Fernandaxx/TallerDeProyectoI/documentation/informe/images/pcb_3d.png

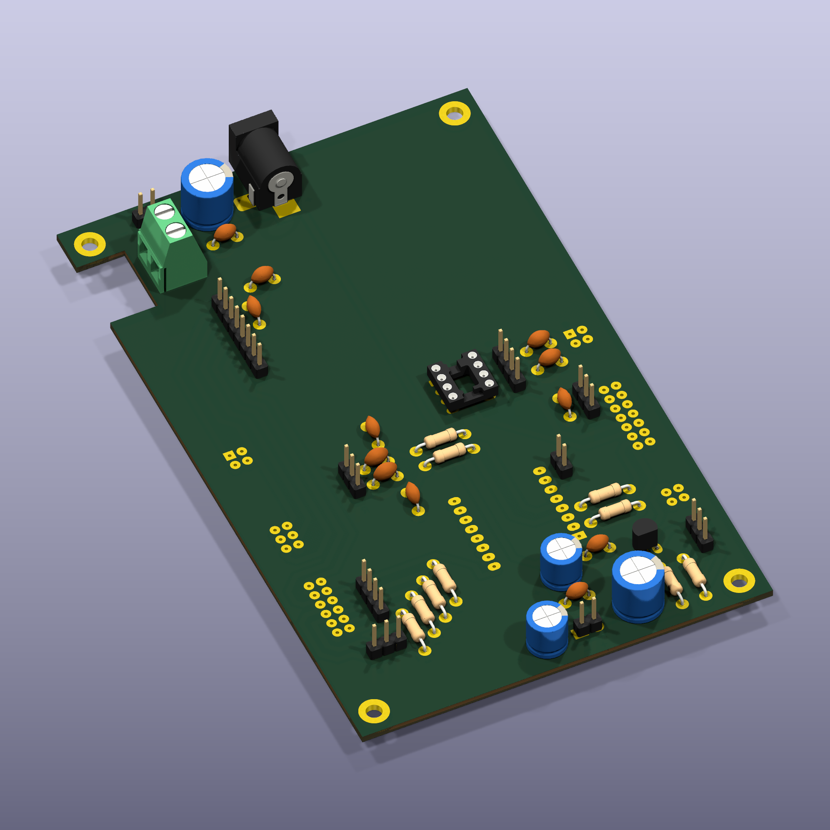
documentation/informe/images/pcb_3d.png
