Fernandaxx/TallerDeProyectoI/ejemplos/sapi/lcd/lcd_i2c/I2C expander PCF8574/LCD I2C.PNG

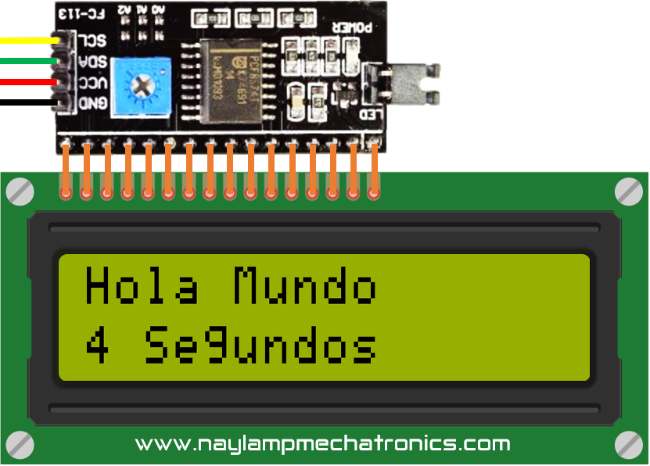
ejemplos/sapi/lcd/lcd_i2c/I2C expander PCF8574/LCD I2C.PNG
