Fernandaxx/TallerDeProyectoI/ejemplos/freertos_book/Readme.md

# Examples of book: "Mastering the FreeRTOS Real Time Kernel, a Hands-On Tutorial Guide" by Richard Barry

https://www.freertos.org/Documentation/RTOS_book.html

- **Example001**: Creating tasks.
- **Example002**: Using the task parameter.
- **Example003**: Experimenting with priorities.
- **Example004**: Using the Blocked state to create delay.
- **Example005**: Converting the example tasks to use vTaskDelayUntil().
- **Example006**: Combining blocking and non-blocking tasks.
- **Example007**: Defining an idle task hook function.
- **Example008**: Changing task priorities.
- **Example009**: Deleting tasks.
- **Example010**: Blocking when receiving from a queue.
- **Example011**: Blocking when sending to a queue or sending structures on a queue.
- **Example012**: Using a queue set.
- **Example013**: Creating one-shot and auto-reload timers.
- **Example014**: Using the callback function parameter and the software timer ID.
- **Example015**: Resetting a software timer.
- **Example016**: Using a binary semaphore to synchronize a task with an interrupt.
- **Example017**: Using a counting semaphore to synchronize a task with an interrupt.
- **Example018**: Centralized deferred interrupt processing.
- **Example019**: Sending and receiving on a queue from within an interrupt.
- **Example020**: Re-writing vPrintString() to use a semaphore.
- **Example021**: Re-writing vPrintString() to use a gatekeeper task.
- **Example022**: Experimenting with event groups.
- **Example023**: Synchronizing tasks.
- **Example024**: Using a task notification in place of a semaphore, method 1.
- **Example025**: Using a task notification in place of a semaphore, method 2.

Examples ported from FreeRTOS v8, to FreeRTOS v10 by Eric Pernia and Martin Ribelotta.

More information at: https://aws.amazon.com/es/freertos/
