Fernandaxx/TallerDeProyectoI/documentation/informe/InformeInicial.pdf

## E0306 - Taller de Proyecto I

# Tocadiscos RFID/NFC

## «Reproductor musical interactivo con selección mediante RFID/NFC»

## Informe inicial

Acuña, Lucia - 03213/1
acunalucia064@gmail.com

Avila Montoya, Eygleen Fernanda - 02931/2 eygleen.avila@alu.ing.unlp.edu.ar

Bejarano, Abril - 03339/5
abril.bejarano@alu.ing.unlp.edu.ar

Seijo, Gerónimo - 01859/7
seijo.geronimo@alu.ing.unlp.edu.ar

Universidad Nacional de La Plata 5 de octubre de 2026

E0306 Taller de Proyecto I
Tocadisco RFID/NFC | Año 2026

## Índice

## 1. Introducción

La forma de escuchar música ha cambiado considerablemente con el avance de la tecnología. Los tocadiscos y discos de vinilo, además de cumplir una función de reproducción, se caracterizan por ofrecer una experiencia física y visual que aún hoy conserva un fuerte valor estético y nostálgico. A partir de esta idea surge el presente proyecto, que busca combinar esa forma de interacción con un sistema de reproducción musical digital.

El proyecto consiste en desarrollar un reproductor musical interactivo controlado por una placa EDU-CIAA-NXP. El usuario seleccionará la música mediante discos físicos impresos que incorporarán etiquetas RFID/NFC. Al colocar un disco sobre el dispositivo, el sistema lo identificará y reproducirá la canción o conjunto de canciones asociado. Además, una pantalla mostrará información básica sobre el estado de reproducción.

En la actualidad, la reproducción de música digital y los sistemas de identificación RFID/NFC son tecnologías ampliamente utilizadas. En este proyecto se combinan para ofrecer una forma de interacción diferente a la de los reproductores convencionales, utilizando un objeto físico para seleccionar contenido digital. Como mejoras adicionales, se contempla incorporar un sistema de asociación configurable entre discos y canciones con almacenamiento persistente e iluminación con secuencias preprogramadas mediante LEDs direccionables.

El principal desafío será integrar y coordinar los distintos componentes mediante la EDU-CIAA-NXP, garantizando el correcto funcionamiento de la identificación, la reproducción de audio, la señalización visual y la alimentación del sistema. De esta manera, el proyecto permitirá aplicar conocimientos de electrónica, programación y sistemas embebidos en el desarrollo de un prototipo funcional.

## 2. Objetivo

## 2.1. Objetivo general

Desarrollar un prototipo funcional de reproductor de música interactivo que, mediante la lectura de etiquetas RFID/NFC, reproduzca pistas de audio almacenadas localmente e incorpore un mecanismo giratorio a modo de tocadiscos, controlado íntegramente por la placa EDU-CIAA-NXP. De forma complementaria, y sujeto a la disponibilidad de tiempo, el prototipo incorpora un modo de asignación de canciones con almacenamiento persistente y secuencias lumínicas con LEDs NeoPixel.

## 2.2. Objetivos primarios

- Identificar cada disco mediante una etiqueta RFID/NFC.
- Asociar cada disco identificado con una canción o conjunto de canciones.
- Reproducir archivos de audio almacenados localmente.
- Mostrar en una pantalla información básica sobre el estado del sistema y la reproducción.
- Integrar los distintos módulos y periféricos bajo el control de la EDU-CIAA-NXP.

- Diseñar una placa de conexión que permita integrar los componentes del sistema de forma ordenada y segura.
- Incorporar un mecanismo que permita hacer girar el disco durante la reproducción, simulando el funcionamiento visual de un tocadiscos.

## 2.3. Objetivos secundarios

- Incorporar LEDs NeoPixel con secuencias preprogramadas según la canción.
- Asignación configurable y persistente de canciones: incorporar un modo de configuración que permita asociar una etiqueta RFID/NFC a una canción sin modificar el código del programa, guardando dicha asociación en una memoria EEPROM externa para que persista tras el reinicio del sistema.
- Incorporar controles físicos para funciones básicas de reproducción, como pausa, cambio de pista o ajuste de volumen.

## 2.4. Descripción técnico-conceptual

El sistema se organiza en torno a la placa EDU-CIAA-NXP, que funciona como unidad central de control y coordina los distintos módulos del proyecto. El lector RFID/NFC MFRC522 se comunica mediante SPI, la pantalla OLED mediante I²C y el módulo de reproducción DFPlayer Mini mediante UART. El procesamiento del audio es realizado por el propio DFPlayer Mini, mientras que la EDU-CIAA se encarga de controlar el funcionamiento general del sistema. En la Fig. 1 se presenta el diagrama en bloques del sistema a desarrollar.

El funcionamiento comienza cuando el usuario coloca un disco sobre el reproductor. El lector RFID/NFC obtiene el identificador de la etiqueta incorporada al disco y la EDU-CIAA busca la canción o lista de canciones asociada. A continuación, envía al DFPlayer Mini la orden de reproducción del archivo almacenado en la tarjeta microSD. La señal de audio se dirige al amplificador PAM8403 y posteriormente al parlante, mientras que la pantalla OLED muestra información sobre el estado de la reproducción y el motor paso a paso 28BYJ-48 con su controlador ULN2003 hace girar el disco mientras se reproduce la música.

Como objetivos secundarios, se prevé una memoria EEPROM externa para almacenar las asociaciones entre las etiquetas RFID/NFC y las canciones, permitiendo conservarlas aun después de apagar o reiniciar el sistema. La EEPROM compartiría el bus I²C con la pantalla OLED. Asimismo, se contempla incorporar una tira o arreglo de LEDs NeoPixel conectados a un pin GPIO de la placa para generar secuencias visuales preprogramadas acordes a la canción en reproducción.

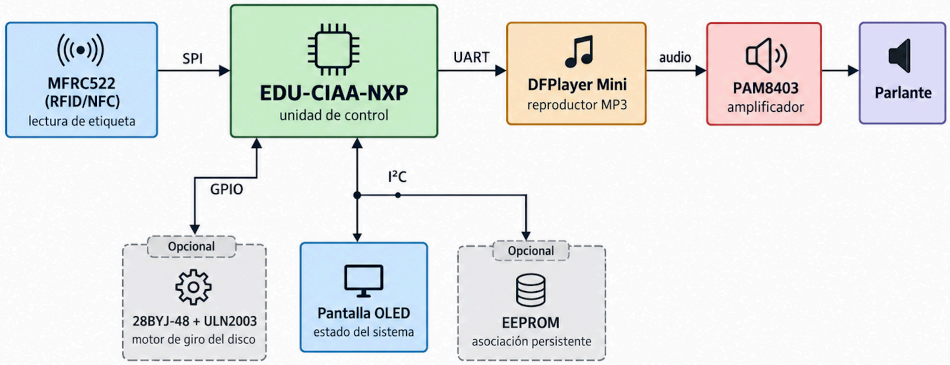
[picture p89: figure]

Fig. 1: Diagrama en bloques del sistema.

## 2.4.1. Alimentación del sistema

La alimentación del sistema partirá de una fuente de 5 V. Los módulos de audio y el motor utilizarán el dominio de 5 V, mientras que los dispositivos que trabajan con lógica de 3,3 V utilizarán el correspondiente nivel de alimentación. De implementarse los LEDs NeoPixel, se alimentarán también desde la línea de 5 V contemplando su demanda de corriente.

La EDU-CIAA-NXP dispone de líneas de 5 V y 3,3 V en sus conectores de expansión. Todos los módulos compartirán una referencia de masa común (GND). En la Fig. 2 se presenta el esquema general de alimentación previsto para el sistema.

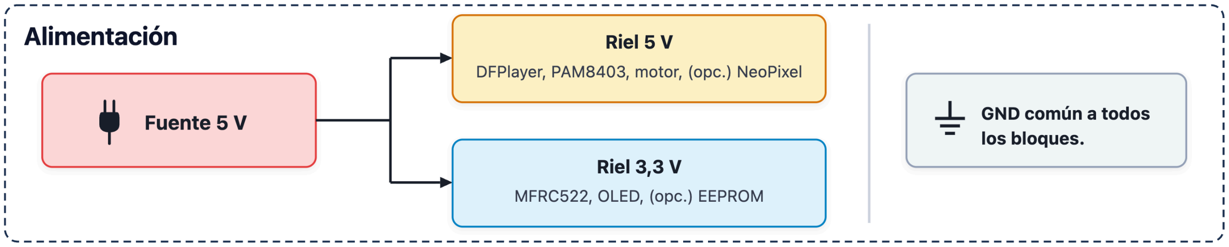
[picture p90: figure]

Fig. 2: Esquema general de alimentación del sistema.

## 3. Análisis de requerimientos

## 3.1. Requerimientos funcionales de hardware

## 3.1.1. Primarios

1. El sistema debe utilizar la placa EDU-CIAA-NXP como unidad central de control.
2. Debe incorporar un lector MFRC522 para identificar etiquetas RFID/NFC mediante comunicación SPI.
3. Debe incorporar un módulo DFPlayer Mini para reproducir archivos de audio almacenados en una tarjeta microSD y comunicarse con la EDU-CIAA mediante UART.

4. Debe incorporar un amplificador PAM8403 y un parlante compatible para la reproducción del audio.
5. Debe incorporar una pantalla OLED comunicada mediante I²C para mostrar información del sistema.
6. El sistema debe contar con una alimentación de 5 V y disponer de los niveles de tensión necesarios para los módulos que trabajen a 3,3 V, manteniendo una masa común.
7. Los módulos externos deben integrarse mediante una placa tipo poncho (PCB) compatible con los conectores de expansión de la EDU-CIAA-NXP.
8. Debe incorporar un motor paso a paso 28BYJ-48 con controlador ULN2003 para hacer girar el disco durante la reproducción.

## 3.1.2. Secundarios

9. Podrá incorporarse una tira o arreglo de LEDs RGB direccionables tipo NeoPixel (WS2812B), controlados por la EDU-CIAA-NXP, para ejecutar secuencias y efectos lumínicos preprogramados según la canción en reproducción.
10. Podrá incorporarse una memoria EEPROM externa comunicada mediante I²C para almacenar las asociaciones entre etiquetas y canciones.
11. La placa de conexión deberá prever las conexiones necesarias para incorporar los módulos secundarios sin requerir un rediseño completo.

## 3.2. Requerimientos funcionales de software

## 3.2.1. Primarios

1. El sistema debe detectar una etiqueta RFID/NFC y obtener su identificador único.
2. Cada identificador registrado debe estar asociado a una canción o conjunto de canciones almacenadas en la tarjeta microSD.
3. Al detectar una etiqueta registrada, el sistema debe iniciar la reproducción del contenido asociado.
4. El sistema debe mostrar en la pantalla OLED el estado del sistema y la información de la pista en reproducción.
5. Ante una etiqueta no registrada, el sistema no debe iniciar ninguna reproducción y debe informar dicha condición al usuario.
6. El sistema debe gestionar de forma no bloqueante la lectura del RFID y la actualización de la pantalla, manteniendo la responsividad.
7. El sistema debe controlar el giro del motor de manera coordinada con la reproducción de audio

## 3.2.2. Secundarios

8. El sistema podrá controlar secuencias luminosas preprogramadas en los LEDs NeoPixel en función de la canción en reproducción.
9. Podrá incorporarse un modo de configuración que permita asociar una etiqueta RFID/ NFC a una canción sin modificar el código del programa.
10. Las asociaciones realizadas podrán almacenarse en una memoria EEPROM para conservarse después de apagar o reiniciar el sistema.
11. Podrán incorporarse controles físicos para funciones básicas como pausa, cambio de pista o ajuste de volumen.

## 3.3. Requerimientos no funcionales

1. El desarrollo deberá realizarse utilizando la plataforma EDU-CIAA-NXP.
2. El hardware debe diseñarse de forma modular, permitiendo probar los distintos módulos de manera individual antes de realizar la integración completa.
3. La placa tipo poncho no deberá superar las dimensiones generales de la EDU-CIAA-NXP.
4. La alimentación deberá respetar las tensiones de funcionamiento de cada módulo y mantener una masa común entre todos los componentes.
5. Las funciones principales del sistema deberán ser ensayadas y validadas tanto de manera individual como durante la integración final.
6. Los diseños de hardware y software, las modificaciones realizadas y los resultados de los ensayos deberán quedar documentados en los informes del proyecto.
7. El desarrollo deberá ajustarse a las fechas establecidas en el cronograma de la cátedra.

## 4. Cronograma preliminar

El desarrollo del proyecto se organizó en etapas sucesivas que comprenden el análisis inicial, la investigación de componentes, el diseño de hardware y software, el desarrollo del código, la fabricación, la integración y las pruebas finales. La planificación se realizó tomando como referencia el cronograma propuesto por la cátedra y los requerimientos definidos para el sistema.

Las entregas formales de la materia se consideran hitos de control que permiten evaluar el avance del proyecto y marcar el cierre de las principales etapas de desarrollo. Durante septiembre y octubre se concentrarán principalmente las tareas de investigación y diseño, mientras que entre octubre y noviembre se avanzará con la programación, el diseño y fabricación de la placa y las pruebas individuales de los distintos módulos. Durante diciembre se prevé realizar la integración, los ensayos y la validación del prototipo.

En la Tabla 1 se presenta el diagrama de Gantt preliminar del proyecto, donde se indican las principales tareas, su distribución temporal y los hitos previstos.

Tabla 1: Diagrama de Gantt por etapas, con meta de presentación en diciembre de 2026.

Tarea | Ago | 1ª Sep | 2ª Sep | 1ª Oct | 2ª Oct | 1ª Nov | 2ª Nov | 1ª Dic | 2ª Dic
Etapa inicial
Elección y definición del proyecto
Etapa de investigación
Análisis de componentes y protocolos Definición de requerimientos y arquitectura Etapa de diseño
Diseño del esquemático y pines EDU-CIAA Diseño de la arquitectura del firmware Diseño del PCB (poncho)
Desarrollo de código
Pruebas unitarias por módulo RFID Pruebas unitarias por módulo DFPlayer Pruebas unitarias por módulo OLED Firmware del núcleo (máquina de estados) Etapa final
Fabricación y soldado del PCB Ensamblaje e integración del prototipo Estructura física del tocadiscos Pruebas de validación del sistema Motor + giro del disco
(Opcional) LEDs NeoPixel + secuencias (Opcional) EEPROM + modo asignación
Documentación e informe final
Entregas formales (hitos)
Informe Inicial - 10/09/2026 | ◆
Informe de Avance 1 - 05/10/2026 | | ◆
Informe de Avance 2 - 05/11/2026 | | | ◆
Presentación (meta del grupo) | | | | ◆
Referencias: inicial · | investigación · | diseño · | desarrollo · | etapa final · | opcional · ◆ hito.

## 5. División de tareas del grupo

Con el fin de organizar el desarrollo y permitir el trabajo en paralelo, las principales tareas del proyecto se distribuyeron entre los integrantes del grupo. Cada integrante tendrá responsabilidades principales sobre determinados bloques del sistema, aunque las etapas de integración, pruebas, validación y documentación se realizarán de manera conjunta.

En la Tabla 2 se presenta la división preliminar de tareas del grupo. Esta distribución podrá ajustarse durante el desarrollo en función del avance del proyecto y de las necesidades que surjan en cada etapa.

Tabla 2: División preliminar de tareas entre los integrantes del grupo.
Integrante | Responsabili-dad principal | Tareas asignadas
Acuña, Lucía | Identificación RFID/NFC | • Integración y pruebas del lector MFRC522. • Lectura e identificación de etiquetas. • Asociación entre etiquetas y canciones. • Integración y programación de los LEDs NeoPixel en caso de abordar el objetivo secundario. • Implementación de la EEPROM en caso de abordar el objetivo secundario.
Avila, Fernanda | Reproducción y sistema de audio | • Integración y pruebas del DFPlayer Mini. • Manejo de la tarjeta microSD y reproducción de archivos. • Integración del amplificador PAM8403 y parlante. • Análisis y verificación de la alimentación del sis-tema.
Bejarano, Abril | Interfaz y es-tructura física | • Integración y programación de la pantalla OLED. • Diseño de la información mostrada al usuario. • Diseño y desarrollo de la estructura física del toca-discos. • Integración del motor de giro.
Seijo, Gerónimo | Firmware e in-tegración de hardware | • Diseño de la arquitectura general del firmware. • Integración de los distintos módulos en la EDU-CIAA-NXP. • Selección de pines y diseño del esquemático. • Diseño de la PCB tipo poncho.

Tareas compartidas por todo el grupo

Integración final del prototipo, pruebas y validación del sistema, resolución de problemas, revisión del diseño, elaboración de los informes y preparación de la presentación del proyecto.

## 6. Bibliografía

- [1] Proyecto CIAA, «Computadora Industrial Abierta Argentina». URL: http://www.proyecto-ciaa.com.ar/
- [2] Biblioteca sAPI, EDU-CIAA. URL: https://github.com/epernia/firmware_v3
- [3] DFRobot, «DFPlayer Mini — hoja de datos y comandos». URL: https://wiki.dfrobot.com/DFPlayer_Mini_SKU_DFR0299 (https://wiki.dfrobot.com/DFPlayer_Mini_SKU_DFR0299)
- [4] NXP, «MFRC522 — Standard performance MIFARE and NTAG frontend».
- [5] Driver ULN2003 y motor 28BYJ-48 — hojas de datos.
- [6] Controlador SSD1306 / SH1106 para display OLED — hojas de datos.
- [7] Memoria EEPROM I²C 24LC256 (256K / 32K×8) — hoja de datos.
- [8] Worldsemi, «WS2812B Intelligent control LED integrated light source» — hoja de datos.
