Fernandaxx/TallerDeProyectoI/documentation/DATASHEETS/fader B10K.jpeg

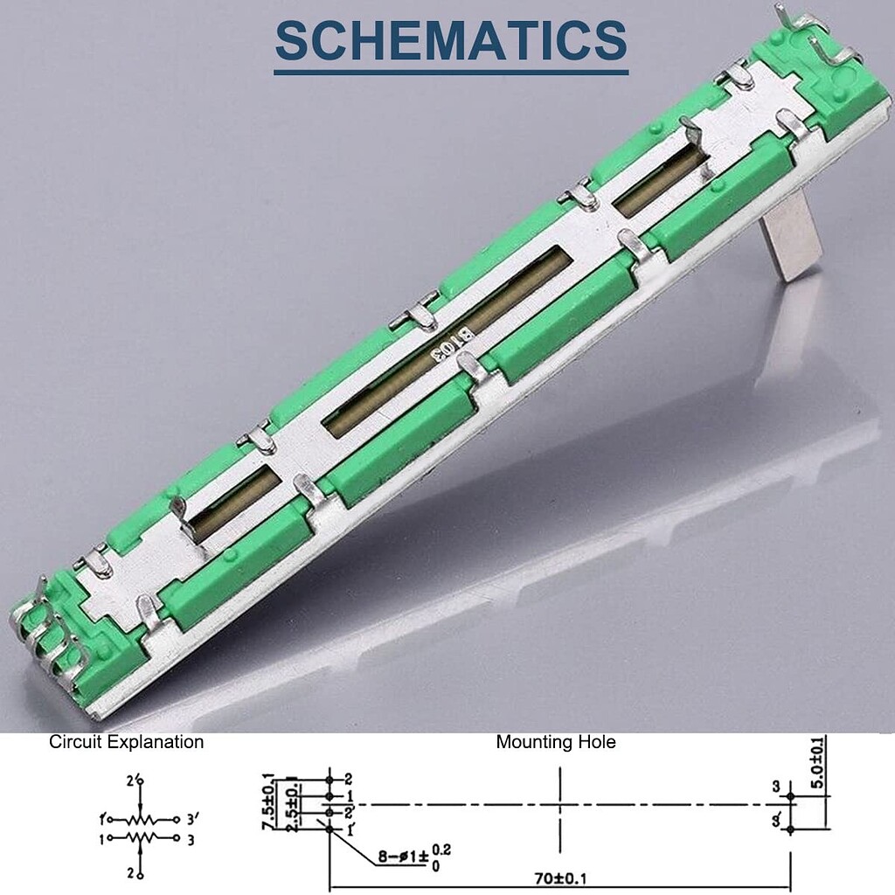
documentation/DATASHEETS/fader B10K.jpeg
