Fernandaxx/TallerDeProyectoI/documentation/DATASHEETS/pinout DFPlayer.png

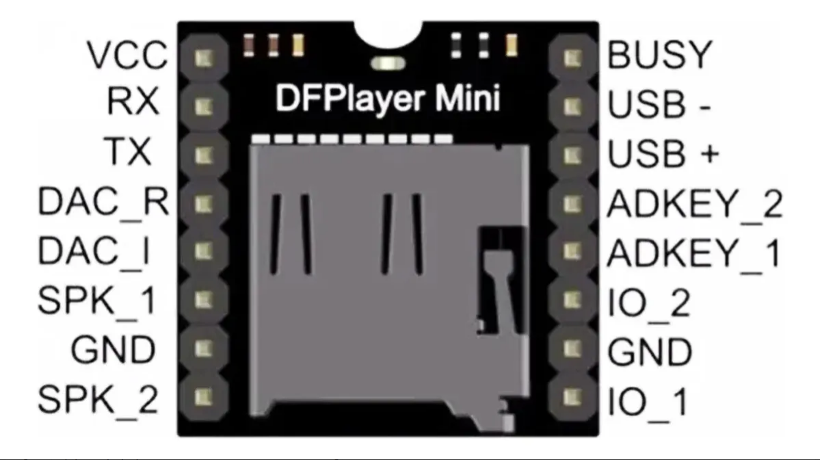
documentation/DATASHEETS/pinout DFPlayer.png
