Fernandaxx/TallerDeProyectoI/documentation/firmware/eclipse/Eclipse-Win01.png

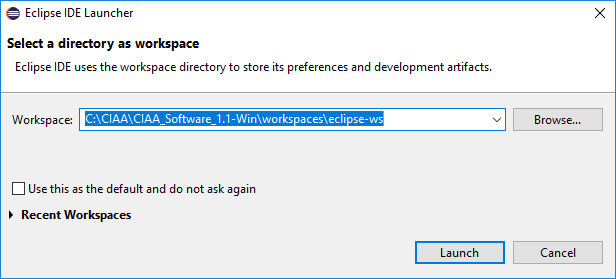
documentation/firmware/eclipse/Eclipse-Win01.png
