Fernandaxx/TallerDeProyectoI/documentation/firmware/eclipse/Eclipse-Win02.png

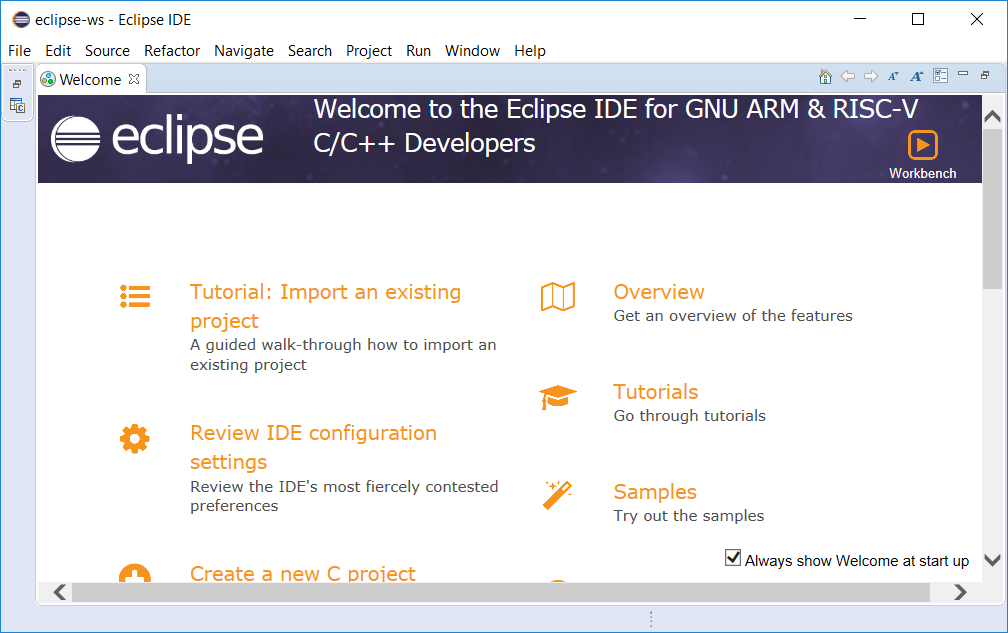
documentation/firmware/eclipse/Eclipse-Win02.png
