Fernandaxx/TallerDeProyectoI/documentation/firmware/eclipse/Eclipse-Win03.png

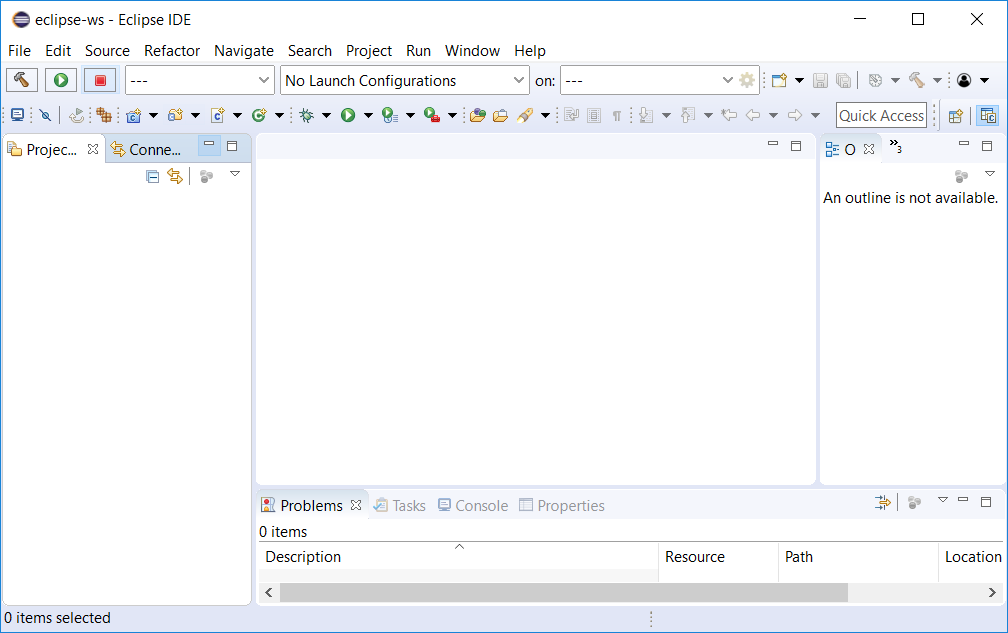
documentation/firmware/eclipse/Eclipse-Win03.png
