Fernandaxx/TallerDeProyectoI/documentation/firmware/eclipse/Eclipse-Win04.png

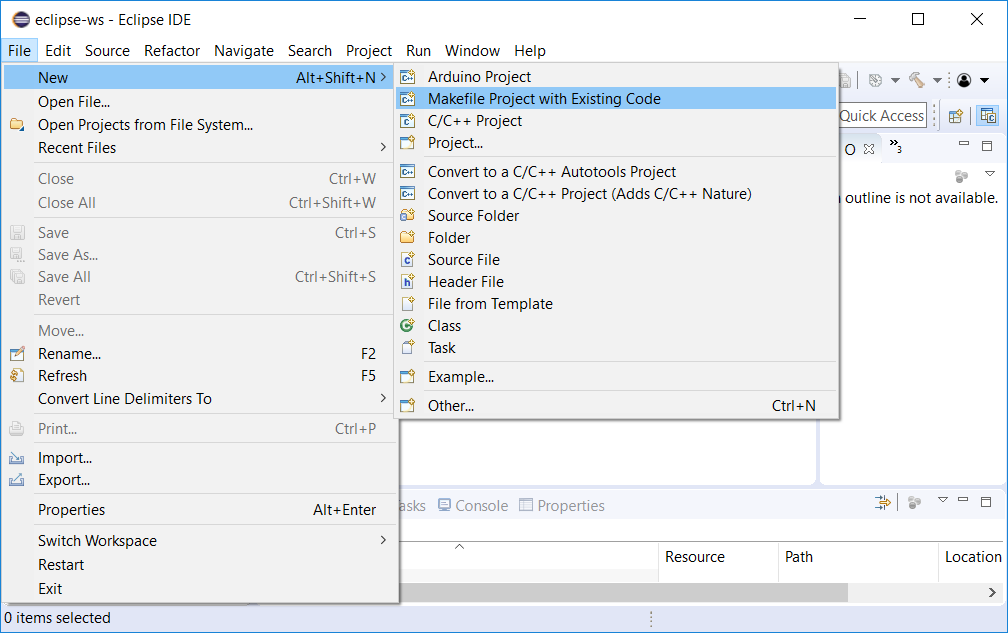
documentation/firmware/eclipse/Eclipse-Win04.png
