Fernandaxx/TallerDeProyectoI/documentation/firmware/eclipse/Eclipse-Win05.png

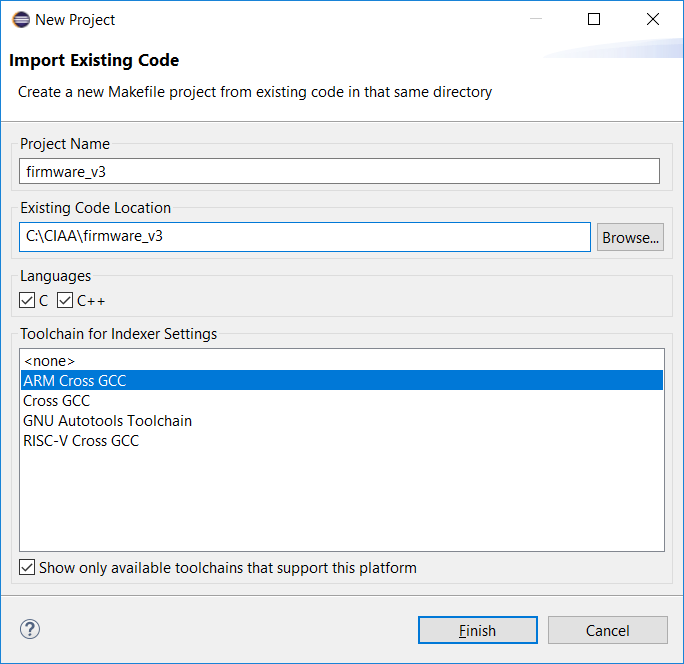
documentation/firmware/eclipse/Eclipse-Win05.png
