Fernandaxx/TallerDeProyectoI/documentation/firmware/eclipse/Eclipse-Win06.png

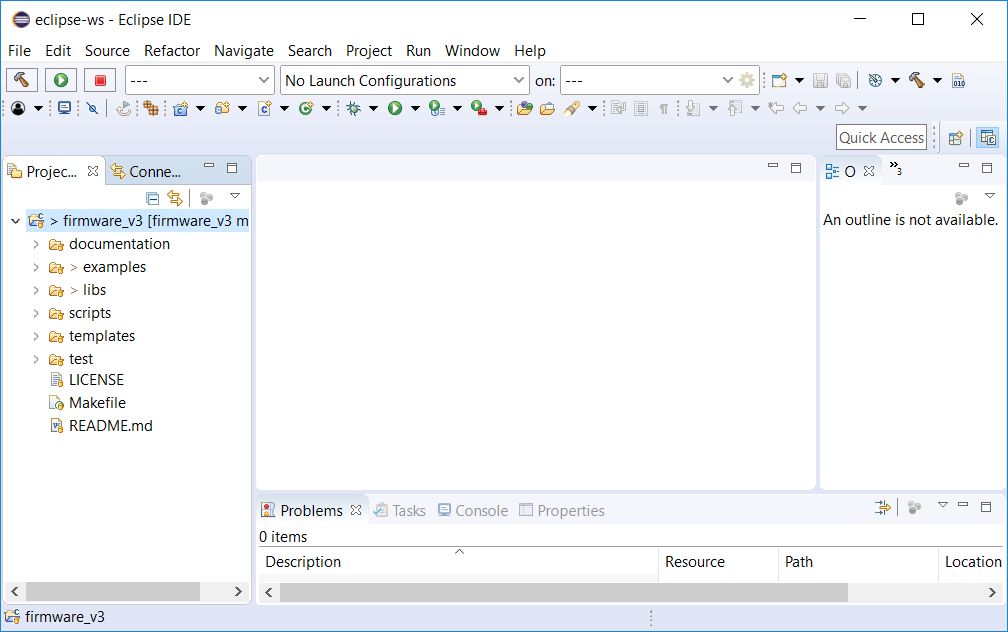
documentation/firmware/eclipse/Eclipse-Win06.png
