Fernandaxx/TallerDeProyectoI/documentation/firmware/eclipse/Eclipse-Win07.png

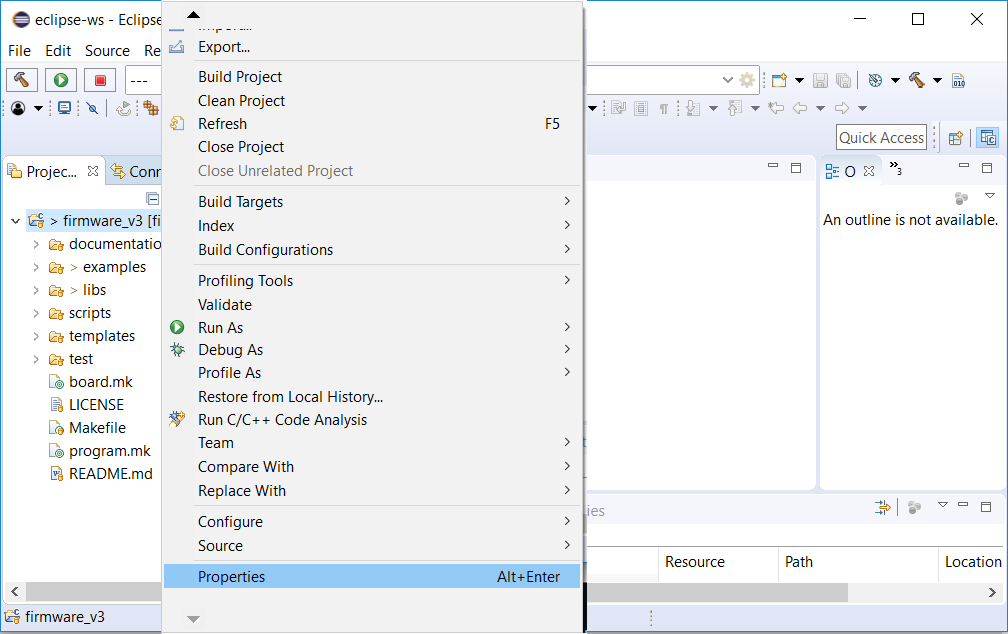
documentation/firmware/eclipse/Eclipse-Win07.png
