Fernandaxx/TallerDeProyectoI/documentation/firmware/eclipse/Eclipse-Win08.png

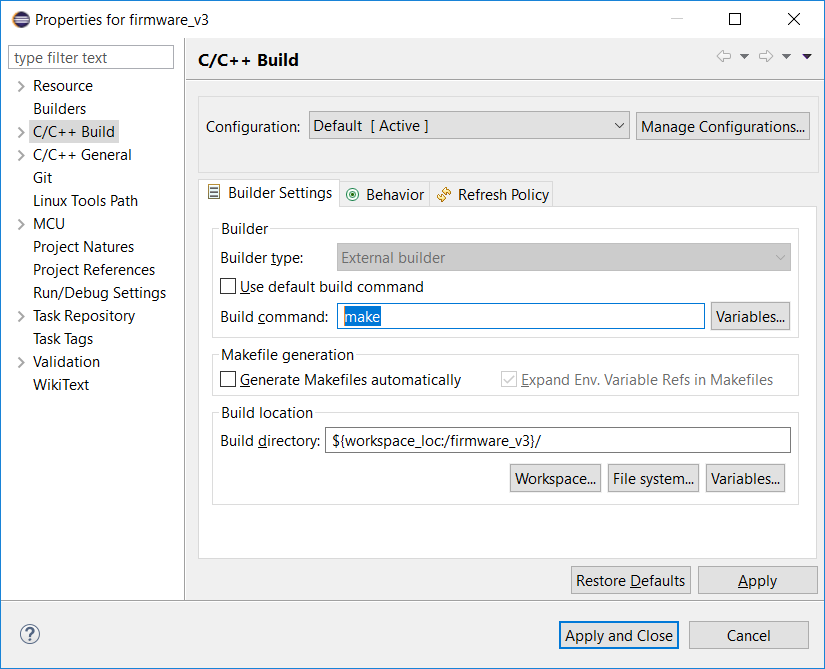
documentation/firmware/eclipse/Eclipse-Win08.png
