Fernandaxx/TallerDeProyectoI/documentation/firmware/eclipse/Eclipse-Win10.png

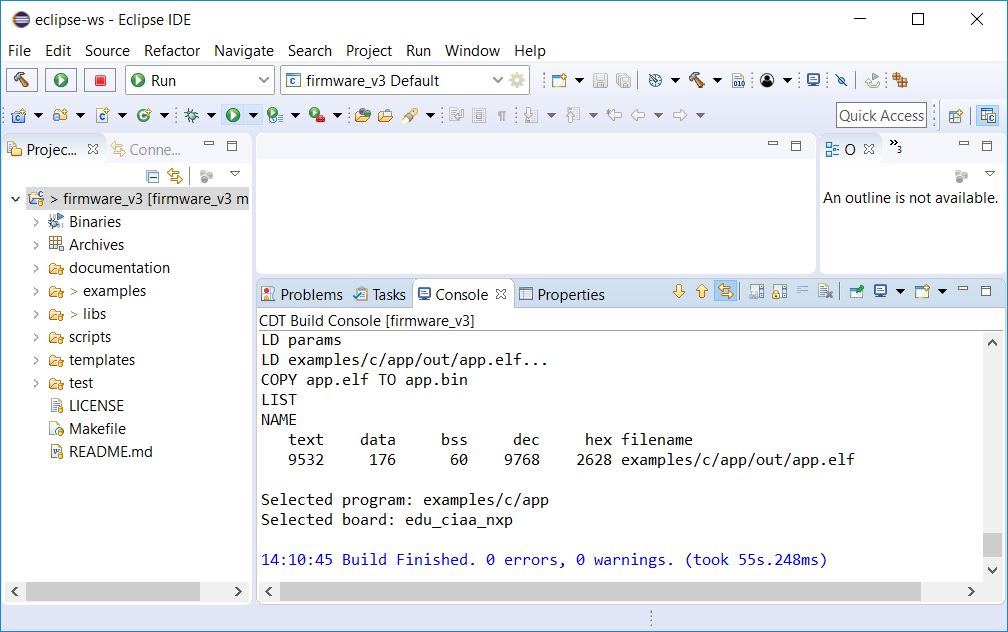
documentation/firmware/eclipse/Eclipse-Win10.png
