Fernandaxx/TallerDeProyectoI/documentation/firmware/eclipse/Eclipse-Win11.png

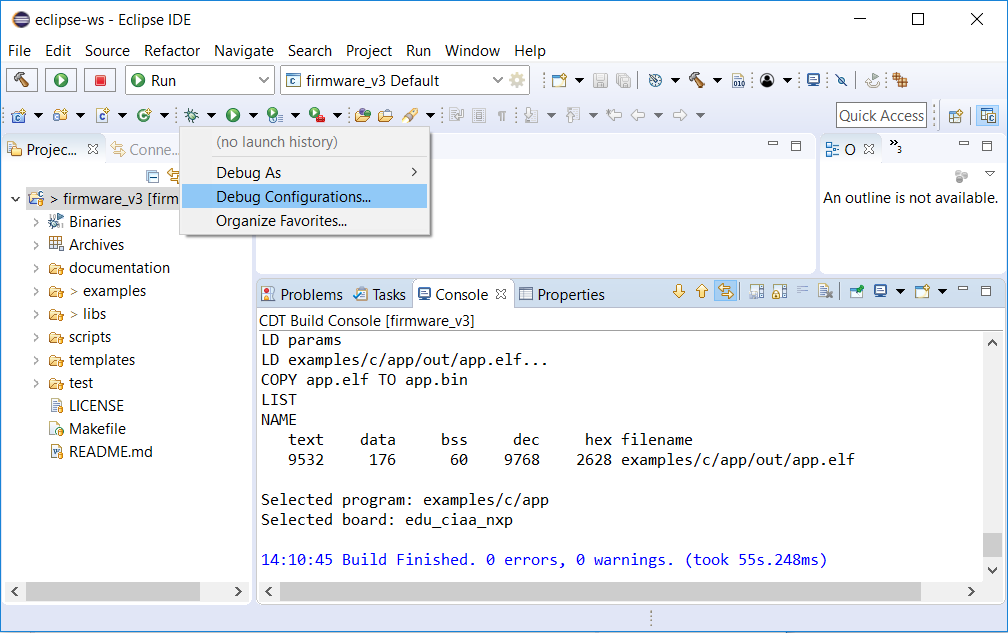
documentation/firmware/eclipse/Eclipse-Win11.png
