Fernandaxx/TallerDeProyectoI/documentation/firmware/eclipse/Eclipse-Win12.png

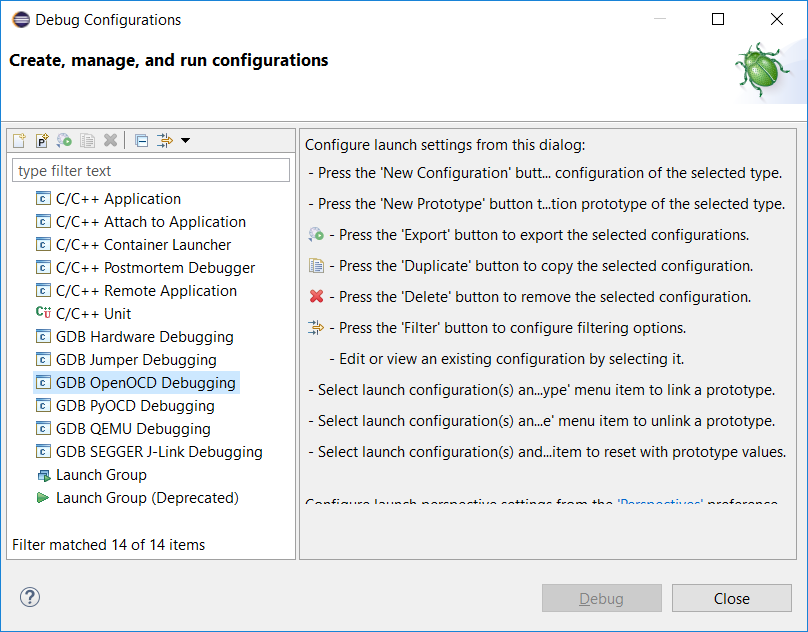
documentation/firmware/eclipse/Eclipse-Win12.png
