Fernandaxx/TallerDeProyectoI/documentation/firmware/eclipse/Eclipse-Win13.png

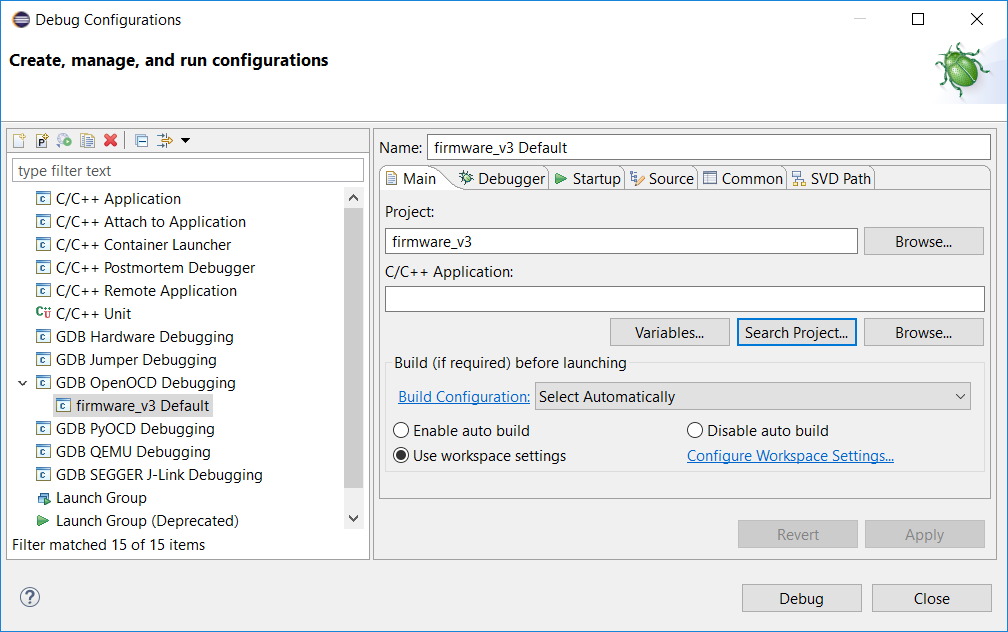
documentation/firmware/eclipse/Eclipse-Win13.png
