Fernandaxx/TallerDeProyectoI/documentation/firmware/eclipse/Eclipse-Win14.png

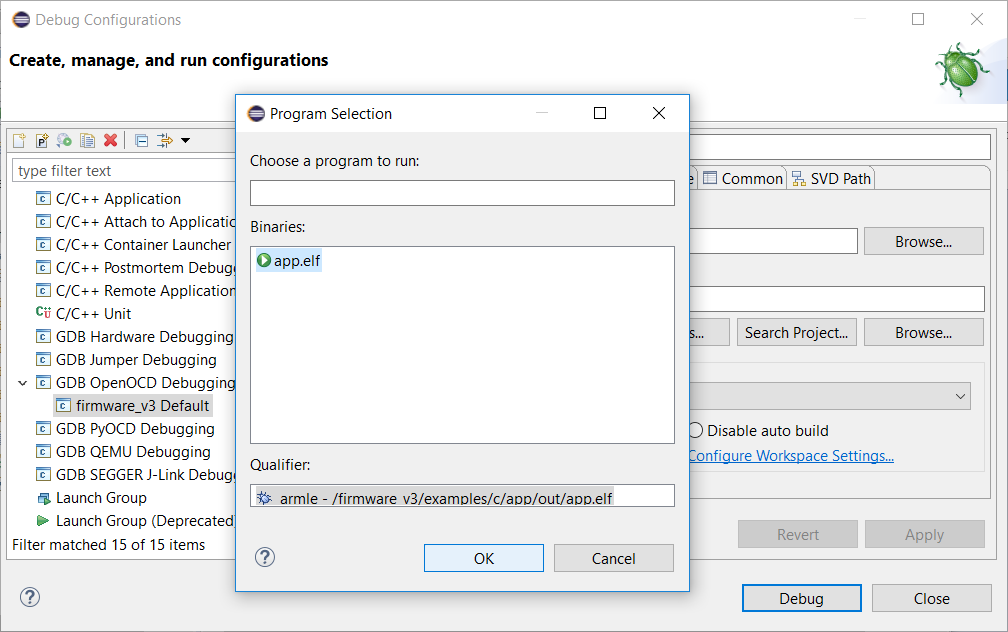
documentation/firmware/eclipse/Eclipse-Win14.png
