Fernandaxx/TallerDeProyectoI/documentation/firmware/eclipse/Eclipse-Win16.png

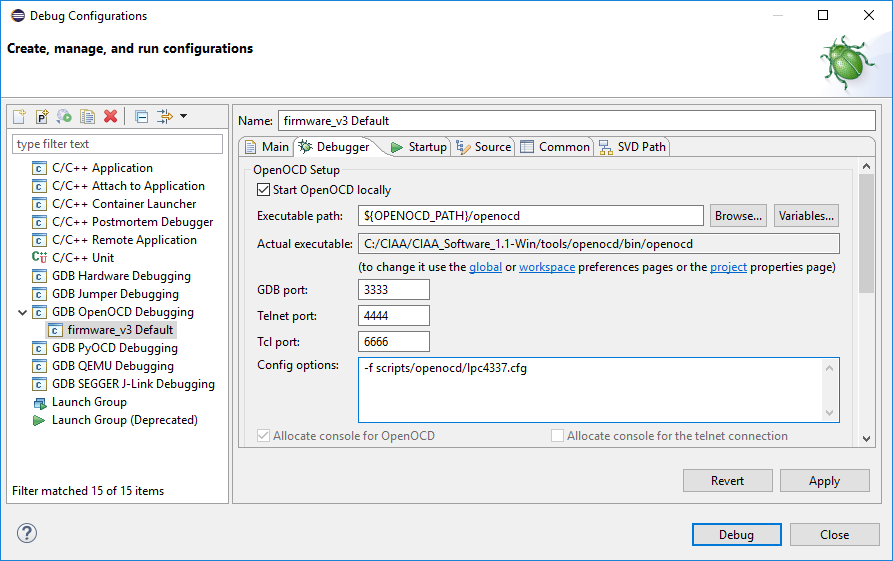
documentation/firmware/eclipse/Eclipse-Win16.png
