Fernandaxx/TallerDeProyectoI/documentation/firmware/eclipse/Eclipse-Win17.png

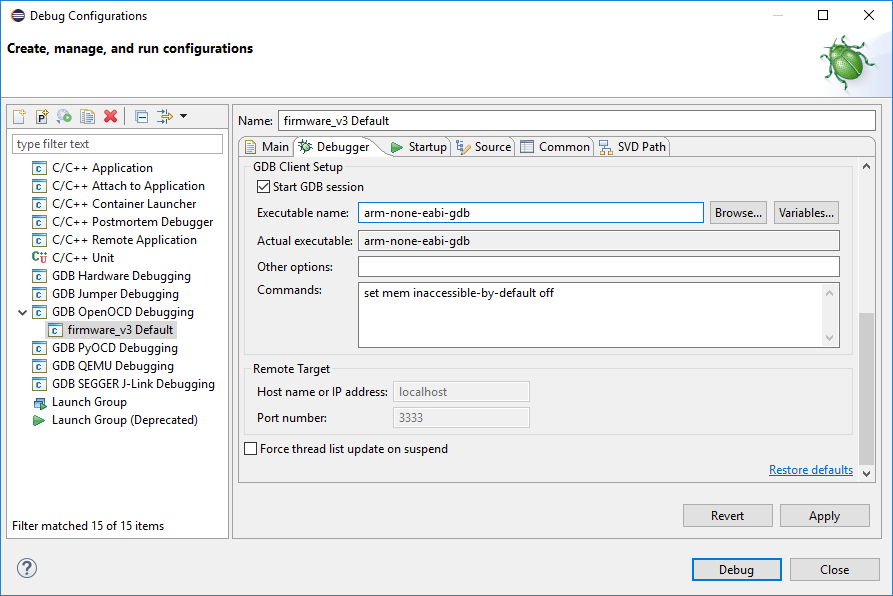
documentation/firmware/eclipse/Eclipse-Win17.png
