Fernandaxx/TallerDeProyectoI/documentation/firmware/eclipse/Eclipse-Win18.png

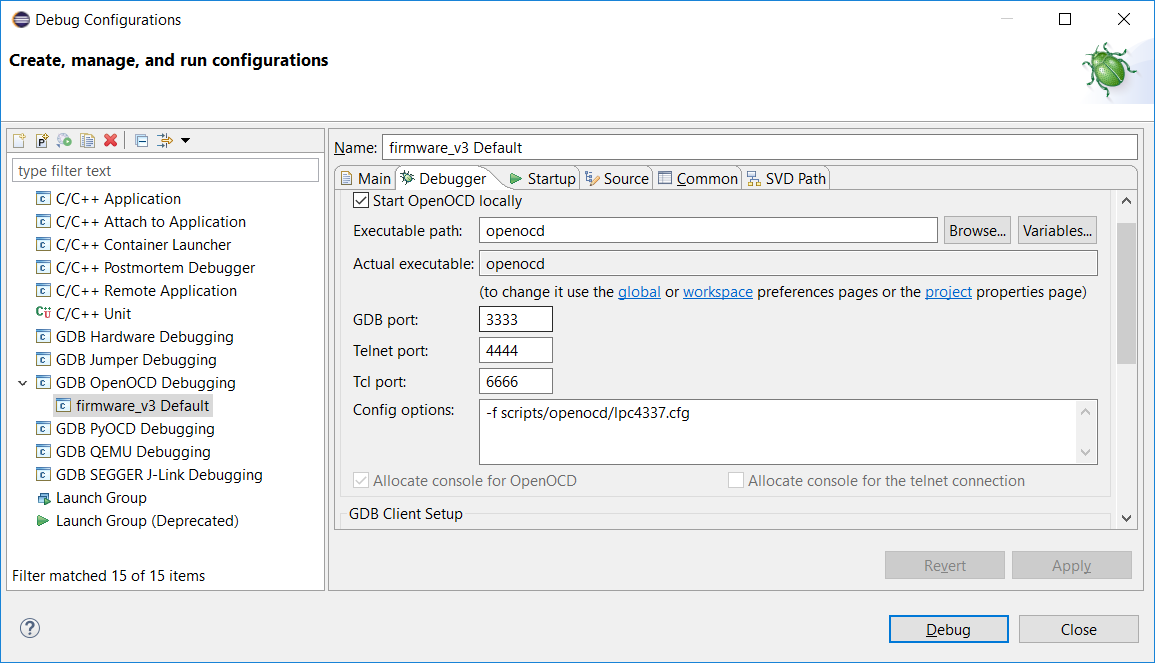
documentation/firmware/eclipse/Eclipse-Win18.png
