Fernandaxx/TallerDeProyectoI/documentation/firmware/eclipse/Eclipse-Win19.png

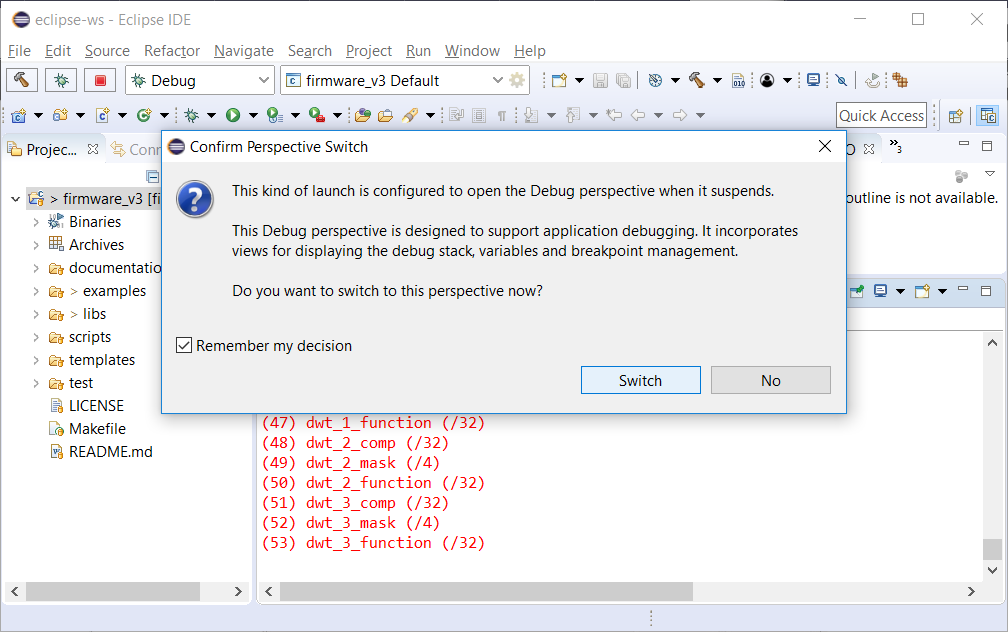
documentation/firmware/eclipse/Eclipse-Win19.png
