Fernandaxx/TallerDeProyectoI/documentation/firmware/eclipse/Eclipse-Win20.png

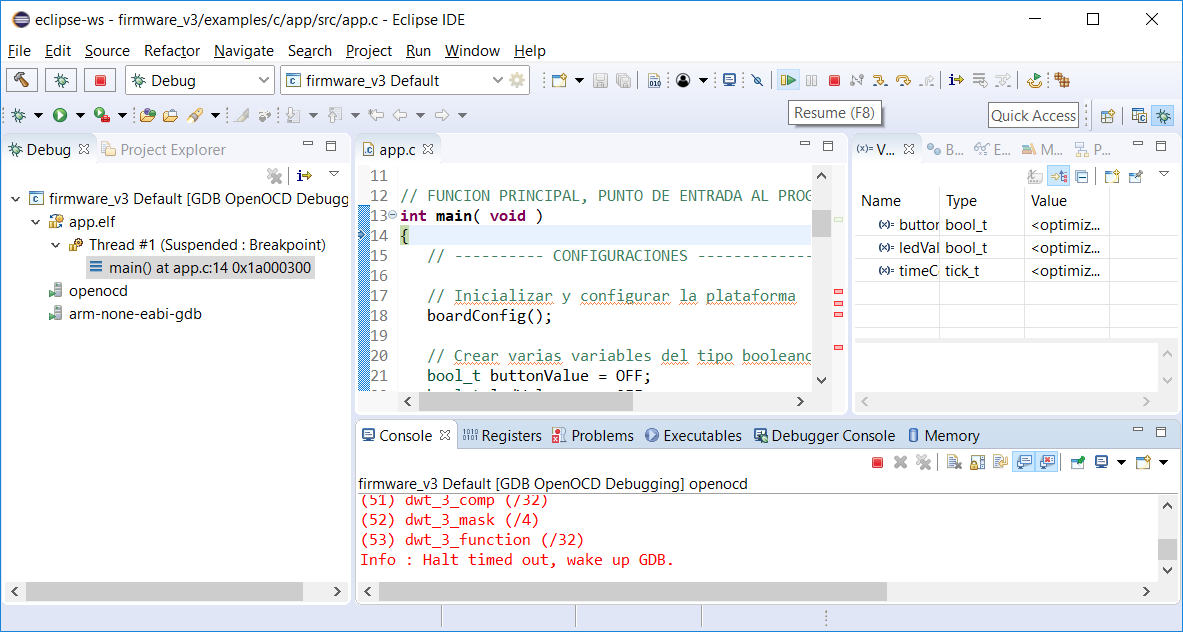
documentation/firmware/eclipse/Eclipse-Win20.png
