Fernandaxx/TallerDeProyectoI/documentation/firmware/eclipse/Eclipse-Win22.png

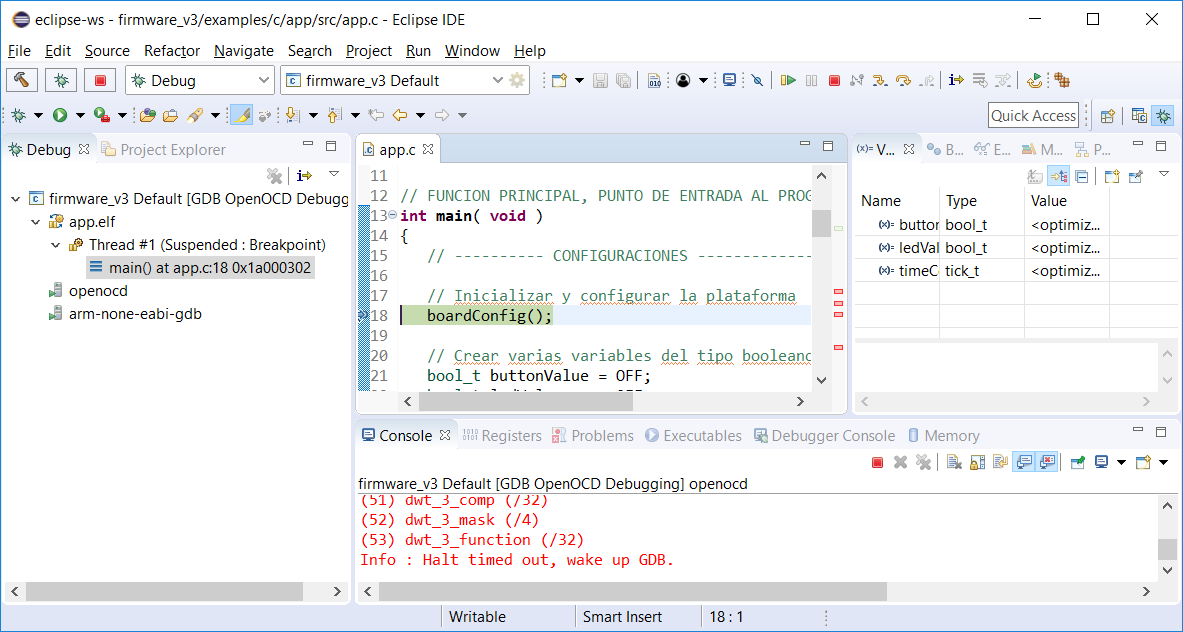
documentation/firmware/eclipse/Eclipse-Win22.png
