Fernandaxx/TallerDeProyectoI/documentation/firmware/eclipse/targets-01.png

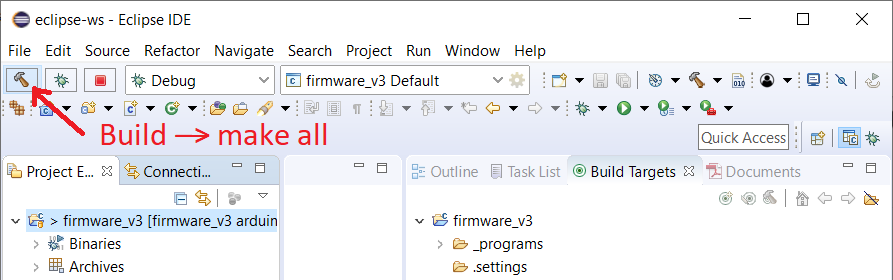
documentation/firmware/eclipse/targets-01.png
