Fernandaxx/TallerDeProyectoI/documentation/firmware/eclipse/targets-02.png

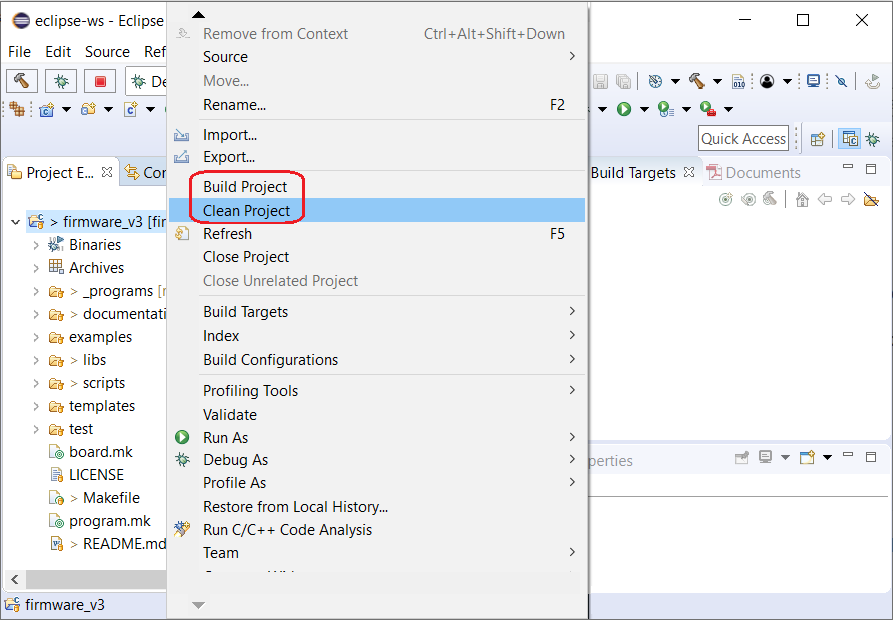
documentation/firmware/eclipse/targets-02.png
