Fernandaxx/TallerDeProyectoI/documentation/firmware/eclipse/targets-03.png

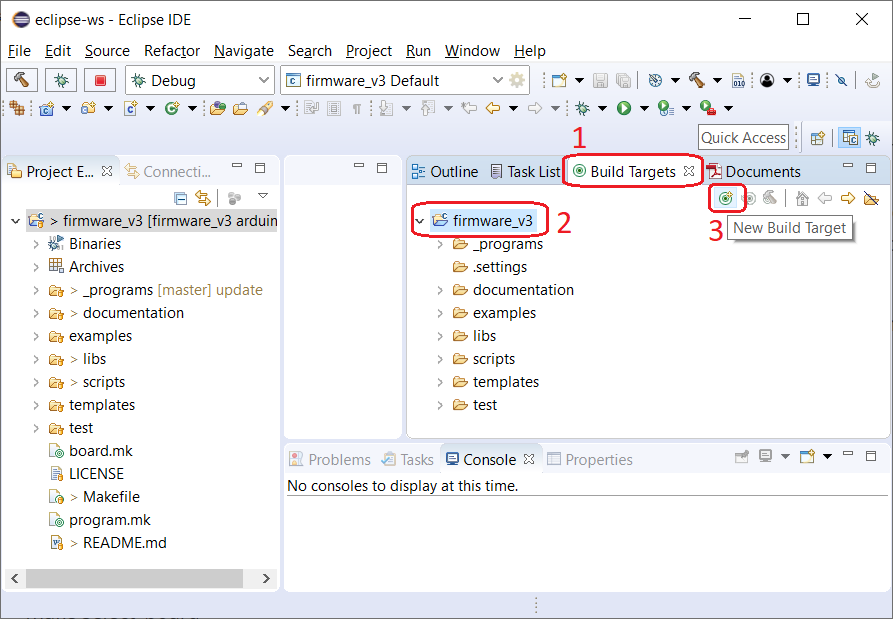
documentation/firmware/eclipse/targets-03.png
