Fernandaxx/TallerDeProyectoI/documentation/firmware/eclipse/targets-04.png

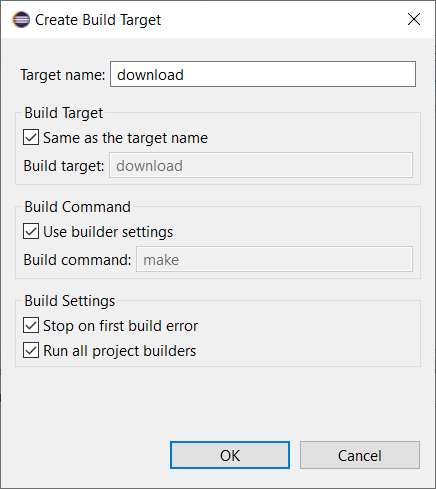
documentation/firmware/eclipse/targets-04.png
