Fernandaxx/TallerDeProyectoI/documentation/firmware/eclipse/targets-05.png

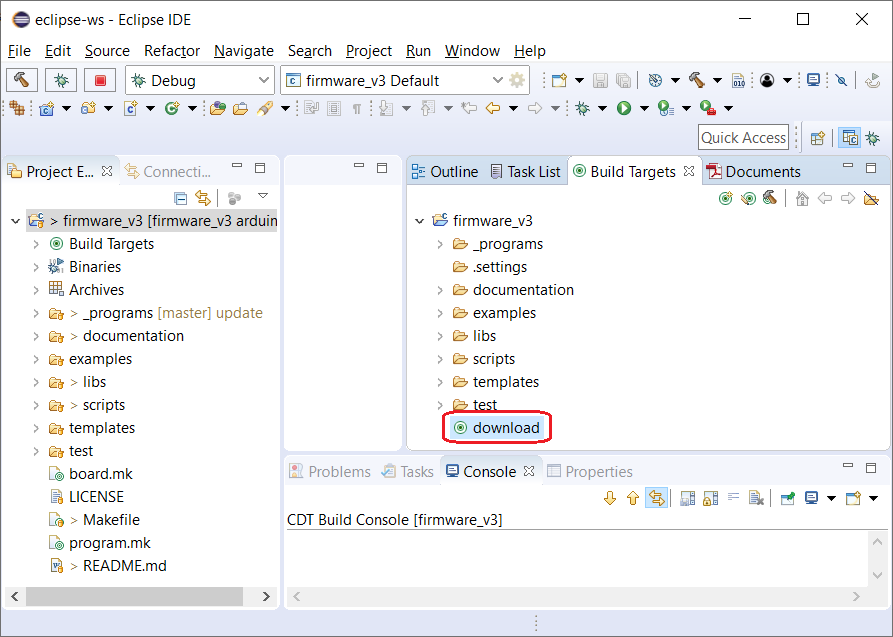
documentation/firmware/eclipse/targets-05.png
