Fernandaxx/TallerDeProyectoI/documentation/firmware/embedded_ide/open01.png

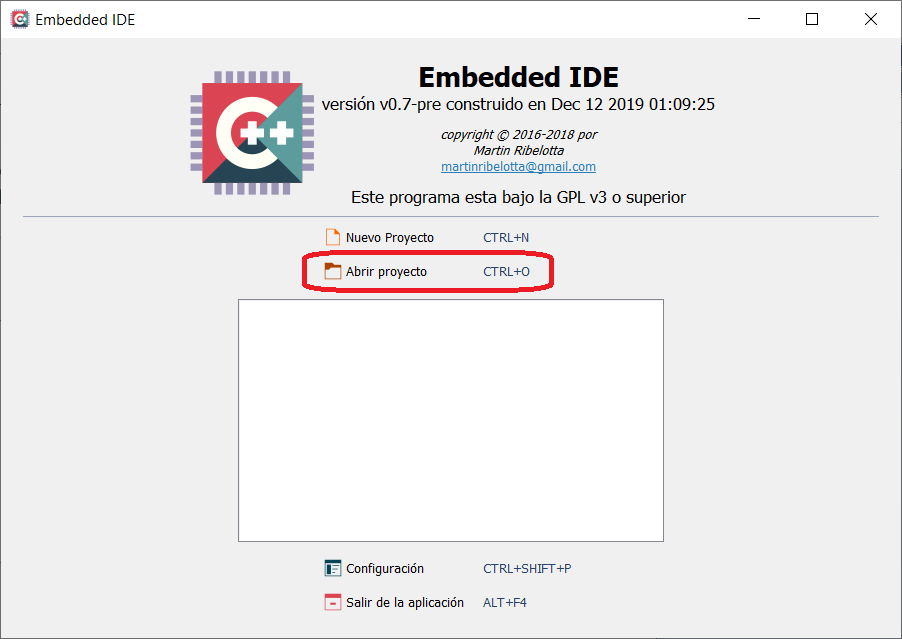
documentation/firmware/embedded_ide/open01.png
