Fernandaxx/TallerDeProyectoI/documentation/firmware/embedded_ide/open02.png

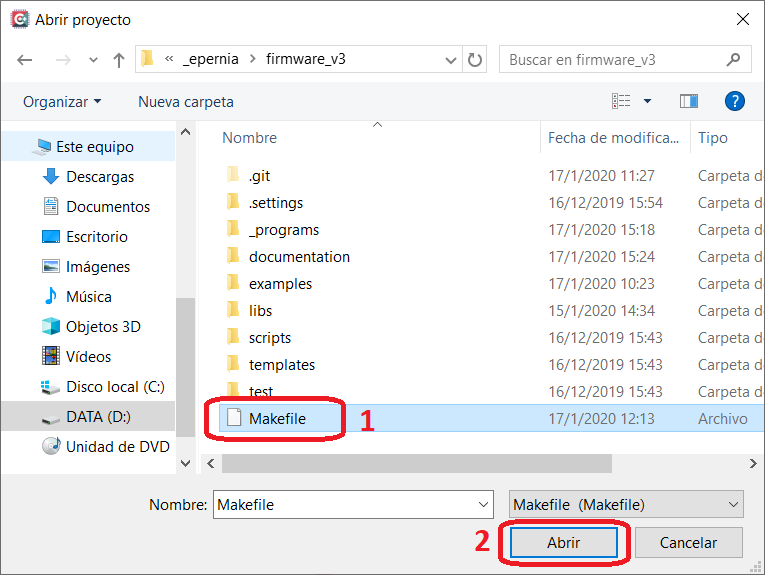
documentation/firmware/embedded_ide/open02.png
