Fernandaxx/TallerDeProyectoI/documentation/firmware/embedded_ide/open03.png

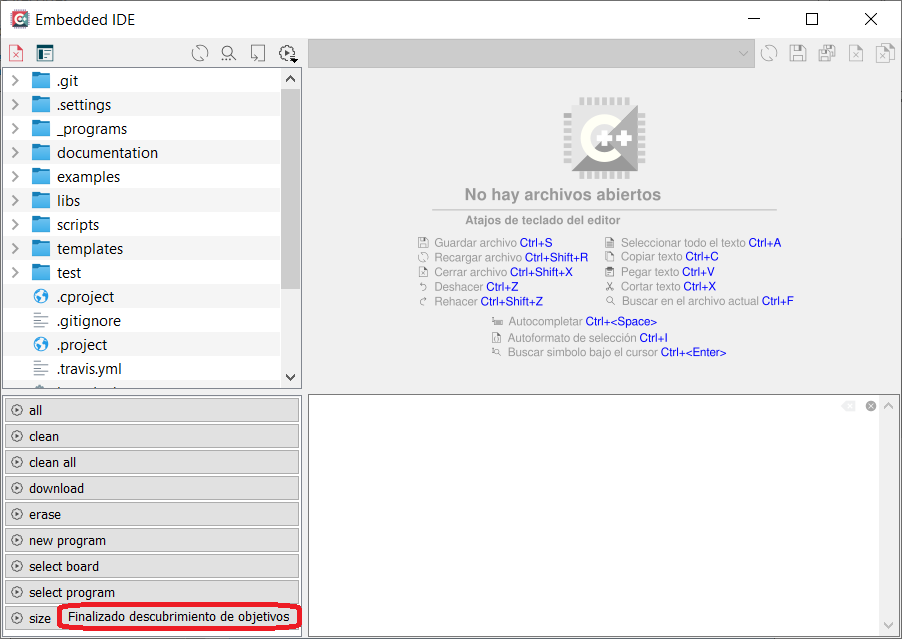
documentation/firmware/embedded_ide/open03.png
