Fernandaxx/TallerDeProyectoI/documentation/firmware/embedded_ide/targets.png

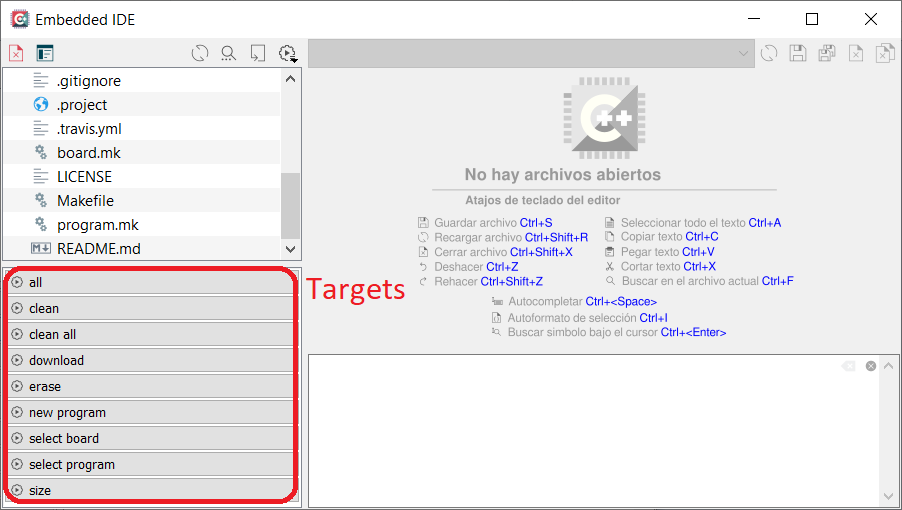
documentation/firmware/embedded_ide/targets.png
