Fernandaxx/TallerDeProyectoI/documentation/informe/images/diagrama_mef.png

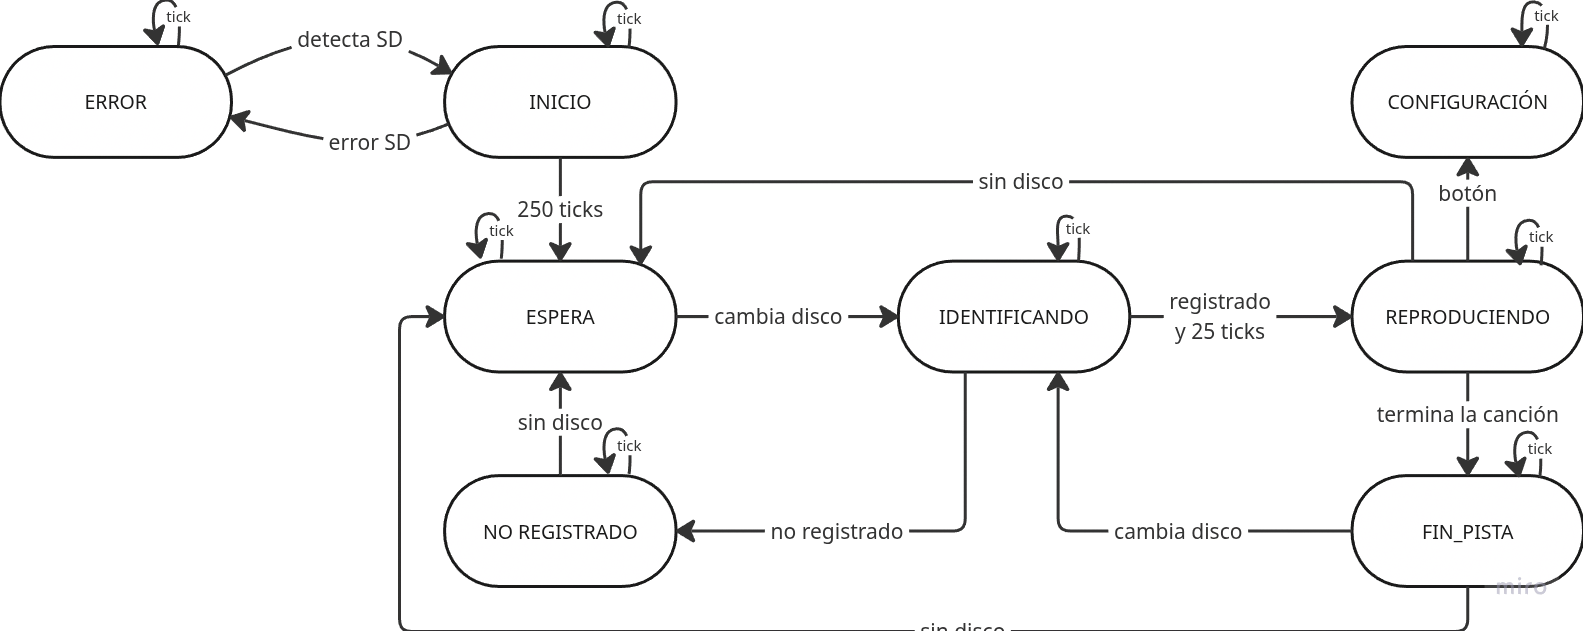
documentation/informe/images/diagrama_mef.png
