Fernandaxx/TallerDeProyectoI/documentation/informe/images/DiagramaBloques2.png

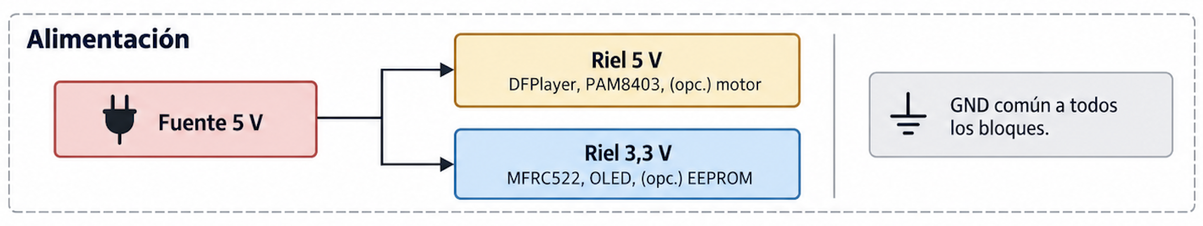
documentation/informe/images/DiagramaBloques2.png
