Fernandaxx/TallerDeProyectoI/documentation/informe/images/DiagramaBloques.png

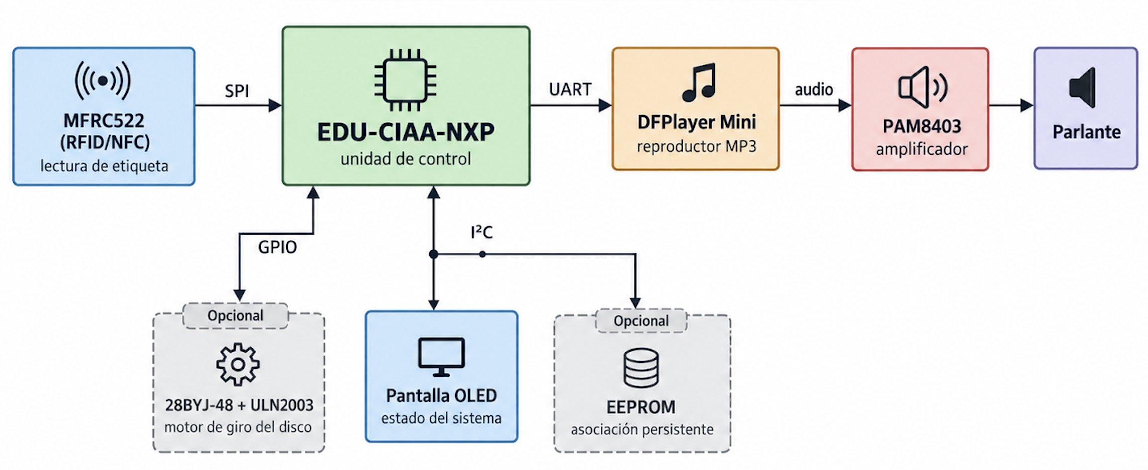
documentation/informe/images/DiagramaBloques.png
