Fernandaxx/TallerDeProyectoI/documentation/informe/images/EsquemaAlimentacion.png

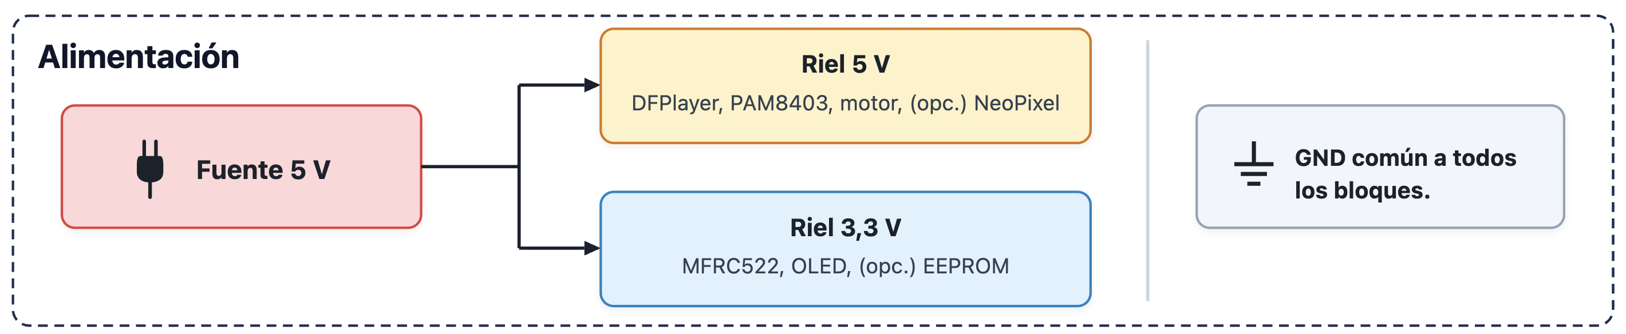
documentation/informe/images/EsquemaAlimentacion.png
