Fernandaxx/TallerDeProyectoI/documentation/informe/images/esquematico.png

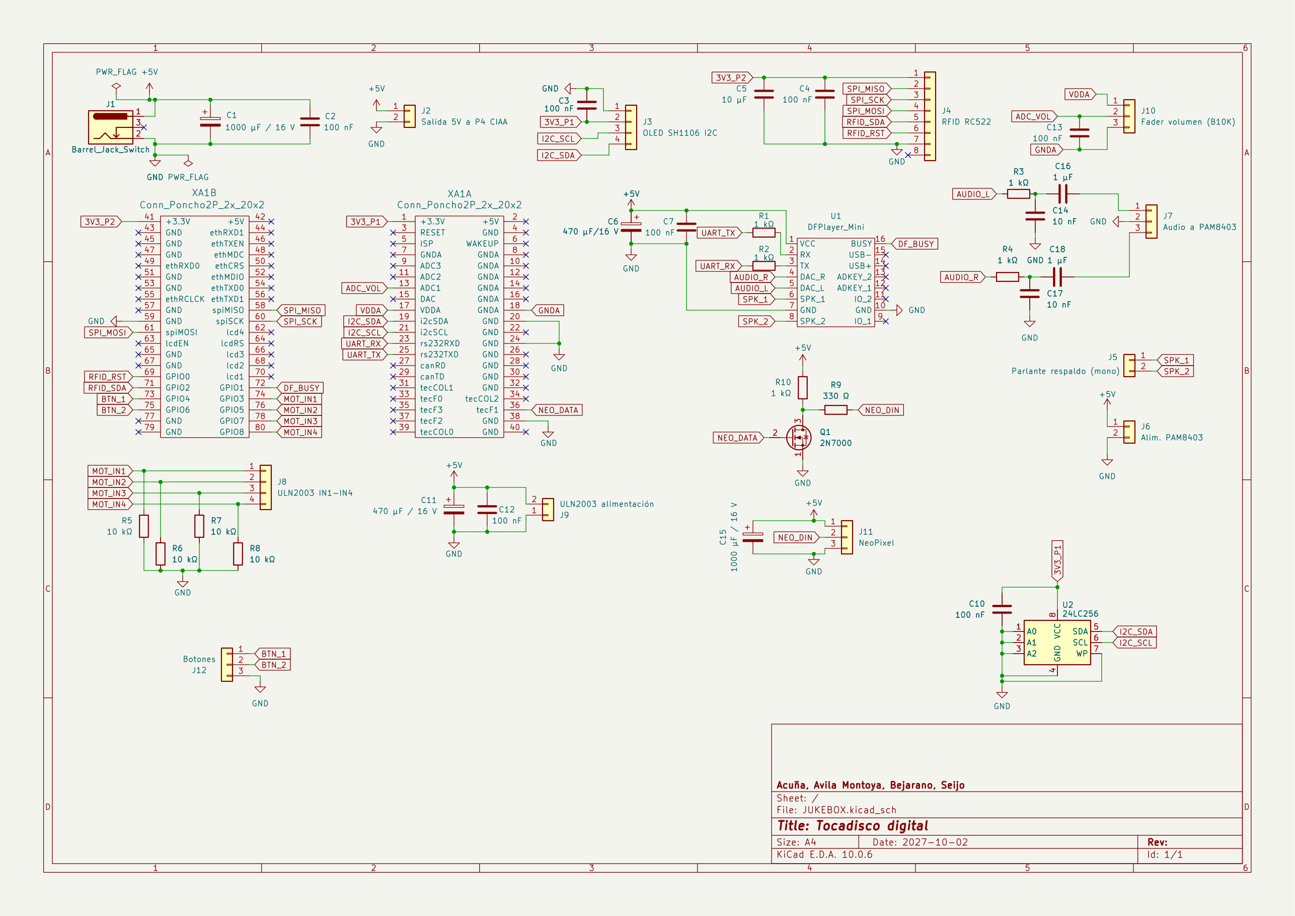
documentation/informe/images/esquematico.png
