Fernandaxx/TallerDeProyectoI/documentation/informe/images/pcb_top.png

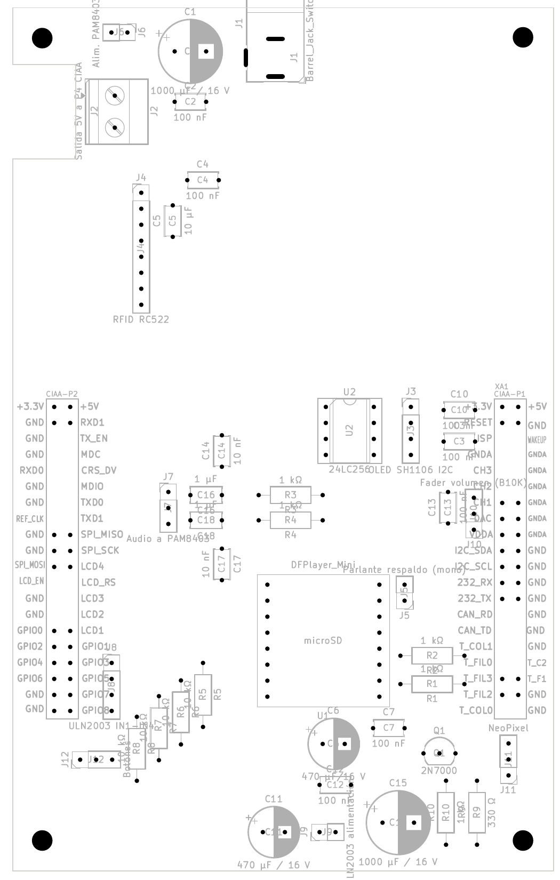
documentation/informe/images/pcb_top.png
