Fernandaxx/TallerDeProyectoI/documentation/informe/images/sch_alimentacion.png

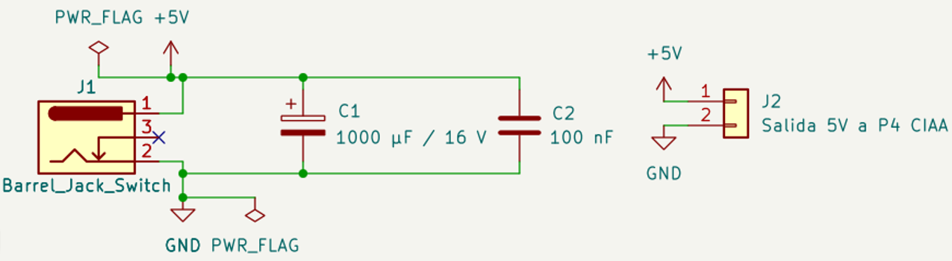
documentation/informe/images/sch_alimentacion.png
