Fernandaxx/TallerDeProyectoI/documentation/informe/images/sch_botones.png

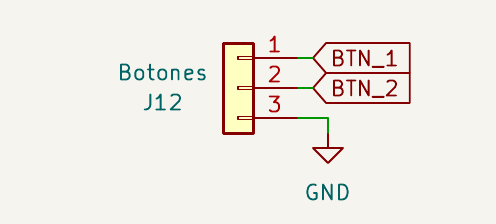
documentation/informe/images/sch_botones.png
