Fernandaxx/TallerDeProyectoI/documentation/informe/images/sch_dfplayer.png

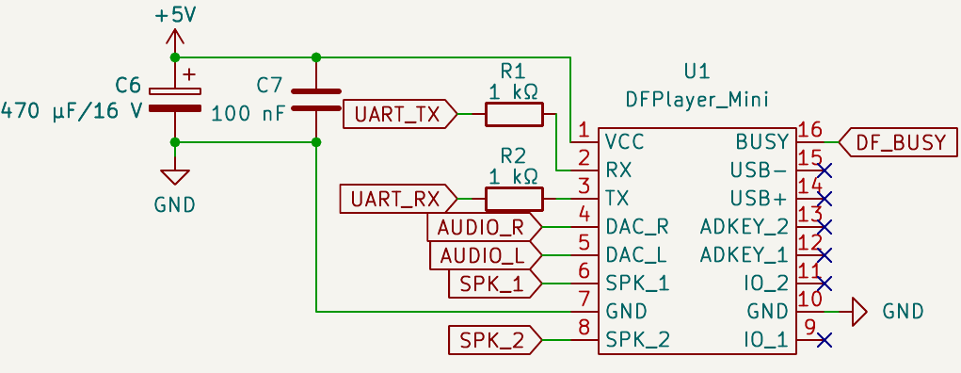
documentation/informe/images/sch_dfplayer.png
