Fernandaxx/TallerDeProyectoI/documentation/informe/images/sch_eeprom.png

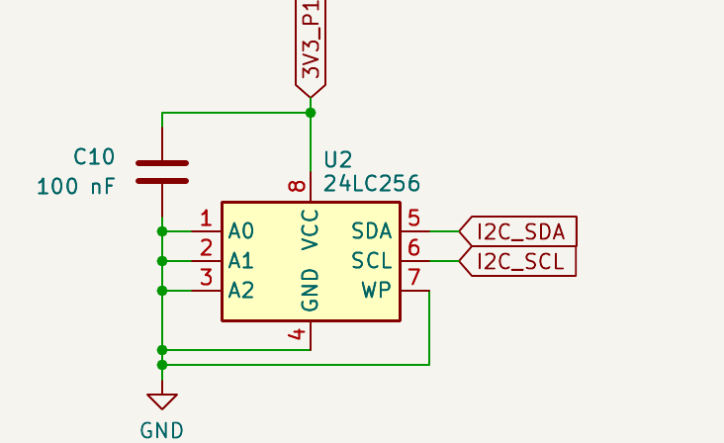
documentation/informe/images/sch_eeprom.png
