Fernandaxx/TallerDeProyectoI/documentation/informe/images/sch_fader.png

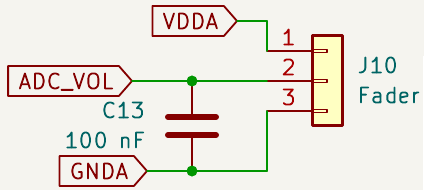
documentation/informe/images/sch_fader.png
