Fernandaxx/TallerDeProyectoI/documentation/informe/images/sch_motor.png

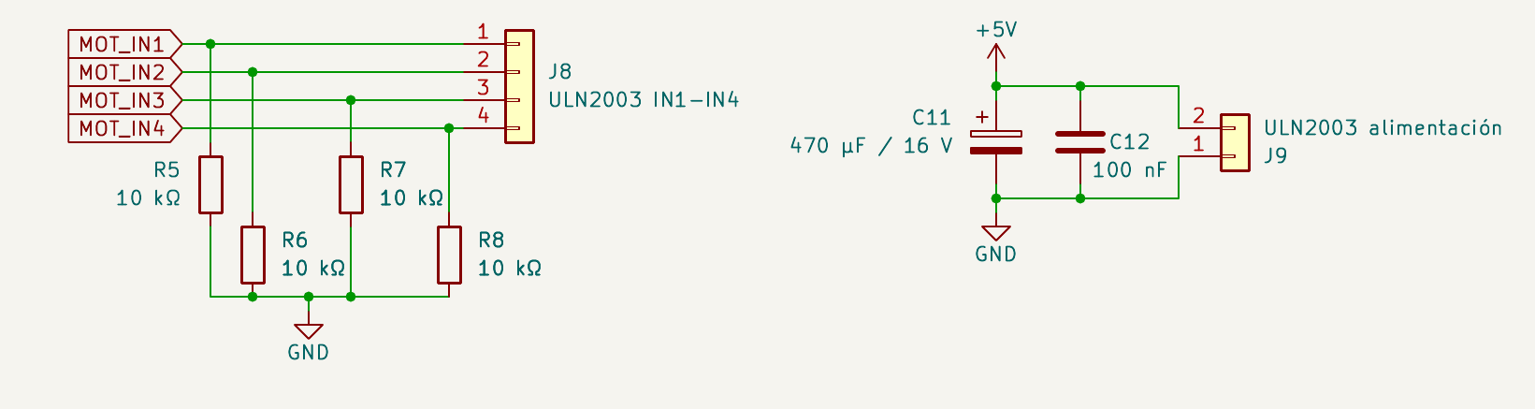
documentation/informe/images/sch_motor.png
