Fernandaxx/TallerDeProyectoI/documentation/informe/images/sch_neopixel.png

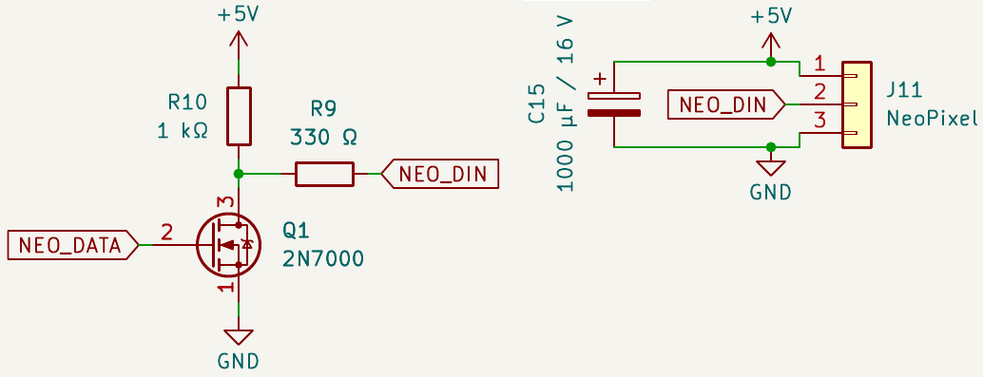
documentation/informe/images/sch_neopixel.png
