Fernandaxx/TallerDeProyectoI/documentation/informe/images/sch_oled.png

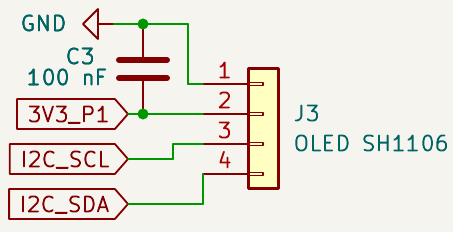
documentation/informe/images/sch_oled.png
