Fernandaxx/TallerDeProyectoI/ejemplos/lpc_open/timer_250ms_pulse/250msSignal.png

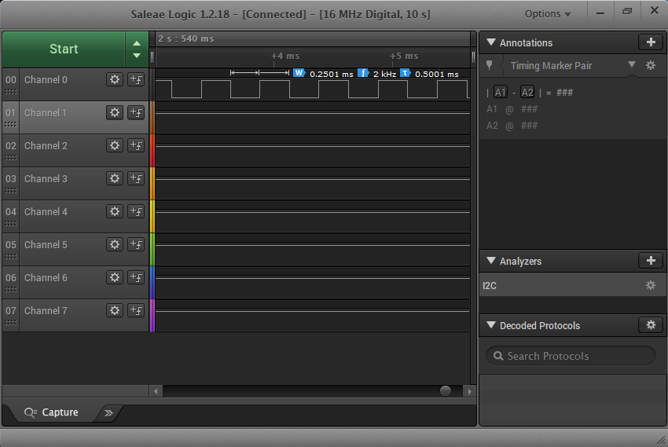
ejemplos/lpc_open/timer_250ms_pulse/250msSignal.png
