Fernandaxx/TallerDeProyectoI/ejemplos/sapi/adc_dac/adc_analog_stick_connection.png

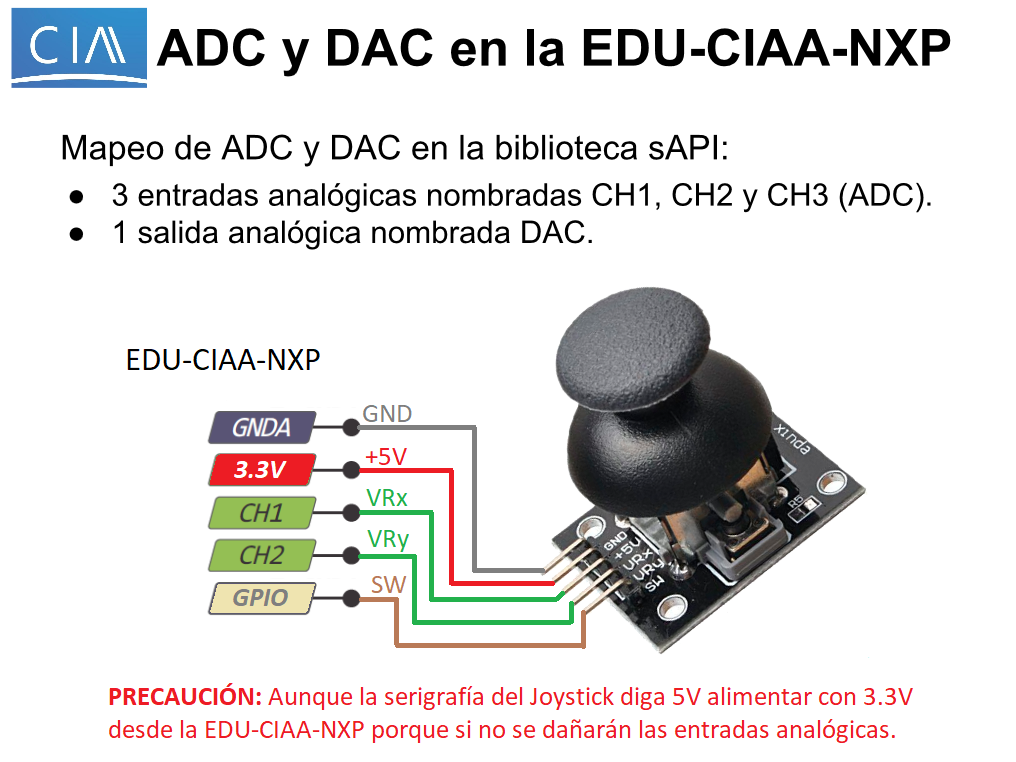
ejemplos/sapi/adc_dac/adc_analog_stick_connection.png
