Fernandaxx/TallerDeProyectoI/ejemplos/sapi/adc_dac/adc_dac_pins.png

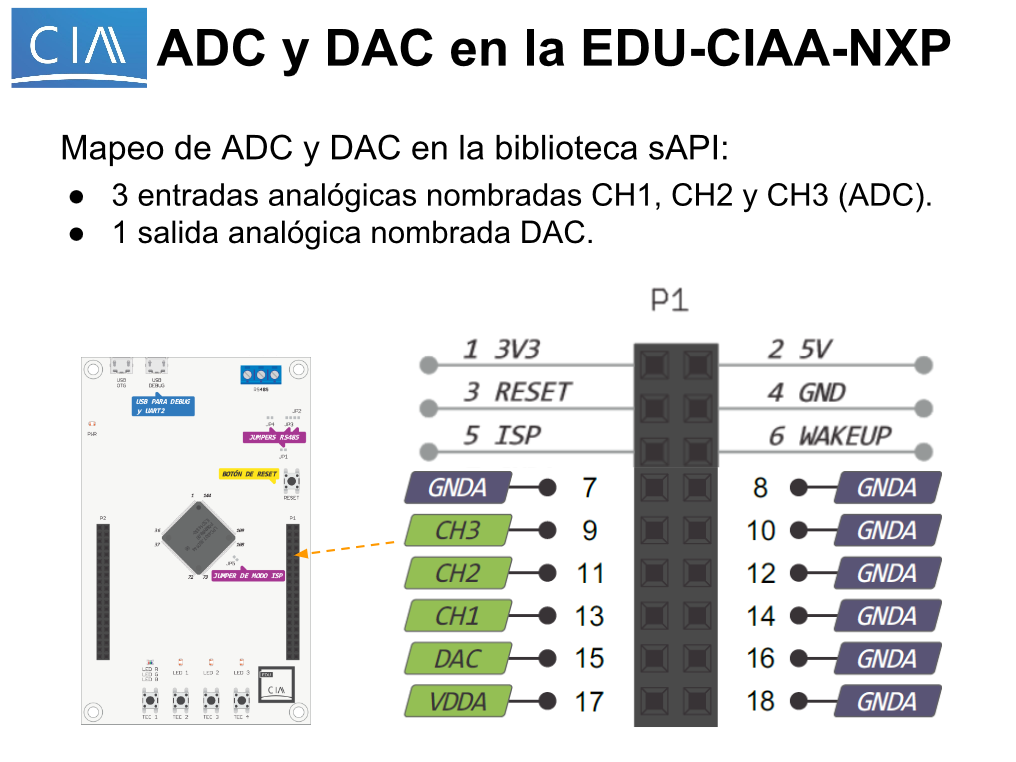
ejemplos/sapi/adc_dac/adc_dac_pins.png
