Fernandaxx/TallerDeProyectoI/ejemplos/sapi/bluetooth/hc05_uart_bridge/bluetooth_hc05_connection.png

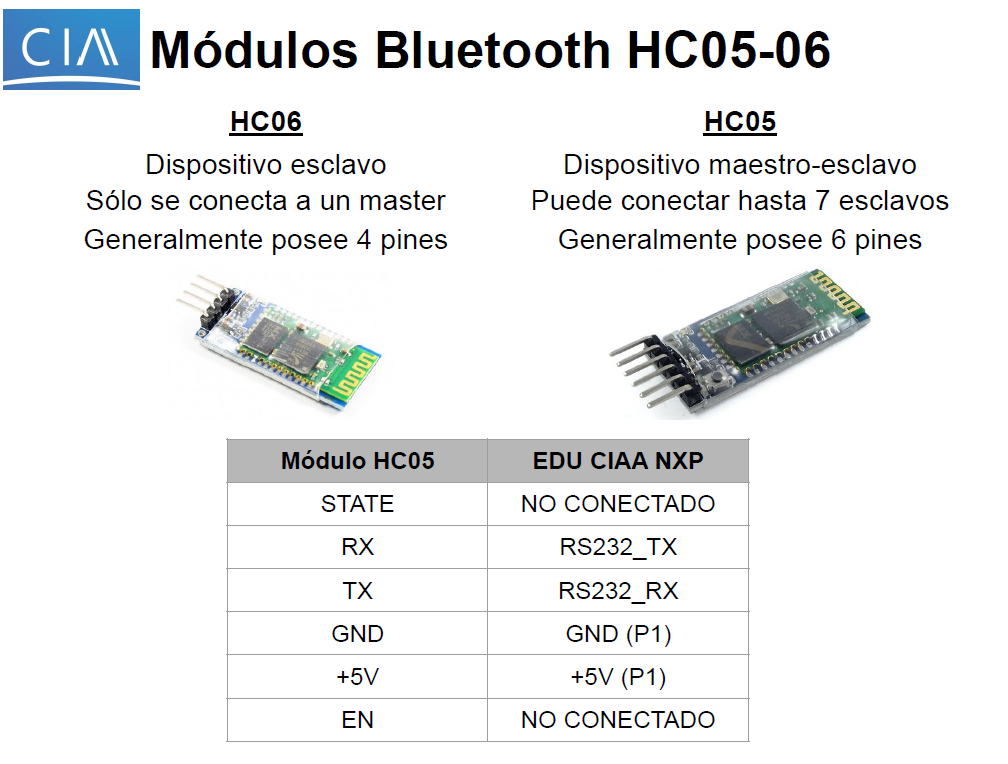
ejemplos/sapi/bluetooth/hc05_uart_bridge/bluetooth_hc05_connection.png
