Fernandaxx/TallerDeProyectoI/ejemplos/sapi/bluetooth/hm10_uart_bridge/bluetooth_ble_hm10_connection.png

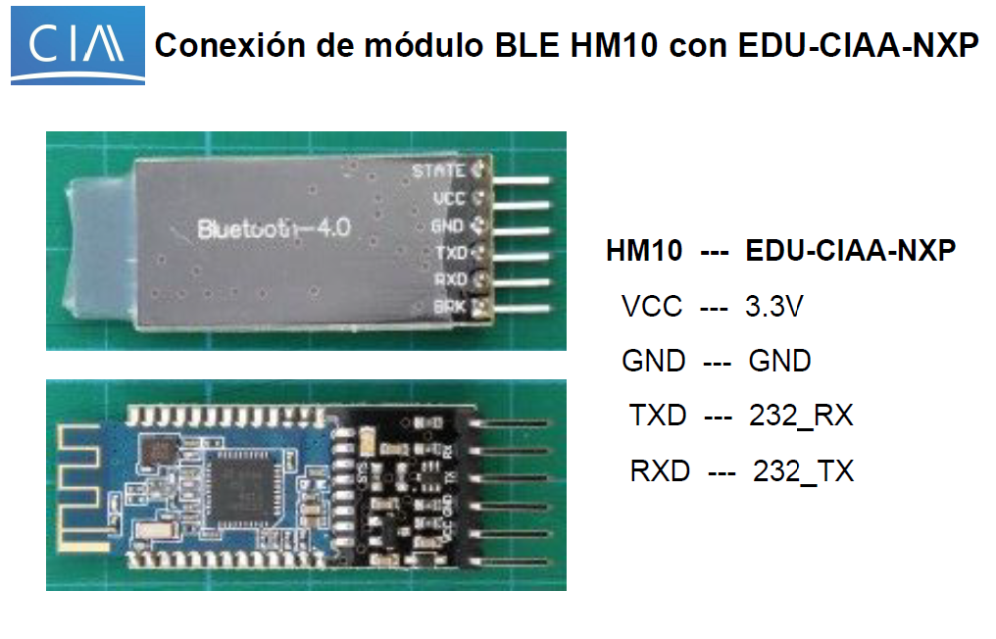
ejemplos/sapi/bluetooth/hm10_uart_bridge/bluetooth_ble_hm10_connection.png
