Fernandaxx/TallerDeProyectoI/ejemplos/sapi/dht11_temp_humidity/DHT11 and EDU-CIAA-NXP.png

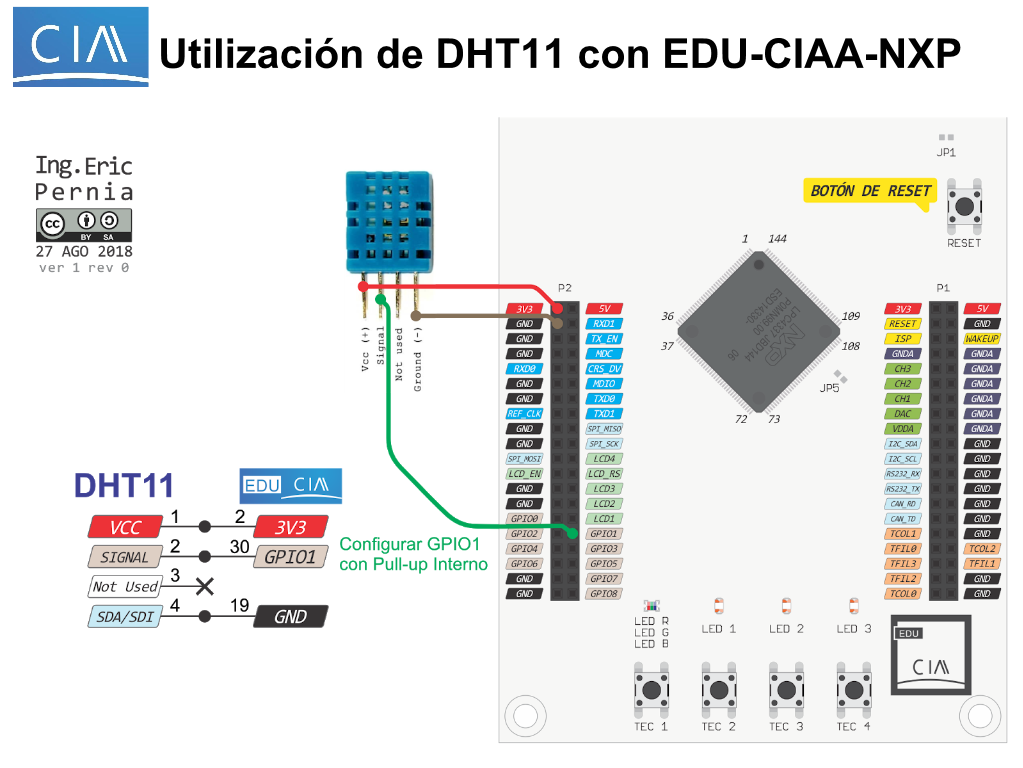
ejemplos/sapi/dht11_temp_humidity/DHT11 and EDU-CIAA-NXP.png
