Fernandaxx/TallerDeProyectoI/ejemplos/sapi/dht11_temp_humidity/DHT11 Module and EDU-CIAA-NXP.png

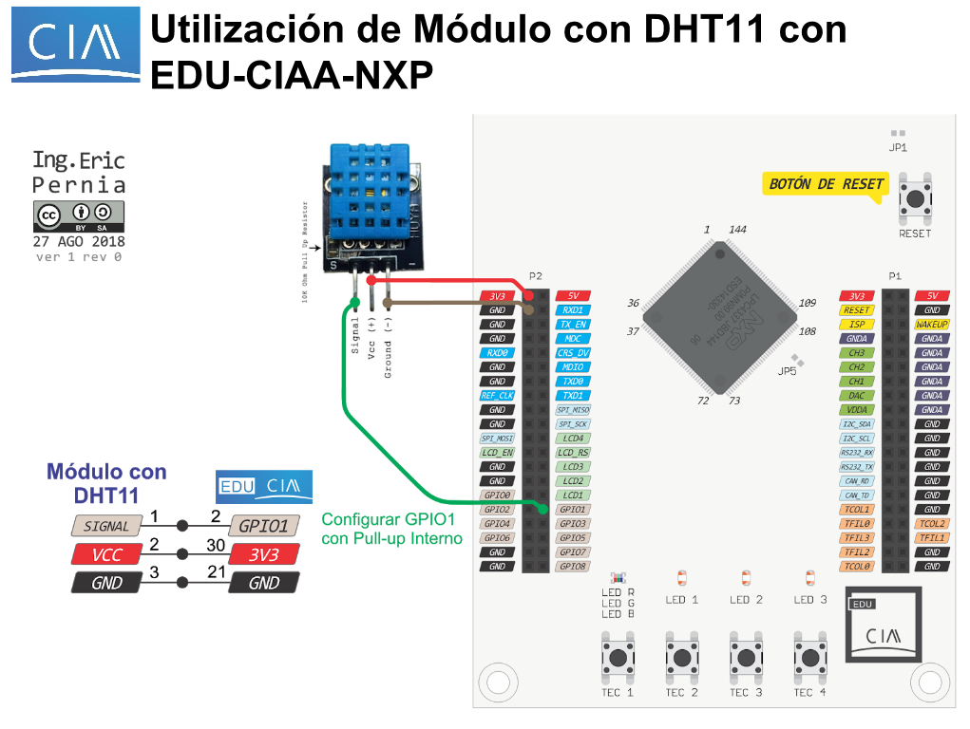
ejemplos/sapi/dht11_temp_humidity/DHT11 Module and EDU-CIAA-NXP.png
