Fernandaxx/TallerDeProyectoI/ejemplos/sapi/fatfs_sdcard_usbmsd/SD SPI.png

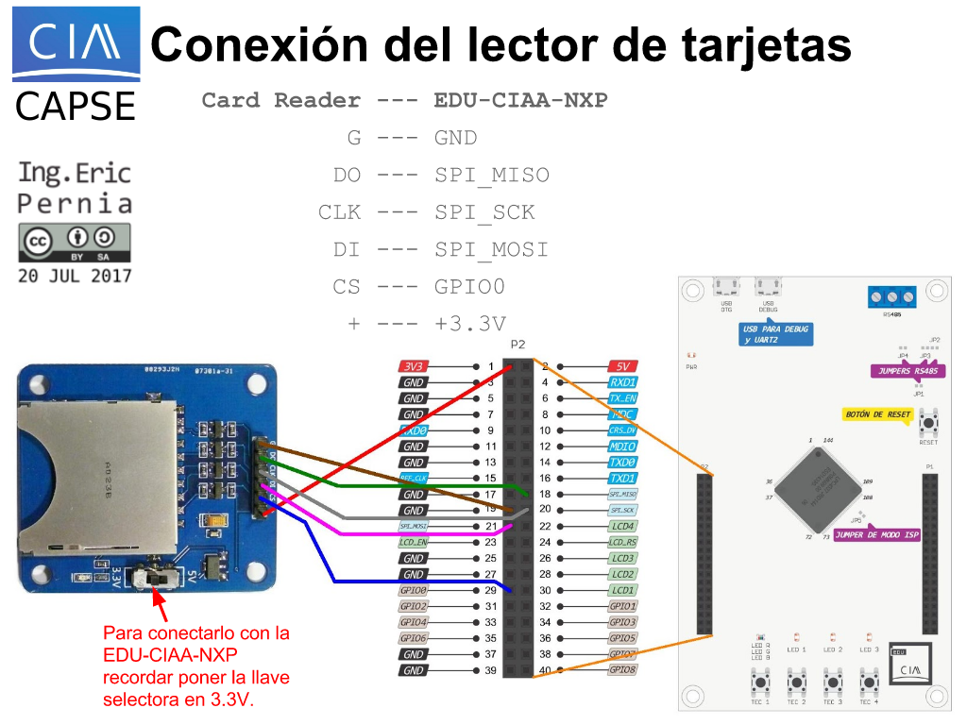
ejemplos/sapi/fatfs_sdcard_usbmsd/SD SPI.png
