Fernandaxx/TallerDeProyectoI/ejemplos/sapi/gpio/axis_interface/AXI Stream.png

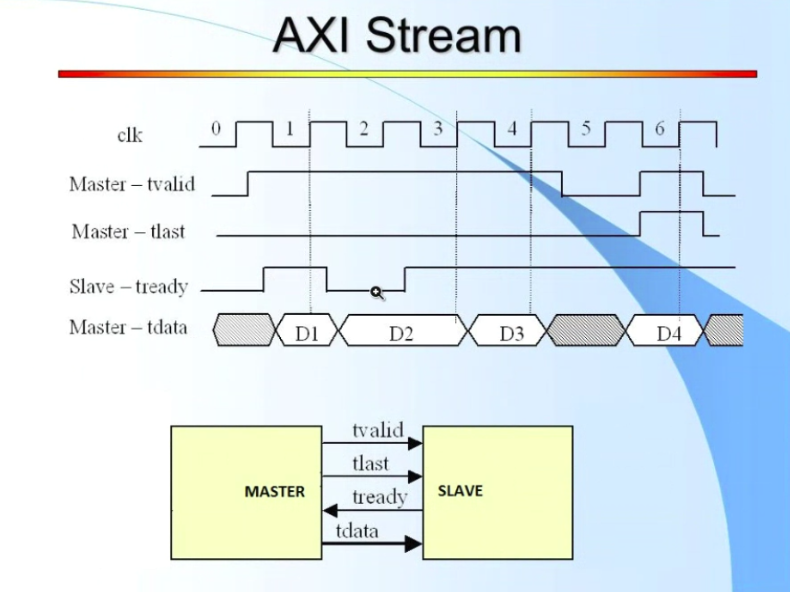
ejemplos/sapi/gpio/axis_interface/AXI Stream.png
