Fernandaxx/TallerDeProyectoI/ejemplos/sapi/gpio/axis_interface/axis_loop_edu_ciaa.png

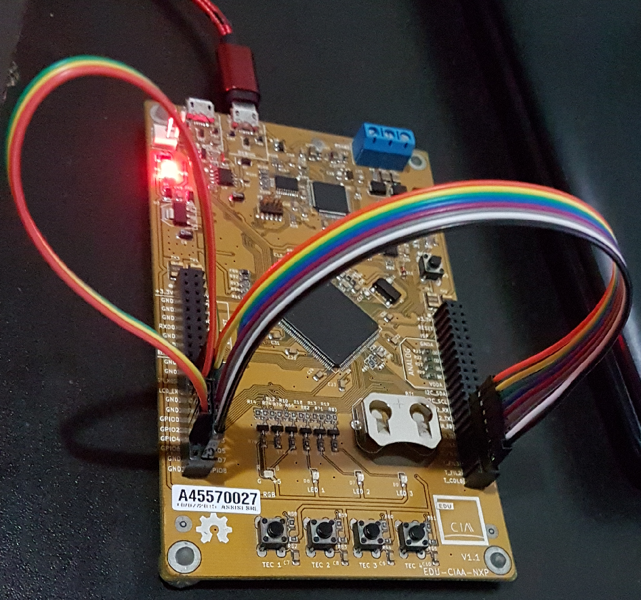
ejemplos/sapi/gpio/axis_interface/axis_loop_edu_ciaa.png
