Fernandaxx/TallerDeProyectoI/ejemplos/sapi/gpio/axis_interface/axis_pins_edu_ciaa.png

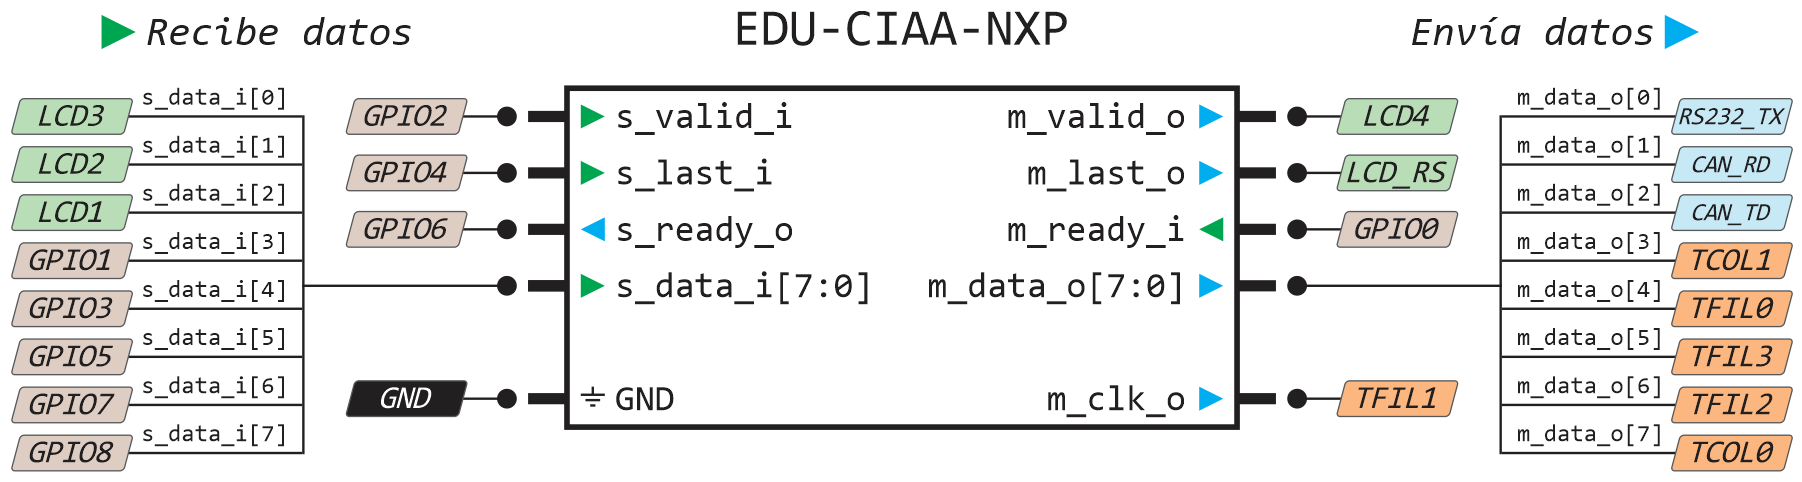
ejemplos/sapi/gpio/axis_interface/axis_pins_edu_ciaa.png
