Fernandaxx/TallerDeProyectoI/ejemplos/sapi/hcsr04_ultrasonic_sensor/Conexión EDU-CIAA - HC-SR04.png

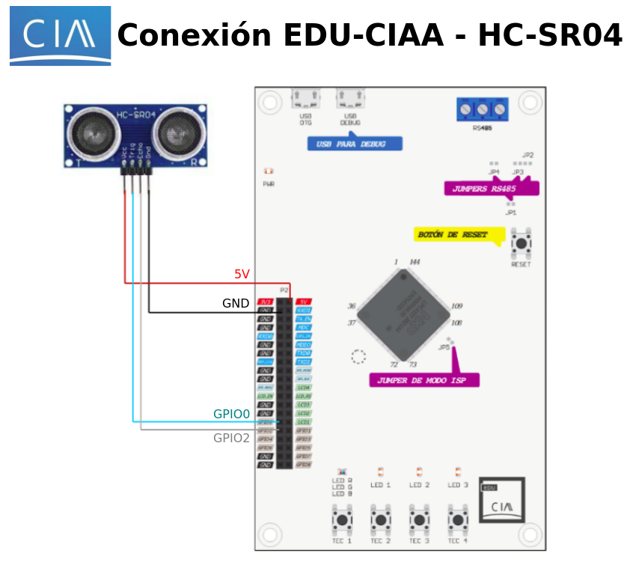
ejemplos/sapi/hcsr04_ultrasonic_sensor/Conexión EDU-CIAA - HC-SR04.png
