Fernandaxx/TallerDeProyectoI/ejemplos/sapi/i2c/IMUs/mpu9250/MPU9250 and EDU-CIAA-NXP.png

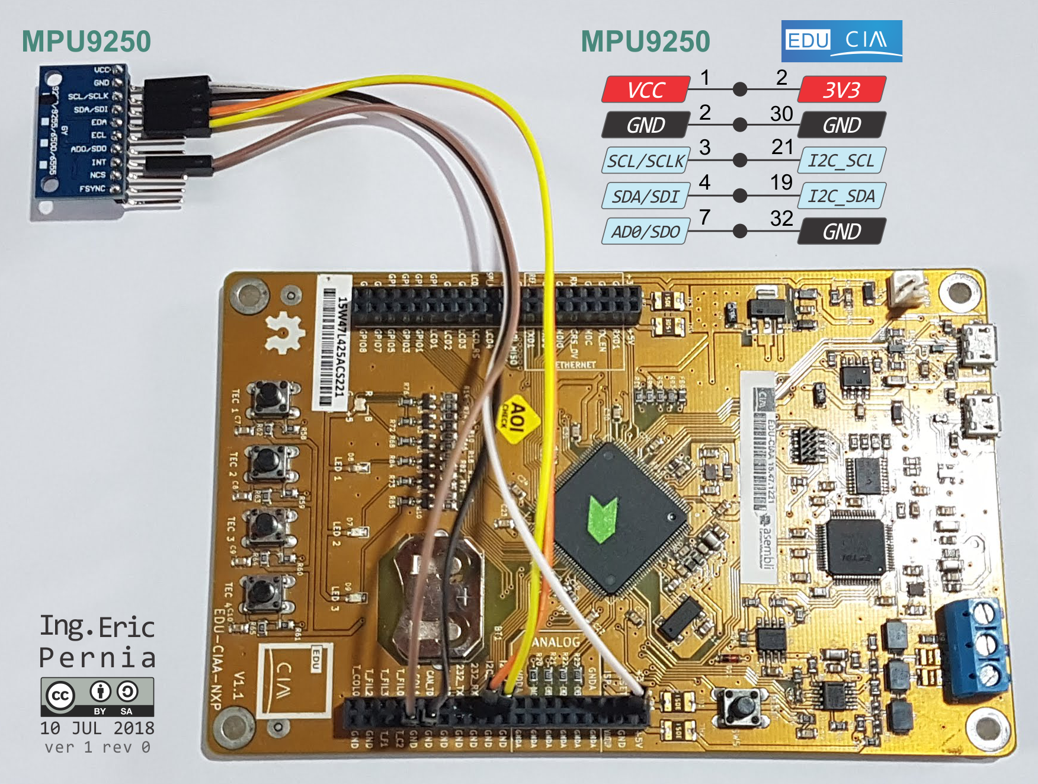
ejemplos/sapi/i2c/IMUs/mpu9250/MPU9250 and EDU-CIAA-NXP.png
