Fernandaxx/TallerDeProyectoI/ejemplos/sapi/i2c/IMUs/mpu9250/Serial Terminal - MPU9250 working.PNG

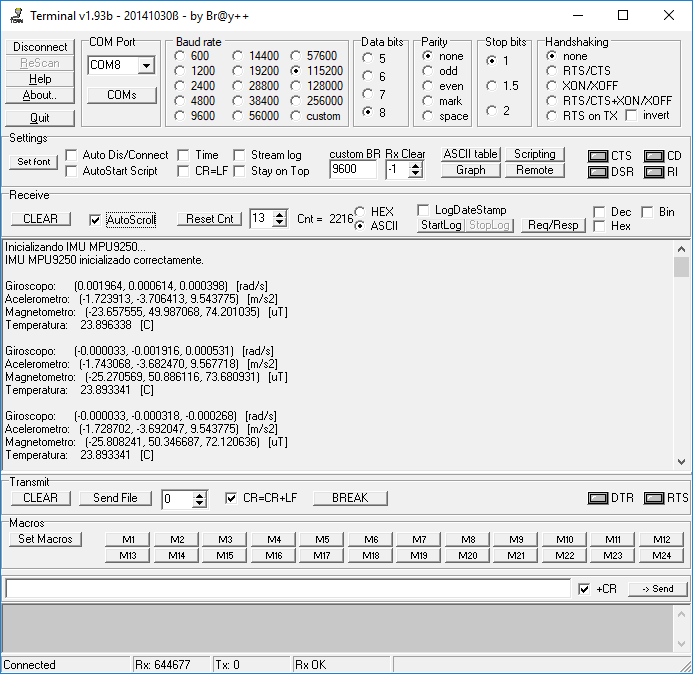
ejemplos/sapi/i2c/IMUs/mpu9250/Serial Terminal - MPU9250 working.PNG
