Fernandaxx/TallerDeProyectoI/ejemplos/sapi/i2c/magnetometers/hmc5883l/HMC5883L_EDU-CIAA.png

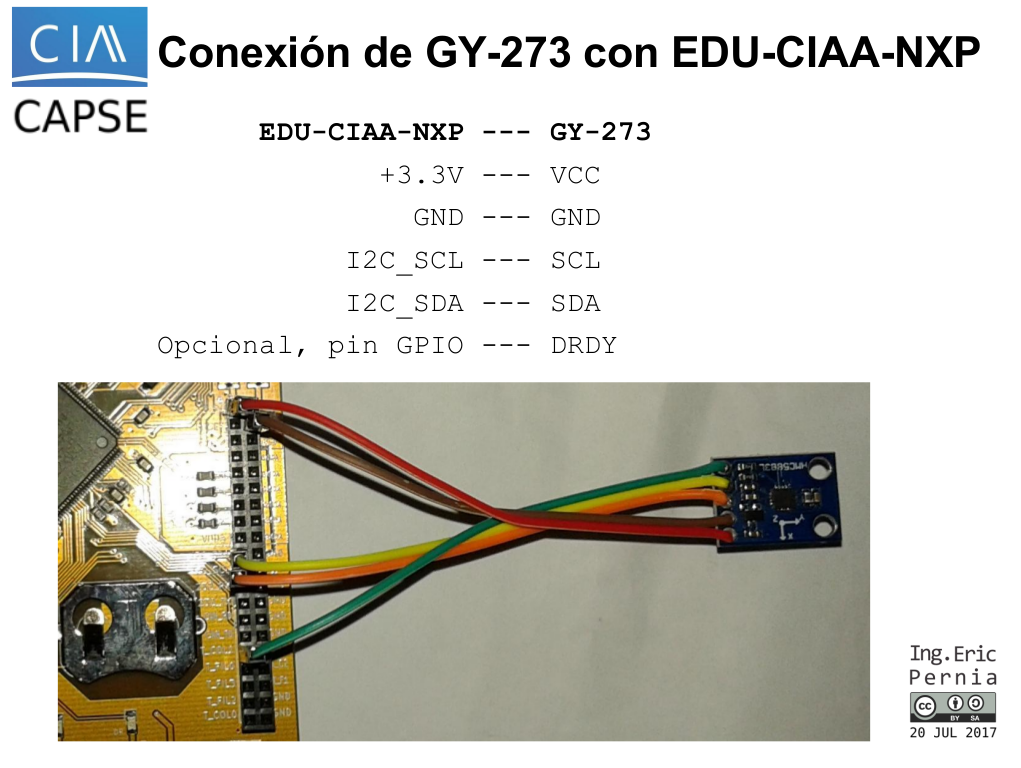
ejemplos/sapi/i2c/magnetometers/hmc5883l/HMC5883L_EDU-CIAA.png
