Fernandaxx/TallerDeProyectoI/ejemplos/sapi/keypad_7segment/7 segment display - EDU-CIAA-NXP.png

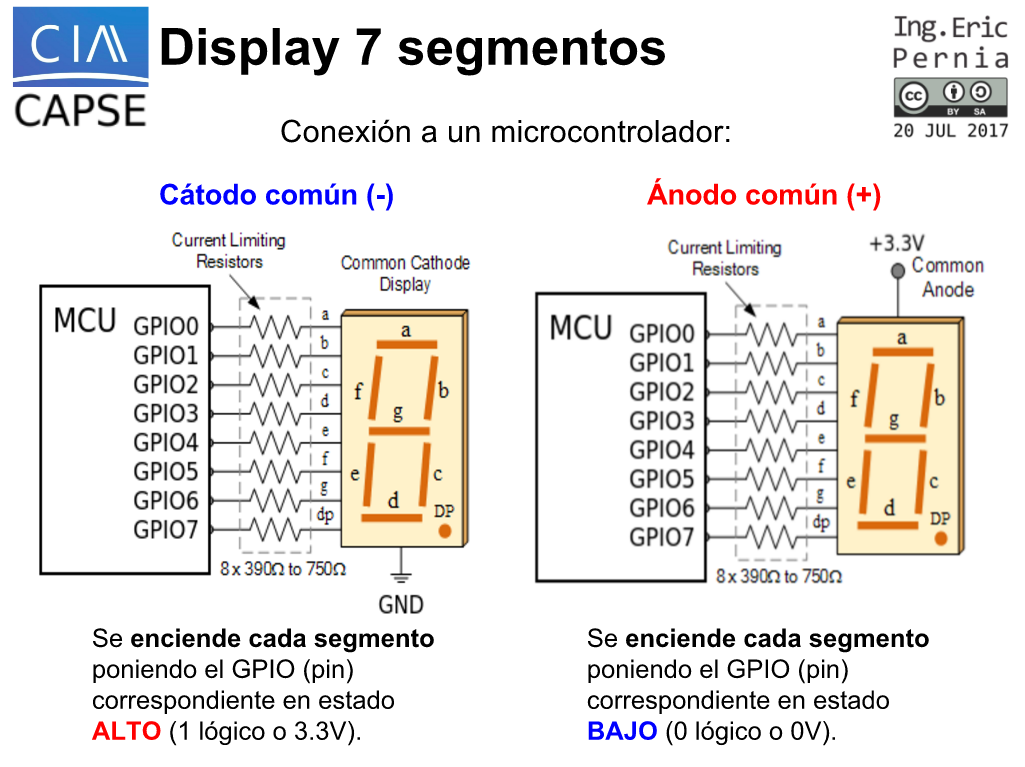
ejemplos/sapi/keypad_7segment/7 segment display - EDU-CIAA-NXP.png
