Fernandaxx/TallerDeProyectoI/ejemplos/sapi/keypad_7segment/Keypad - EDU-CIAA-NXP.png

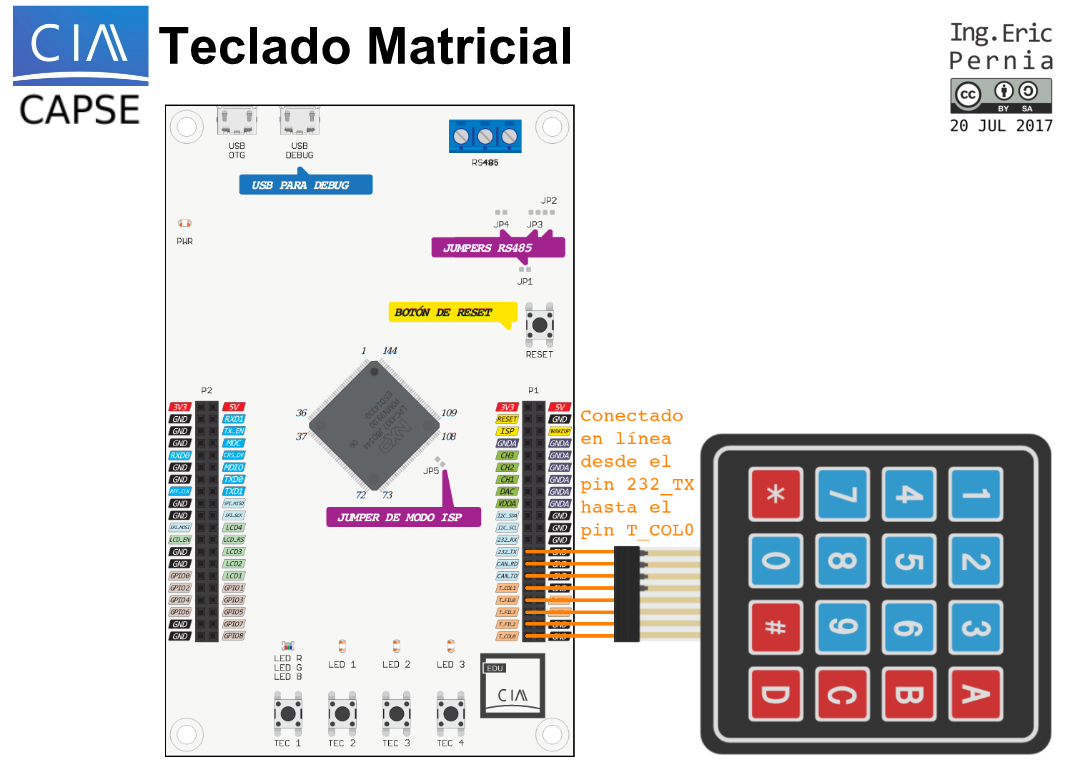
ejemplos/sapi/keypad_7segment/Keypad - EDU-CIAA-NXP.png
