Fernandaxx/TallerDeProyectoI/ejemplos/sapi/lcd/LCD connection.png

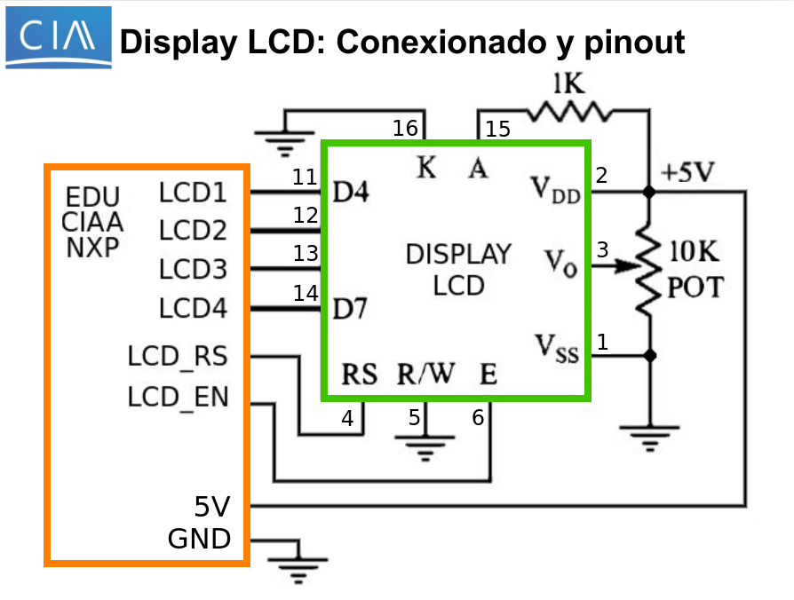
ejemplos/sapi/lcd/LCD connection.png
