Fernandaxx/TallerDeProyectoI/ejemplos/sapi/lcd/lcd_i2c/I2C expander PCF8574/Encapsulado en placa.png

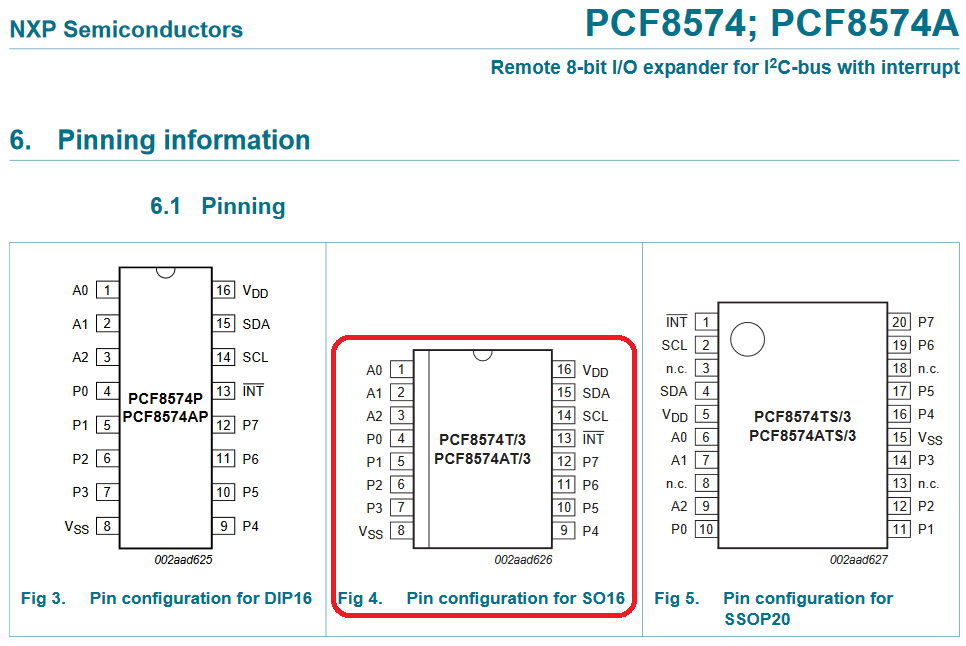
ejemplos/sapi/lcd/lcd_i2c/I2C expander PCF8574/Encapsulado en placa.png
