Fernandaxx/TallerDeProyectoI/ejemplos/sapi/lcd/lcd_i2c/I2C expander PCF8574/modulo-adaptador-lcd-a-i2c_PCF8574.jpg

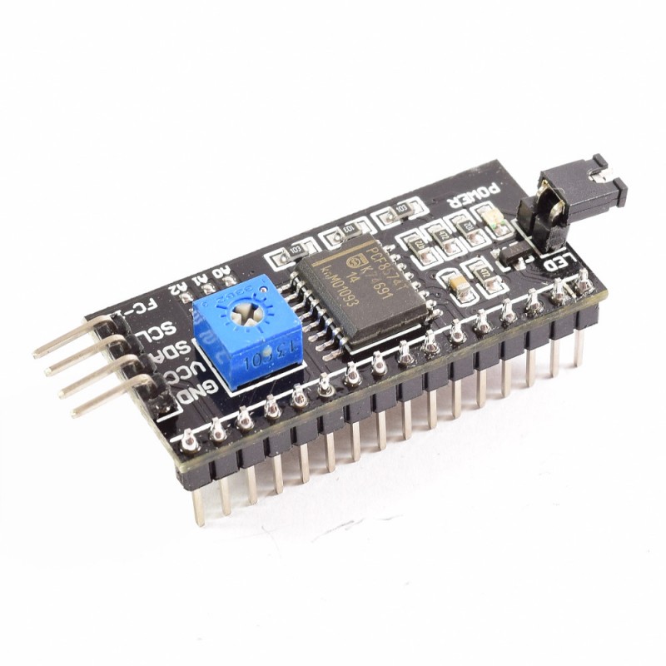
ejemplos/sapi/lcd/lcd_i2c/I2C expander PCF8574/modulo-adaptador-lcd-a-i2c_PCF8574.jpg
