Fernandaxx/TallerDeProyectoI/ejemplos/sapi/servo/servo_connection.png

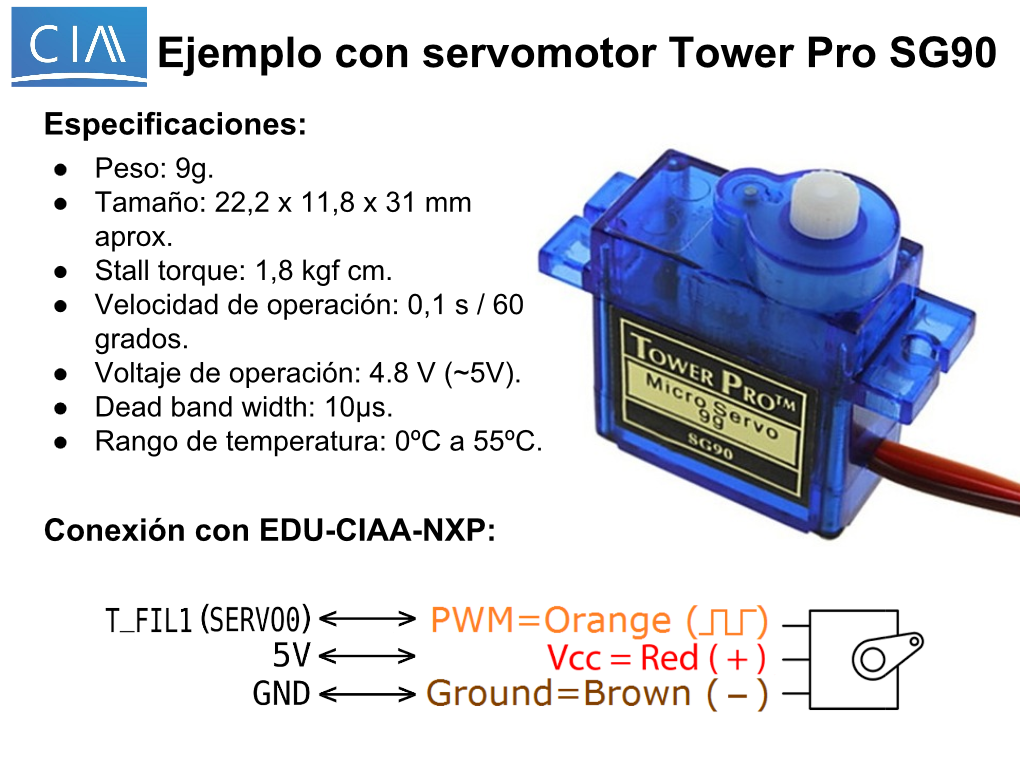
ejemplos/sapi/servo/servo_connection.png
