Fernandaxx/TallerDeProyectoI/ejemplos/sapi/servo/servo_pins.png

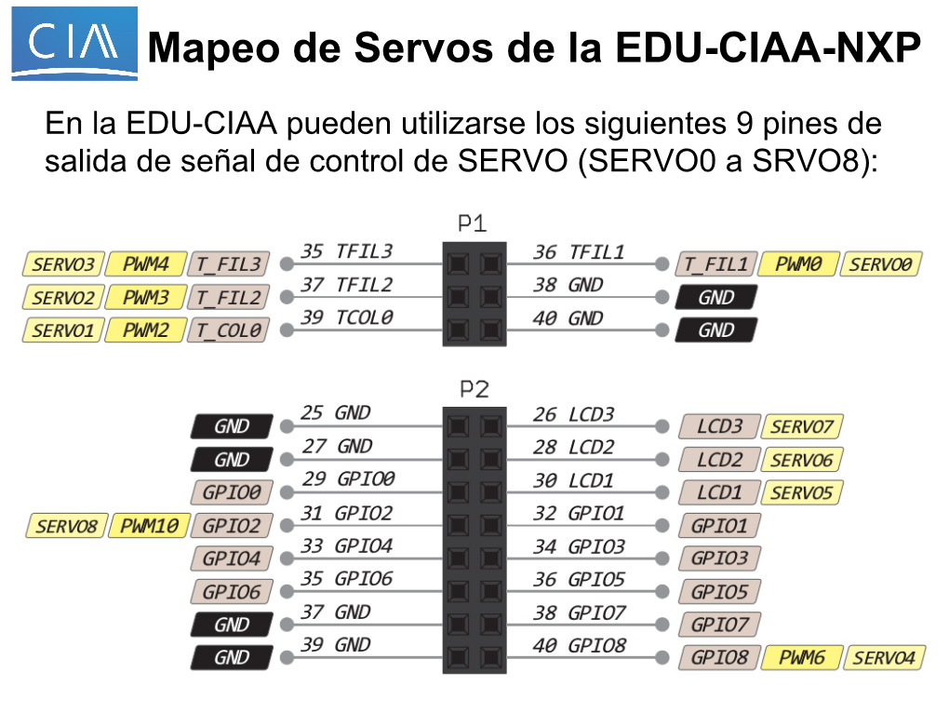
ejemplos/sapi/servo/servo_pins.png
