Fernandaxx/TallerDeProyectoI/ejemplos/sapi/wifi/esp8266/Conexion ESP8266 y EDU-CIAA.png

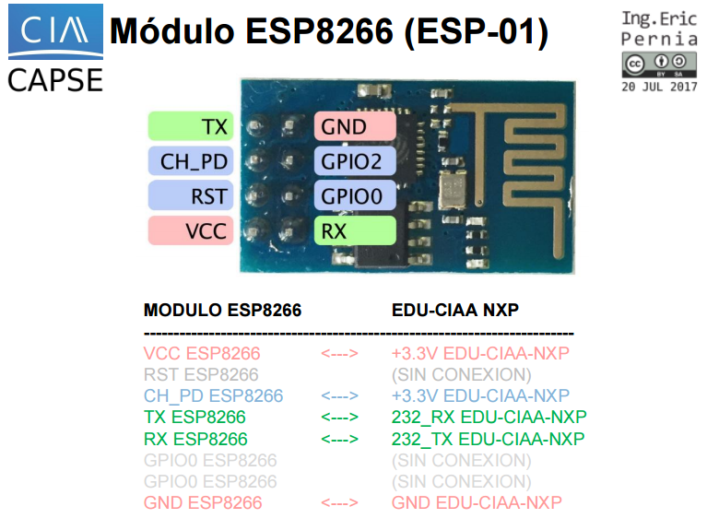
ejemplos/sapi/wifi/esp8266/Conexion ESP8266 y EDU-CIAA.png
