Fernandaxx/TallerDeProyectoI/ejemplos/sapi/wifi/esp8266/iot_thingspeak/Datos en Thingspeak.png

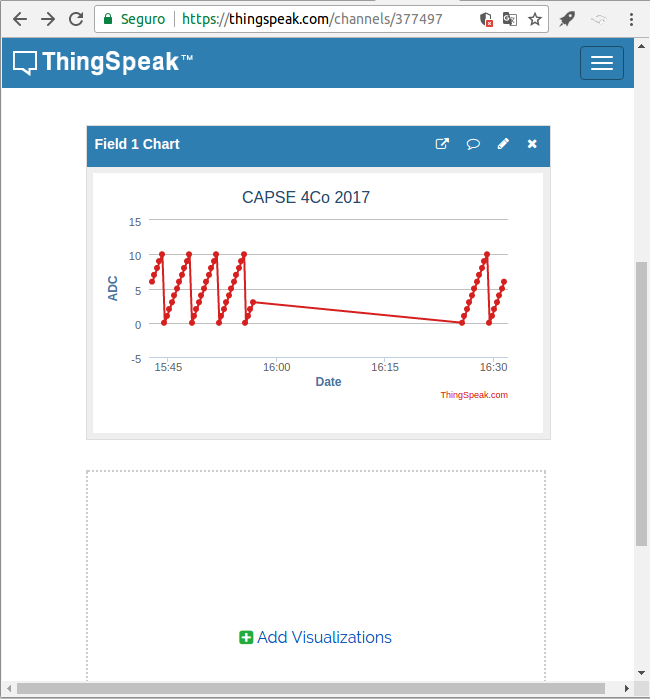
ejemplos/sapi/wifi/esp8266/iot_thingspeak/Datos en Thingspeak.png
