Fernandaxx/TallerDeProyectoI/documentation/firmware/usage/program_strcuture.png

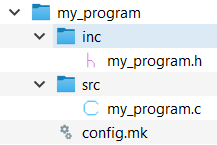
documentation/firmware/usage/program_strcuture.png
