Fernandaxx/TallerDeProyectoI/documentation/firmware/usage/user_preferences.png

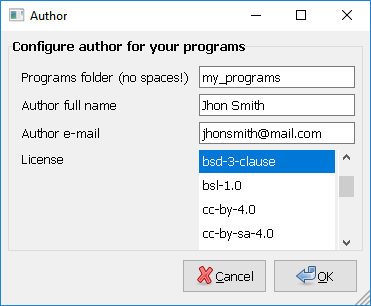
documentation/firmware/usage/user_preferences.png
