Fernandaxx/TallerDeProyectoI/Kicad/JUKEBOX/Tocadisco_esquematico.pdf

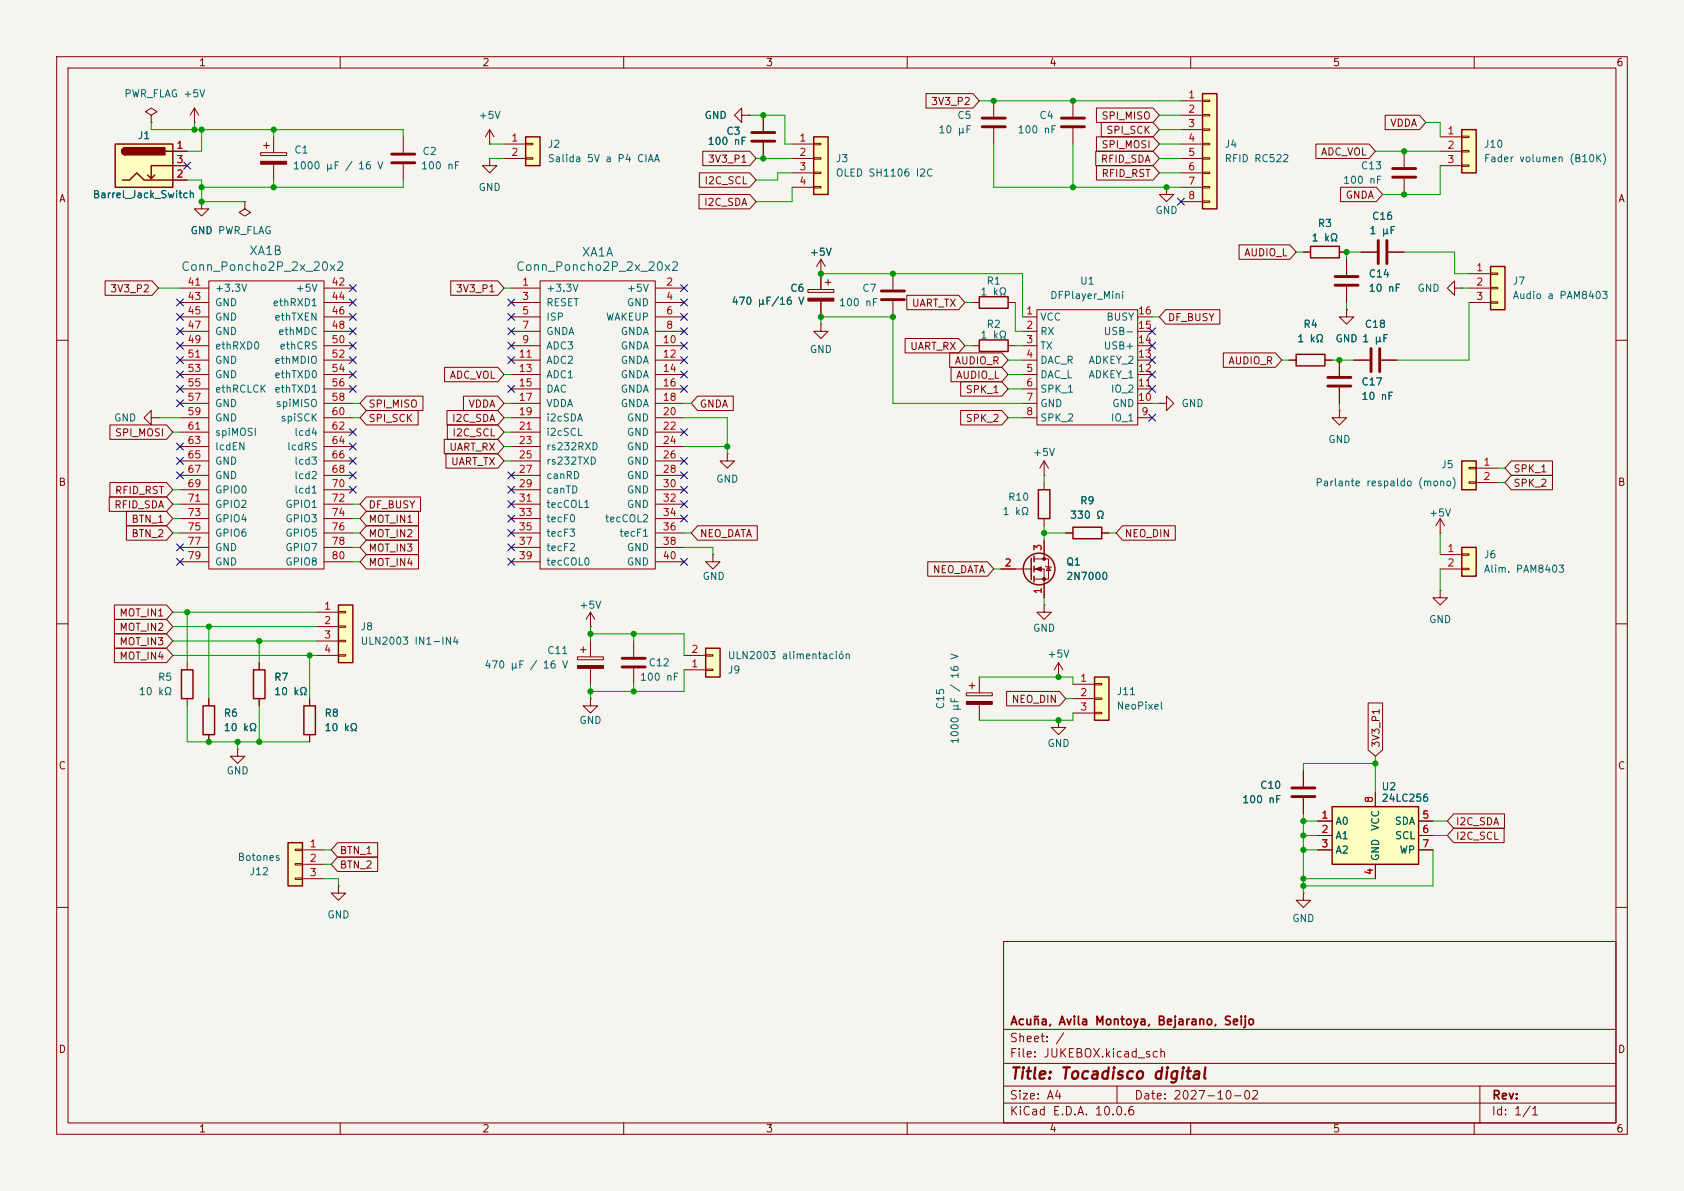
[picture p215: page 1]

Acuña, Avila Montoya, Bejarano, Seijo
Sheet: /
File: JUKEBOX.kicad_sch
Title: Tocadisco digital

Size: A4 | Rev:
KiCad E.D.A. 10.0.6 | Id: 1/1
