Fernandaxx/TallerDeProyectoI/Kicad/JUKEBOX/JUKEBOX.kicad_pcb

## KiCad design Kicad/JUKEBOX/JUKEBOX.kicad_pcb (2026-11-04)

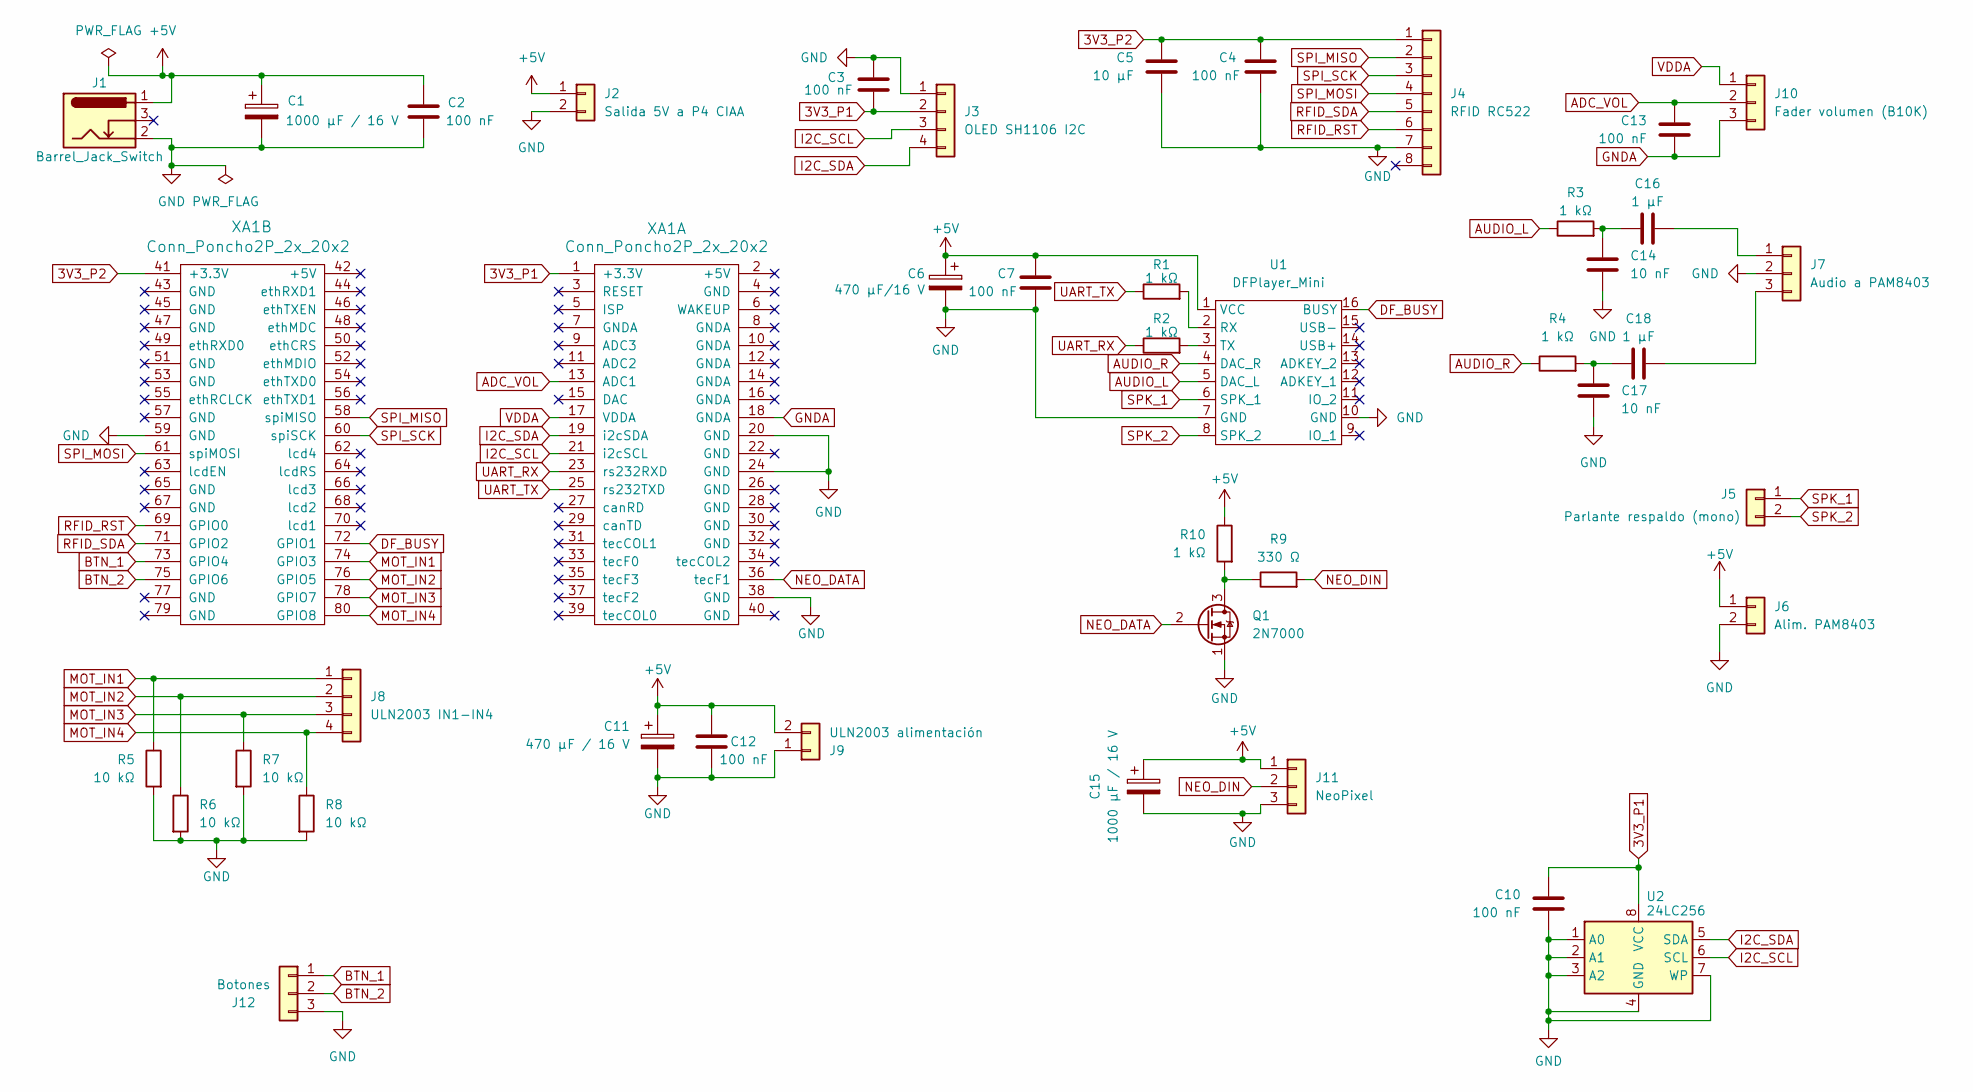
[picture p242: schematic JUKEBOX.kicad_sch, Tocadisco digital]

Parts:
C1, C15: 1000 µF / 16 V; CP_D10_P5.00
C2, C3, C4, C7, C10, C12, C13: 100 nF; C_Disc_D4.7_P5.00
C5: 10 µF; C_Disc_D4.7_P5.00
C6: 470 µF/16 V; CP_D8_P3.50
C11: 470 µF / 16 V; CP_D8_P3.50
C14, C17: 10 nF; C_Disc_D4.7_P5.00
C16, C18: 1 µF; C_Disc_D5_P5.00
J1: Barrel_Jack_Switch; BarrelJack_H
J2: Salida 5V a P4 CIAA; TB_P5.08_1x02
J3: OLED SH1106 I2C; PinHeader_1x04
J4: RFID RC522; PinHeader_1x08
J5: Parlante respaldo (mono); PinHeader_1x02
J6: Alim. PAM8403; PinHeader_1x02
J7: Audio a PAM8403; PinHeader_1x03
J8: ULN2003 IN1-IN4; PinHeader_1x04
J9: ULN2003 alimentación; PinHeader_1x02_Robusto
J10: Fader volumen (B10K); PinHeader_1x03
J11: NeoPixel; PinHeader_1x03
J12: Botones; PinHeader_1x03
Q1: 2N7000; TO-92_Wide
R1, R2, R3, R4, R10: 1 kΩ; R_Axial_P10.16
R5, R6, R7, R8: 10 kΩ; R_Axial_P10.16
R9: 330 Ω; R_Axial_P10.16
U1: DFPlayer_Mini
U2: 24LC256; DIP-8_Socket
XA1: Conn_Poncho2P_2x_20x2; Poncho_Grande_Reducido

Connections:
3V3_P1: C3.1, C10.1, J3.2, U2.8 (VCC), XA1.1 (+3.3V)
3V3_P2: C4.2, C5.2, J4.1, XA1.41 (+3.3V)
+5V: C1.1, C2.1, C6.1, C7.1, C11.1, C12.1, C15.1, J1.1, J2.1, J6.1, J9.2, J11.1, R10.1, U1.1 (VCC)
ADC_VOL: C13.1, J10.2, XA1.13 (ADC1)
AUDIO_L: R3.1, U1.5 (DAC_L)
AUDIO_R: R4.1, U1.4 (DAC_R)
BTN_1: J12.1, XA1.73 (GPIO4)
BTN_2: J12.2, XA1.75 (GPIO6)
DF_BUSY: U1.16 (BUSY), XA1.72 (GPIO1)
GND: C1.2, C2.2, C3.2, C4.1, C5.1, C6.2, C7.2, C10.2, C11.2, C12.2, C14.2, C15.2, C17.2, J1.2, J2.2, J3.1, J4.7, J6.2, J7.2, J9.1, J11.3, J12.3, Q1.1 (S), R5.2, R6.2, R7.2, R8.2, U1.7 (GND), U1.10 (GND), U2.1 (A0), U2.2 (A1), U2.3 (A2), U2.4 (GND), U2.7 (WP), XA1.20 (GND), XA1.24 (GND), XA1.38 (GND), XA1.59 (GND)
GNDA: C13.2, J10.3, XA1.18 (GNDA)
I2C_SCL: J3.3, U2.6 (SCL), XA1.21 (i2cSCL)
I2C_SDA: J3.4, U2.5 (SDA), XA1.19 (i2cSDA)
MOT_IN1: J8.1, R5.1, XA1.74 (GPIO3)
MOT_IN2: J8.2, R6.1, XA1.76 (GPIO5)
MOT_IN3: J8.3, R7.1, XA1.78 (GPIO7)
MOT_IN4: J8.4, R8.1, XA1.80 (GPIO8)
NEO_DATA: Q1.2 (G), XA1.36 (tecF1)
NEO_DIN: J11.2, R9.2
unnamed: C14.1, C16.1, R3.2
unnamed: C17.1, C18.1, R4.2
unnamed: C16.2, J7.1
unnamed: C18.2, J7.3
unnamed: Q1.3 (D), R9.1, R10.2
unnamed: R1.2, U1.2 (RX)
unnamed: R2.2, U1.3 (TX)
RFID_RST: J4.6, XA1.69 (GPIO0)
RFID_SDA: J4.5, XA1.71 (GPIO2)
SPI_MISO: J4.2, XA1.58 (spiMISO)
SPI_MOSI: J4.4, XA1.61 (spiMOSI)
SPI_SCK: J4.3, XA1.60 (spiSCK)
SPK_1: J5.1, U1.6 (SPK_1)
SPK_2: J5.2, U1.8 (SPK_2)
UART_RX: R2.1, XA1.23 (rs232RXD)
UART_TX: R1.1, XA1.25 (rs232TXD)
VDDA: J10.1, XA1.17 (VDDA)

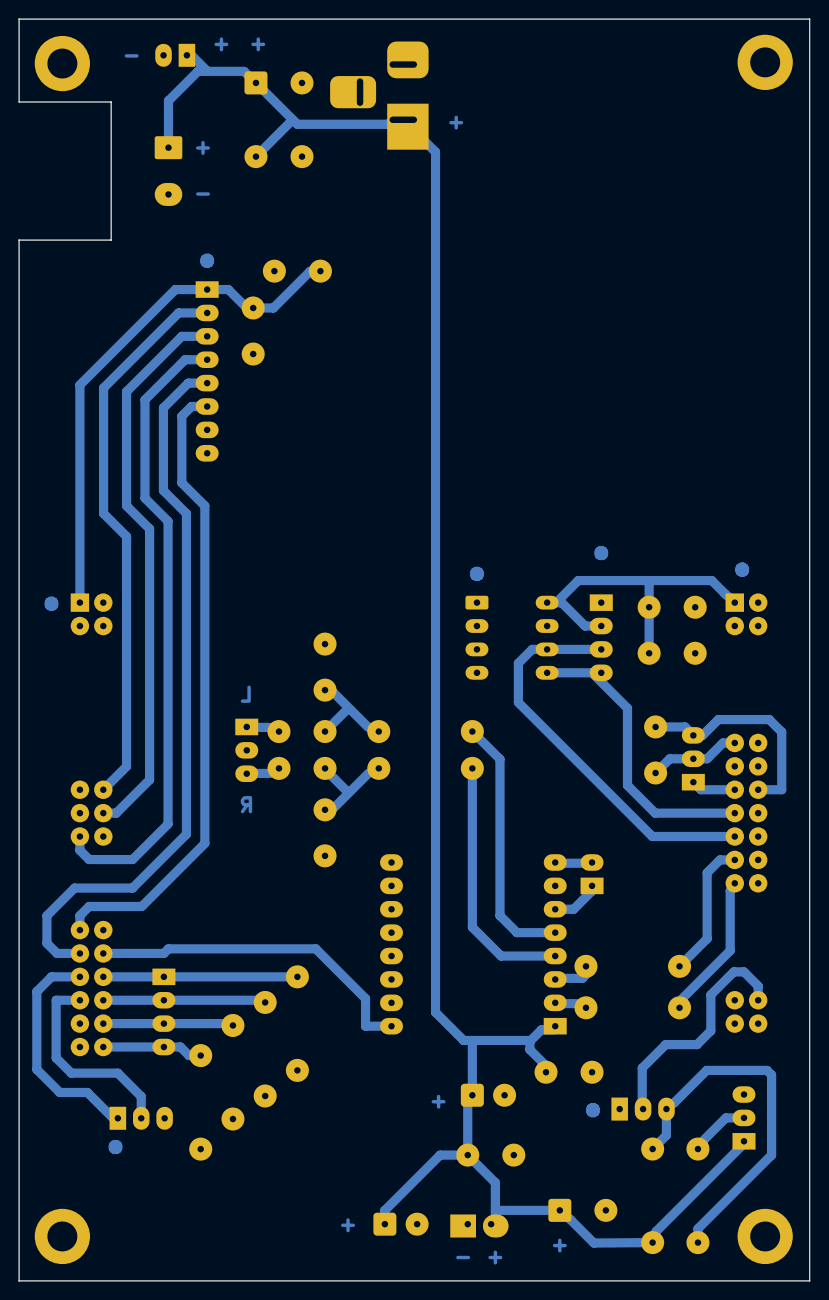
[picture p243: board JUKEBOX.kicad_pcb from above]

Board: 2 copper layers, 85.9 x 137.0 mm, 42 parts (0 on the bottom side), 36 nets.
