Fernandaxx/TallerDeProyectoI/ejemplos/lpc_open/pwm_sct/src/pwm_sct.c

/*
 * @brief State Configurable Timer (SCT) PWM example
 *
 * @note
 * Copyright(C) NXP Semiconductors, 2014
 * All rights reserved.
 *
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
 * @par
 * Permission to use, copy, modify, and distribute this software and its
 * documentation is hereby granted, under NXP Semiconductors' and its
 * licensor's relevant copyrights in the software, without fee, provided that it
 * is used in conjunction with NXP Semiconductors microcontrollers.  This
 * copyright, permission, and disclaimer notice must appear in all copies of
 * this code.
 */

#include "board.h"

/*****************************************************************************
 * Private types/enumerations/variables
 ****************************************************************************/

#define SCT_PWM            LPC_SCT

#define SCT_PWM_PIN_OUT    4        /* COUT4 Generate square wave */
#define SCT_PWM_PIN_LED    2        /* COUT2 [index 2] Controls LED */

#define SCT_PWM_OUT        1        /* Index of OUT PWM */
#define SCT_PWM_LED        2        /* Index of LED PWM */
#define SCT_PWM_RATE   10000        /* PWM frequency 10 KHz */

/* Systick timer tick rate, to change duty cycle */
#define TICKRATE_HZ     1000        /* 1 ms Tick rate */

#define LED_STEP_CNT      20        /* Change LED duty cycle every 20ms */
#define OUT_STEP_CNT    1000        /* Change duty cycle every 1 second */

/*****************************************************************************
 * Public types/enumerations/variables
 ****************************************************************************/

/*****************************************************************************
 * Private functions
 ****************************************************************************/

/* Setup board specific pin muxing */
static void app_setup_pin(void)
{
   // @Eric Este pin es el LED1 de la EDU-CIAA-NXP
	/* SCT_OUT2 on P2.10 mapped to FUNC1: */
	Chip_SCU_PinMuxSet(0x2, 10, (SCU_MODE_INACT | SCU_MODE_FUNC1));
   
   // @Eric Este pin es el LED3 de la EDU-CIAA-NXP
	/* SCT_OUT4 on P2.12 mapped to FUNC1: Oscilloscope input */
	Chip_SCU_PinMuxSet(0x2, 12, (SCU_MODE_INACT | SCU_MODE_FUNC1));
}

/*****************************************************************************
 * Public functions
 ****************************************************************************/

/**
 * @brief	Handle interrupt from SysTick timer
 * @return	Nothing
 */
 // @Eric Lo comenté porque está definido en la sAPI
//void SysTick_Handler(void)
//{
	/* This is only used to wakeup up the device from sleep */
//}

/* Example entry point */
int main(void)
{
	uint32_t cnt1 = 0, cnt2 = 0;
	int led_dp = 0, led_step = 1, out_dp = 0;

	/* Generic Initialization */
	SystemCoreClockUpdate();
	Board_Init();

	/* Initialize the SCT as PWM and set frequency */
	Chip_SCTPWM_Init(SCT_PWM);
	Chip_SCTPWM_SetRate(SCT_PWM, SCT_PWM_RATE);

	/* Setup Board specific output pin */
	app_setup_pin();

	/* Use SCT0_OUT1 pin */
	Chip_SCTPWM_SetOutPin(SCT_PWM, SCT_PWM_OUT, SCT_PWM_PIN_OUT);
	Chip_SCTPWM_SetOutPin(SCT_PWM, SCT_PWM_LED, SCT_PWM_PIN_LED);

	/* Start with 0% duty cycle */
	Chip_SCTPWM_SetDutyCycle(SCT_PWM, SCT_PWM_OUT, Chip_SCTPWM_GetTicksPerCycle(SCT_PWM)/2);
	Chip_SCTPWM_SetDutyCycle(SCT_PWM, SCT_PWM_LED, 0);
	Chip_SCTPWM_Start(SCT_PWM);


	/* Enable SysTick Timer */
	SysTick_Config(SystemCoreClock / TICKRATE_HZ);

	while (1) {
		cnt1 ++;
		cnt2 ++;
		if (cnt1 >= OUT_STEP_CNT) {
			out_dp += 10;
			if (out_dp > 100) {
				out_dp = 0;
			}

			/* Increase dutycycle by 10% every second */
			Chip_SCTPWM_SetDutyCycle(SCT_PWM, SCT_PWM_OUT,
				Chip_SCTPWM_PercentageToTicks(SCT_PWM, out_dp));
			cnt1 = 0;
		}

		if (cnt2 >= LED_STEP_CNT) {
			led_dp += led_step;
			if (led_dp < 0) {
				led_dp = 0;
				led_step = 1;
			}
			if (led_dp > 200) {
				led_dp = 200;
				led_step = -1;
			}

			/* Increment or Decrement Dutycycle by 0.5% every 10ms */
			Chip_SCTPWM_SetDutyCycle(SCT_PWM, SCT_PWM_LED,
				Chip_SCTPWM_PercentageToTicks(SCT_PWM, led_dp)/2);
			cnt2 = 0;
		}
		__WFI(); // @Eric dormir el micro hasta la proxima interrupcion (la de systick)
	}
}
