Fernandaxx/TallerDeProyectoI/ejemplos/sapi/rtos_cooperative/seos_pont_2014/microwave/src/microwave.c

/* Copyright 2017, Agustin Bassi.
 * All rights reserved.
 *
 * This file is part sAPI library for microcontrollers.
 *
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
 * 3. Neither the name of the copyright holder nor the names of its
 *    contributors may be used to endorse or promote products derived from this
 *    software without specific prior written permission.
 *
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
 *
    Copyright 2001 Georges Menie
    https://www.menie.org/georges/embedded/small_printf_source_code.html

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
	putchar is the only external dependency for this file,
	if you have a working putchar, just remove the following
	define. If the function should be called something else,
	replace outbyte(c) by your own function call.
 */

/*
 * Date: 2017-11-23
 */

/*==================[inlcusiones]============================================*/

#include "sapi.h"        // <= sAPI header

#include "seos_pont_2014_isr.h"       // <= dispatcher and task management header
#include "seos_pont_2014_scheduler.h" // <= scheduler and system initialization header

/*==================[definiciones y macros]==================================*/

CONSOLE_PRINT_ENABLE

// Tiempos de coccion asociados a las teclas
#define TIEMPO_COCCION_1		10
#define TIEMPO_COCCION_2		20
#define TIEMPO_COCCION_3		30

/**
 * En este enum se definen las entradas y
 * salidas que tendra el microondas de una
 * manera descriptiva. Notar que los valores
 * son los mismos que los pines que utiliza
 * la biblioteca sAPI.
 */
typedef enum PinMicroondas {
	TEC_20_SEG   = TEC1,//!< TEC_20_SEG
	TEC_40_SEG   = TEC2,//!< TEC_40_SEG
	TEC_60_SEG   = TEC3,//!< TEC_60_SEG
	TEC_COMENZAR = TEC4,//!< TEC_COMENZAR
	MOTOR        = LEDB,//!< MOTOR
	LUZ          = LED1,//!< LUZ
	ALARMA       = LED3 //!< ALARMA
} PinMicroondas_t;

// Nuevo tipo de datos enumerado llamado estadoMEF
typedef enum{
	BUTTON_UP,      // Mientras el bot�n est� liberado.
	BUTTON_FALLING, // Mientras esta ocurriendo el flanco descendente, hace el anti-rebote.
	BUTTON_RISING,  // Mientras esta ocurriendo el flanco ascendente, hace el anti-rebote.
	BUTTON_DOWN     // Mientras eNl bot�n est� presionado.
} EstadoMefDebounce_t;

/*==================[definiciones de datos internos]=========================*/

/** Variable que se va a setear con distintos delay en funcion del
 * tiempo seleccionado con las teclas TEC_20_SEG, TEC_40_SEG, TEC_60_SEG */
static int32_t TiempoCoccion = TIEMPO_COCCION_1;
static bool_t FlagFuncionamiento = FALSE;

/*==================[definiciones de datos externos]=========================*/

/*==================[declaraciones de funciones internas]====================*/

static void	EjecutarMefDebounceParametric	( EstadoMefDebounce_t * estadoMefDebounce, uint8_t teclaToRead);

/*==================[declaraciones de funciones externas]====================*/

void TareaTec1( void* taskParam );
void TareaTec2( void* taskParam );
void TareaTec3( void* taskParam );
void TareaTec4( void* taskParam );
void TareaRealizarCoccion( void* taskParam );
void TareaMostrarTiempo( void* taskParam );

/*==================[funcion principal]======================================*/

/**
 * @brief Descripcion del funcionamiento del microondas con SO Pont.
 *
 * - Las teclas TEC1, TEC2 y TEC3 ingresan un tiempo de coccion del
 *   microondas de 20, 40 y 60 segundos respectivamente.
 * - La tecla TEC4 confirma el comienzo del funcionamiento del microondas.
	 Mientras esta funcionando el microondas se debe:
		- Encender el motor del microondas mediante el LEDB.
		- Encender la luz del microondas mediante el LED1.
		- Mostrar en la UART USB el tiempo restante para terminar la coccion.
		- Decrementar el valor del tiempo de coccion.
	 Cuando paso el tiempo (se llego a 0) se debe prender la alarma
	 mediante el LED3 avisando al usuario que la coccion esta realizada.
*/

int main( void ){

	// ---------- CONFIGURACIONES ------------------------------
	// Inicializar y configurar la plataforma
	boardConfig();

	uartConfig( UART_USB, 115200 );

	// FUNCION que inicializa el planificador de tareas
   schedulerInit();

	schedulerAddTask( TareaTec1, 0, 0, 40 );
	schedulerAddTask( TareaTec2, 0, 10, 40 );
	schedulerAddTask( TareaTec3, 0, 20, 40 );
	schedulerAddTask( TareaTec4, 0, 30, 40 );
	schedulerAddTask( TareaRealizarCoccion, 0, 40, 1000 );
	schedulerAddTask( TareaMostrarTiempo, 0, 50, 1000 );

	schedulerStart( 1 );

	// ---------- REPETIR POR SIEMPRE --------------------------
	while( TRUE ){
		schedulerDispatchTasks();
	}
	return 0;
}

/*==================[definiciones de funciones internas]=====================*/

/**
 * Maquina de estados parametrizable para la lectura de teclas con antirrebote.
 * @param estadoMefDebounce estado anterior de la tecla
 * @param teclaToRead tecla a leer
 */
static void	EjecutarMefDebounceParametric( 
               EstadoMefDebounce_t * estadoMefDebounce, 
               uint8_t teclaToRead){
	switch(*estadoMefDebounce) {
		case BUTTON_UP:
			if( !gpioRead(teclaToRead) ){
				*estadoMefDebounce = BUTTON_FALLING;
			}
			break;
		case BUTTON_FALLING:
			if( !gpioRead(teclaToRead) ){
				*estadoMefDebounce = BUTTON_DOWN;
			} else{
				*estadoMefDebounce = BUTTON_UP;
			}
			break;
		case BUTTON_RISING:  // Mientras esta ocurriendo el flanco ascendente,
			if( gpioRead(teclaToRead) ){
				*estadoMefDebounce = BUTTON_UP;
			} else{
				*estadoMefDebounce = BUTTON_DOWN;
			}
			break;
		case BUTTON_DOWN:
			if( gpioRead(teclaToRead) ){
				*estadoMefDebounce = BUTTON_RISING;
			}
			break;
		default:
			*estadoMefDebounce = BUTTON_UP;
			break;
	}
}

/*==================[definiciones de funciones externas]=====================*/

void TareaTec1( void* taskParam ){
   static EstadoMefDebounce_t estadoDebounce = BUTTON_UP;
	EjecutarMefDebounceParametric(&estadoDebounce, TEC_20_SEG);
	if (estadoDebounce == BUTTON_DOWN){
		TiempoCoccion = TIEMPO_COCCION_1;
	}
}

void TareaTec2( void* taskParam ){
   static EstadoMefDebounce_t estadoDebouce = BUTTON_UP;
	EjecutarMefDebounceParametric(&estadoDebouce, TEC_40_SEG);
	if (estadoDebouce == BUTTON_DOWN){
		TiempoCoccion = TIEMPO_COCCION_2;
	}
}

void TareaTec3( void* taskParam ){
   static EstadoMefDebounce_t estadoDebounce = BUTTON_UP;
	EjecutarMefDebounceParametric(&estadoDebounce, TEC_60_SEG);
	if (estadoDebounce == BUTTON_DOWN){
		TiempoCoccion = TIEMPO_COCCION_3;
	}
}

void TareaTec4( void* taskParam ){
   static EstadoMefDebounce_t estadoDebounce = BUTTON_UP;
	EjecutarMefDebounceParametric(&estadoDebounce, TEC_COMENZAR);
	if (estadoDebounce == BUTTON_DOWN){
		FlagFuncionamiento = TRUE;
		gpioWrite(MOTOR, TRUE);
		gpioWrite(LUZ, TRUE);
		gpioWrite(ALARMA, FALSE);
	}
}

void TareaRealizarCoccion( void* taskParam ){
	if (FlagFuncionamiento == TRUE){
		if (--TiempoCoccion == 0){
			gpioWrite(MOTOR, FALSE);
			gpioWrite(LUZ, FALSE);
		} else if (TiempoCoccion < 0 && TiempoCoccion > -6){
			gpioToggle(ALARMA);
		} else if (TiempoCoccion < -7){
			gpioWrite(ALARMA, FALSE);
			FlagFuncionamiento = FALSE;
		}
	}
}

void TareaMostrarTiempo( void* taskParam ){
	if (FlagFuncionamiento == TRUE && TiempoCoccion >=0){
		consolePrintString("Tiempo restante: ");
		consolePrintInt(TiempoCoccion);
		consolePrintString("\n\r");
	}
}


/*==================[fin del archivo]========================================*/
