Fernandaxx/TallerDeProyectoI/ejemplos/sapi/mobile/sim808/at_uart_bridge/src/at_uart_bridge.c

/* Copyright 2016, Ian Olivieri.
 * Copyright 2016, Eric Pernia.
 * All rights reserved.
 *
 * This file is part sAPI library for microcontrollers.
 *
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
 * 3. Neither the name of the copyright holder nor the names of its
 *    contributors may be used to endorse or promote products derived from this
 *    software without specific prior written permission.
 *
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
 */

/*
 * Date: 2016-04-26
 */

/* 
SIM808 Board connections:

   +--------------------------------------+
   |                                      |      
   |                                      |      
   |                                      |      
   |                                      |      
   |                                      |      
   |                                      |      
   |                                      |           
   |      RX o o VCC                      |
   |   GPIO0 o o RST                      |         
   | VCC_MCU o o CH_PD                    |
   |     GND o o GND                      |
   +--------------------------------------+
   
   Use an external power supply for SIM808 board and:
   VCC_MCU SIM808 Module <--> +3.3V EDU-CIAA-NXP
       GND SIM808 Module <--> GND EDU-CIAA-NXP
        TX SIM808 Module <--> 232_RX EDU-CIAA-NXP
        RX SIM808 Module <--> 232_TX EDU-CIAA-NXP

  AT commands: http://www.pridopia.co.uk/pi-doc/ESP8266ATCommandsSet.pdf
*/

/*==================[inclusions]=============================================*/

#include "sapi.h"     // <= sAPI header

/*==================[macros and definitions]=================================*/

#define BAUD_RATE 9600 // Baudrate por defecto del SIM808

/*==================[internal data declaration]==============================*/

/*==================[internal functions declaration]=========================*/

/*==================[internal data definition]===============================*/

/*==================[external data definition]===============================*/

/*==================[internal functions definition]==========================*/

/*==================[external functions definition]==========================*/

void imprimirMensajeDeBienvenida( void ){

   /* Imprimo el mensaje de bienvenida */
   uartWriteString( UART_USB,
      "Bievenido al asistente de configuracion del modulo ESP8266\r\n" );
   uartWriteString( UART_USB,
      "Antes de continuar, por favor asegurese que su terminal\r\n" );
   uartWriteString( UART_USB,
      "serie dispone del terminador CR+LF (enter)\r\n\r\n" );
   uartWriteString( UART_USB,
      "A continuacion se realiza un listado de algunos de los\r\n" );
   uartWriteString( UART_USB, "comandos AT disponibles:\r\n\r\n" );
   uartWriteString( UART_USB,
      "> Saber si el modulo responde correctamente: AT\r\n" );
   uartWriteString( UART_USB,
      "> Version del Firmware: AT+GMR\r\n" );
   uartWriteString( UART_USB, "> Resetear el modulo: AT+RST\r\n" );
   uartWriteString( UART_USB,
      "> Listar todas las redes disponibles: AT+CWLAP\r\n" );
   uartWriteString( UART_USB,
      "> Checkear la red actual: AT+CWJAP?\r\n" );
   uartWriteString( UART_USB,
      "> Unirse a una red: AT+CWJAP=\"nombreRedInalambrica\",\"password\"\r\n" );
   uartWriteString( UART_USB,
      "  - NOTA: Las comillas dobles son parte del mensaje\r\n" );
   uartWriteString( UART_USB,
      "> Salir de la red: AT+CWQAP\r\n" );

   delay(100);
}


/* FUNCION PRINCIPAL, PUNTO DE ENTRADA AL PROGRAMA LUEGO DE RESET. */
int main(void){

   /* ------------- INICIALIZACIONES ------------- */

   /* Inicializar la placa */
   boardConfig();

   /* Inicializar las UART a 115200 baudios */
   uartConfig( UART_USB, BAUD_RATE );
   uartConfig( UART_232, BAUD_RATE );

   uint8_t dato  = 0;
   
   //imprimirMensajeDeBienvenida();
   
   // Prueba de vida
   gpioWrite(LEDB, ON);
   delay(1000);
   gpioWrite(LEDB, OFF);
   
   
   /* ------------- REPETIR POR SIEMPRE ------------- */
   while(1) {

      /* Si presionan TEC1 muestro el mensaje de bienvenida */
      if( !gpioRead( TEC1 ) ){
         gpioWrite( LEDB, ON );
         imprimirMensajeDeBienvenida();
         gpioWrite( LEDB, OFF );
      }

      /* Si recibe un byte de la UART_USB lo guardarlo en la variable dato. */
      if( uartReadByte( UART_USB, &dato ) ){
         /* Se reenvía el dato a la UART_232 realizando un puente entre ambas */
         uartWriteByte( UART_232, dato );
      }

      /* Si recibe un byte de la UART_232 lo guardarlo en la variable dato. */
      if( uartReadByte( UART_232, &dato ) ){
         /* Se reenvía el dato a la UART_USB realizando un puente entre ambas */
         uartWriteByte( UART_USB, dato );
      }

   }

   /* NO DEBE LLEGAR NUNCA AQUI, debido a que a este programa no es llamado
      por ningun S.O. */
   return 0 ;
}

/*==================[end of file]============================================*/
