Fernandaxx/TallerDeProyectoI/ejemplos/sapi/rtc/rtc_uart/src/rtc_uart.c

/* Copyright 2016, Eric Pernia.
 * All rights reserved.
 *
 * This file is part sAPI library for microcontrollers.
 *
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
 * 3. Neither the name of the copyright holder nor the names of its
 *    contributors may be used to endorse or promote products derived from this
 *    software without specific prior written permission.
 *
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
 */

/*
 * Date: 2016-07-03
 */

/*==================[inclusions]=============================================*/

#include "sapi.h"    // <= sAPI header

/*==================[macros and definitions]=================================*/

/*==================[internal data declaration]==============================*/

/*==================[internal functions declaration]=========================*/

/*==================[internal data definition]===============================*/

/*==================[external data definition]===============================*/

/* Buffer */
static char uartBuff[10];

/*==================[internal functions definition]==========================*/

/*==================[external functions definition]==========================*/


/**
 * C++ version 0.4 char* style "itoa":
 * Written by Lukás Chmela
 * Released under GPLv3.

 */
char* itoa(int value, char* result, int base) {
   // check that the base if valid
   if (base < 2 || base > 36) { *result = '\0'; return result; }

   char* ptr = result, *ptr1 = result, tmp_char;
   int tmp_value;

   do {
      tmp_value = value;
      value /= base;
      *ptr++ = "zyxwvutsrqponmlkjihgfedcba9876543210123456789abcdefghijklmnopqrstuvwxyz" [35 + (tmp_value - value * base)];
   } while ( value );

   // Apply negative sign
   if (tmp_value < 0) *ptr++ = '-';
   *ptr-- = '\0';
   while(ptr1 < ptr) {
      tmp_char = *ptr;
      *ptr--= *ptr1;
      *ptr1++ = tmp_char;
   }
   return result;
}


/* Enviar fecha y hora en formato "DD/MM/YYYY, HH:MM:SS" */
void showDateAndTime( rtc_t * rtc ){
   /* Conversion de entero a ascii con base decimal */
   itoa( (int) (rtc->mday), (char*)uartBuff, 10 ); /* 10 significa decimal */
   /* Envio el dia */
   if( (rtc->mday)<10 )
      uartWriteByte( UART_USB, '0' );
   uartWriteString( UART_USB, uartBuff );
   uartWriteByte( UART_USB, '/' );

   /* Conversion de entero a ascii con base decimal */
   itoa( (int) (rtc->month), (char*)uartBuff, 10 ); /* 10 significa decimal */
   /* Envio el mes */
   if( (rtc->month)<10 )
      uartWriteByte( UART_USB, '0' );
   uartWriteString( UART_USB, uartBuff );
   uartWriteByte( UART_USB, '/' );

   /* Conversion de entero a ascii con base decimal */
   itoa( (int) (rtc->year), (char*)uartBuff, 10 ); /* 10 significa decimal */
   /* Send year */
   if( (rtc->year)<10 )
      uartWriteByte( UART_USB, '0' );
   uartWriteString( UART_USB, uartBuff );


   uartWriteString( UART_USB, ", ");


   /* Conversion de entero a ascii con base decimal */
   itoa( (int) (rtc->hour), (char*)uartBuff, 10 ); /* 10 significa decimal */
   /* Envio la hora */
   if( (rtc->hour)<10 )
      uartWriteByte( UART_USB, '0' );
   uartWriteString( UART_USB, uartBuff );
   uartWriteByte( UART_USB, ':' );

   /* Conversion de entero a ascii con base decimal */
   itoa( (int) (rtc->min), (char*)uartBuff, 10 ); /* 10 significa decimal */
   /* Envio los minutos */
  // uartBuff[2] = 0;    /* NULL */
   if( (rtc->min)<10 )
      uartWriteByte( UART_USB, '0' );
   uartWriteString( UART_USB, uartBuff );
   uartWriteByte( UART_USB, ':' );

   /* Conversion de entero a ascii con base decimal */
   itoa( (int) (rtc->sec), (char*)uartBuff, 10 ); /* 10 significa decimal */
   /* Envio los segundos */
   if( (rtc->sec)<10 )
      uartWriteByte( UART_USB, '0' );
   uartWriteString( UART_USB, uartBuff );


   /* Envio un 'enter' */
   uartWriteString( UART_USB, "\r\n");
}


/* FUNCION PRINCIPAL, PUNTO DE ENTRADA AL PROGRAMA LUEGO DE RESET. */
int main(void){

   /* ------------- INICIALIZACIONES ------------- */
   boardInit(); // Inicializar la plataforma

   uartConfig( UART_USB, 115200 ); // Inicializar UART_USB a 115200 baudios

   /* Estructura RTC */
   rtc_t rtc;

   rtc.year = 2018;
   rtc.month = 8;
   rtc.mday = 13;
   rtc.wday = 1;
   rtc.hour = 19;
   rtc.min = 25;
   rtc.sec= 0;

   bool_t val = 0;
   uint8_t i = 0;

   uartWriteString( UART_USB, "Inicializar RTC\r\n" );
   rtcInit(); // Inicializar RTC
 
   uartWriteString( UART_USB, "Establecer fecha y hora\r\n" );
   rtcWrite( &rtc ); // Establecer fecha y hora

   delay_t delay1s;
   delayConfig( &delay1s, 1000 );

   delay(2000); // El RTC tarda en setear la hora, por eso el delay

   for( i=0; i<10; i++ ){
      /* Leer fecha y hora */
      val = rtcRead( &rtc );
      /* Mostrar fecha y hora en formato "DD/MM/YYYY, HH:MM:SS" */
      showDateAndTime( &rtc );
      delay(1000);
   }

   rtc.year = 2016;
   rtc.month = 7;
   rtc.mday = 3;
   rtc.wday = 1;
   rtc.hour = 14;
   rtc.min = 30;
   rtc.sec = 0;

   /* Establecer fecha y hora */
   uartWriteString( UART_USB, "Establecer fecha y hora\r\n" );
   val = rtcWrite( &rtc );

   /* ------------- REPETIR POR SIEMPRE ------------- */
   while(1) {

      if( delayRead( &delay1s ) ){
         /* Leer fecha y hora */
         val = rtcRead( &rtc );
         /* Mostrar fecha y hora en formato "DD/MM/YYYY, HH:MM:SS" */
         showDateAndTime( &rtc );
      }

   }

   /* NO DEBE LLEGAR NUNCA AQUI, debido a que a este programa no es llamado
      por ningun S.O. */
   return 0 ;
}

/*==================[end of file]============================================*/
