Fernandaxx/TallerDeProyectoI/ejemplos/sapi/statecharts/2_blink/src/main.c

/* Copyright 2017, Pablo Ridolfi, Juan Esteban Alarcon, Juan Manuel Cruz
 * All rights reserved.
 *
 * This file is part of Workspace.
 *
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
 * 3. Neither the name of the copyright holder nor the names of its
 *    contributors may be used to endorse or promote products derived from this
 *    software without specific prior written permission.
 *
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
 */
 
/** @brief This is a simple statechart example using Yakindu Statechart Tool
 * Plug-in (update site: http://updates.yakindu.org/sct/mars/releases/).
 */

/** \addtogroup statechart Simple UML Statechart example.
 ** @{ */

/*==================[inclusions]=============================================*/

#include "main.h"

#include "sapi.h"       // <= sAPI header

/* Include statechart header file. Be sure you run the statechart C code
 * generation tool!
 */
#include "Blink.h"
#include "TimerTicks.h"


/*==================[macros and definitions]=================================*/

#define TICKRATE_1MS	(1)				/* 1000 ticks per second */
#define TICKRATE_MS		(TICKRATE_1MS)	/* 1000 ticks per second */


/*==================[internal data declaration]==============================*/

volatile bool SysTick_Time_Flag = false;

/*! This is a state machine */
static Blink statechart;

/*! This is a timed state machine that requires timer services */
#define NOF_TIMERS (sizeof(BlinkTimeEvents)/sizeof(sc_boolean))

TimerTicks ticks[NOF_TIMERS];


/*==================[internal functions declaration]=========================*/

/*==================[internal data definition]===============================*/

/*==================[external data definition]===============================*/

/*==================[internal functions definition]==========================*/

/*==================[external functions definition]==========================*/

/*! \file This header defines prototypes for all functions that are required
 *  by the state machine implementation.
 *
 *  This is a state machine uses time events which require access to a timing
 *  service. Thus the function prototypes:
 *  - blink_setTimer and
 *  - blink_unsetTimer
 *  are defined.
 *
 *  This state machine makes use of operations declared in the state machines
 *  interface or internal scopes. Thus the function prototypes:
 *  - blinkIface_opLED
 *  are defined.
 *
 *  These functions will be called during a 'run to completion step' (runCycle)
 *  of the statechart.
 *  There are some constraints that have to be considered for the
 *  implementation of these functions:
 *  - never call the statechart API functions from within these functions.
 *  - make sure that the execution time is as short as possible.
 */

/** state machine user-defined external function (action)
 *
 * @param handle state machine instance
 * @param LEDNumber number of LED
 * @param onoff state machine operation parameter
 */
void blinkIface_opLED( Blink* handle, sc_integer LEDNumber, sc_boolean State )
{
	gpioWrite( (LEDR + LEDNumber), State );
}


/*! * This is a timed state machine that requires timer services
 */

/*! This function has to set up timers for the time events that are required
 *  by the state machine.
 */
/*! This function will be called for each time event that is relevant for a
 *  state when a state will be entered.
 *  \param evid An unique identifier of the event.
 *  \time_ms The time in milli seconds
 *  \periodic Indicates the the time event must be raised periodically until
 *   the timer is unset
 */
void blink_setTimer( Blink* handle, const sc_eventid evid, const sc_integer time_ms, const sc_boolean periodic )
{
	SetNewTimerTick(ticks, NOF_TIMERS, evid, time_ms, periodic);
}

/*! This function has to unset timers for the time events that are required
 *  by the state machine.
 */
/*! This function will be called for each time event that is relevant for a
 *  state when a state will be left.
 *  \param evid An unique identifier of the event.
 */
void blink_unsetTimer( Blink* handle, const sc_eventid evid )
{
	UnsetTimerTick( ticks, NOF_TIMERS, evid );
}


/**
 * @brief	Hook on Handle interrupt from SysTick timer
 * @return	Nothing
 */
void myTickHook( void *ptr ){

	/* The sysTick Interrupt Handler only set a Flag */
	SysTick_Time_Flag = true;
}


/**
 * @brief	main routine for statechart example: EDU-CIAA-NXP - Blink LED3
 * @return	Function should not exit.
 */
int main(void)
{
	uint32_t i;

	/* Generic Initialization */
	boardConfig();

	/* Init Ticks counter => TICKRATE_MS */
	tickConfig( TICKRATE_MS );

	/* Add Tick Hook */
	tickCallbackSet( myTickHook, (void*)NULL );

	/* Init Timer Ticks */
	InitTimerTicks( ticks, NOF_TIMERS );

	/* Statechart Initialization */
	blink_init( &statechart );
	blink_enter( &statechart );

	/* LED state is toggled in the main program */
	while (1) {
		/* The uC sleeps waiting for an interruption */
		__WFI();

		/* When a interrupt wakes to the uC, the main program validates it,
		 * checking the waited Flag */
		if (SysTick_Time_Flag == true) {

			/* Then reset its Flag */
			SysTick_Time_Flag = false;

			/* Then Update all Timer Ticks */
			UpdateTimers( ticks, NOF_TIMERS );

			/* Then Scan all Timer Ticks */
			for (i = 0; i < NOF_TIMERS; i++) {

				/* Then if there are pending events */
				if (IsPendEvent( ticks, NOF_TIMERS, ticks[i].evid ) == true) {

					/* Then Raise an Event -> Ticks.evid => OK */
					blink_raiseTimeEvent( &statechart, ticks[i].evid );

					/* Then Mark as Attached -> Ticks.evid => OK */
					MarkAsAttEvent( ticks, NOF_TIMERS, ticks[i].evid );
				}
			}

			/* Then Run an Cycle of Statechart */
			blink_runCycle(&statechart);		// Run Cycle of Statechart
		}
	}
}


/** @} doxygen end group definition */

/*==================[end of file]============================================*/
