Fernandaxx/TallerDeProyectoI/ejemplos/sapi/keypad_7segment/7segment_refresh_libNew/src/app.c

#include "sapi.h"        // <= Biblioteca sAPI

#define COMMON_CATHODE
//#define COMMON_ANODE

#ifdef COMMON_CATHODE
#define DIGIT_ON       0
#define DIGIT_OFF      1
#define PIN_VALUE_ON   1
#define PIN_VALUE_OFF  0
#endif

#ifdef COMMON_ANODE
#define DIGIT_ON       1
#define DIGIT_OFF      0
#define PIN_VALUE_ON   0
#define PIN_VALUE_OFF  1
#endif

#define TIEMPO_ON 500

/* Configuracion de pines para el display 7 segmentos */
/*
--------------------------+------------+-----------+----------------
 Segmento encendido       | Valor BIN  | Valor HEX | GPIO resultado
--------------------------+------------+-----------+----------------
 Enciende el segmento 'a' | 0b00000001 |   0x01    | GPIO0
 Enciende el segmento 'b' | 0b00000010 |   0x02    | GPIO4
 Enciende el segmento 'c' | 0b00000100 |   0x04    | GPIO3
 Enciende el segmento 'd' | 0b00001000 |   0x08    | GPIO7
 Enciende el segmento 'e' | 0b00010000 |   0x10    | GPIO6
 Enciende el segmento 'f' | 0b00100000 |   0x20    | GPIO2
 Enciende el segmento 'g' | 0b01000000 |   0x40    | GPIO1
 Enciende el segmento 'h' | 0b10000000 |   0x80    | GPIO5
--------------------------+------------+-----------+----------------

---------------------------------+------------+-----------+----------------
 Digito encendido                | Valor BIN  | Valor HEX | GPIO resultado
---------------------------------+------------+-----------+----------------
Enciende el digito unidad        | 0b00000001 |   0x01    | LCD3
Enciende el digito decena        | 0b00000010 |   0x02    | LCD2
Enciende el digito centena       | 0b00000100 |   0x04    | LCD1
Enciende el digito unidad de mil | 0b00001000 |   0x08    | LCD4
---------------------------------+------------+-----------+----------------
             a
           -----
       f /     / b
        /  g  /
        -----
    e /     / c
     /  d  /
     -----    O h = dp (decimal point).

*/



// Symbols formed by segmens
/*
------------+------+---------
  Segmentos | HEX  | Simbolo
------------+------+---------
   hgfedcba |      |
 0b00111111 | 0x0F |   0
 0b00000110 | 0x00 |   1
 0b01011011 | 0x00 |   2
 0b01001111 | 0x00 |   3
 0b01100110 | 0x00 |   4
 0b01101101 | 0x00 |   5
 0b01111101 | 0x00 |   6
 0b00000111 | 0x00 |   7
 0b01111111 | 0x00 |   8
 0b01101111 | 0x00 |   9

 0b01011111 | 0x00 |   a 10
 0b01111100 | 0x00 |   b 11
 0b01011000 | 0x00 |   c 12
 0b01011110 | 0x00 |   d 13
 0b01111011 | 0x00 |   e 14
 0b01110001 | 0x00 |   F 15

 0b01110111 | 0x00 |   A 16
 0b00111001 | 0x00 |   C 17
 0b01111001 | 0x00 |   E 18
 0b01110110 | 0x00 |   H
 0b00011110 | 0x00 |   J
 0b00111000 | 0x00 |   L
 0b01110011 | 0x00 |   P
 0b00111110 | 0x00 |   U

 0b10000000 | 0x00 |   .

             a
           -----
       f /     / b
        /  g  /
        -----
    e /     / c
     /  d  /
     -----    O h = dp (decimal point).

*/



#define DISPLAY_OFF 25

const uint8_t display7SegmentOut[26] = {
   0b00111111, // 0
   0b00000110, // 1
   0b01011011, // 2
   0b01001111, // 3
   0b01100110, // 4
   0b01101101, // 5
   0b01111101, // 6
   0b00000111, // 7
   0b01111111, // 8
   0b01101111, // 9

   0b01011111, // a
   0b01111100, // b
   0b01011000, // c
   0b01011110, // d
   0b01111011, // e
   0b01110001, // f

   0b01110111, // A
   0b00111001, // C
   0b01111001, // E
   0b01110110, // H
   0b00011110, // J
   0b00111000, // L
   0b01110011, // P
   0b00111110, // U

   0b10000000, // .

   0b00000000  // display off
};

gpioMap_t valor[] = {
   GPIO0,  // a
   GPIO4,  // b
   GPIO3,  // c
   GPIO7,  // d
   GPIO6,  // e
   GPIO2,  // f
   GPIO1,  // g
   GPIO5   // h = dp
};

gpioMap_t digito[] = {
   //LCD4, // D4
   LCD3, // D3
   LCD2, // D2
   LCD1  // D1
};


void displayMostrarDigito( uint8_t val, uint8_t dig );
void displayRefresh( void );
void displayMostrar( uint16_t val );

// FUNCION PRINCIPAL, PUNTO DE ENTRADA AL PROGRAMA LUEGO DE ENCENDIDO O RESET.
int main( void )
{
   // ---------- CONFIGURACIONES ------------------------------

   // Inicializar y configurar la plataforma
   boardConfig();

   uint32_t i = 0;
   
   for( i=0; i<8; i++ ) {
      gpioInit( valor[i], GPIO_OUTPUT );
   }

   for( i=0; i<3; i++ ) {
      gpioInit( digito[i], GPIO_OUTPUT );
   }

   gpioWrite( digito[0], DIGIT_OFF );
   gpioWrite( digito[1], DIGIT_OFF );
   gpioWrite( digito[2], DIGIT_OFF );

   for( i=0; i<8; i++ ) {
      gpioWrite( valor[i], PIN_VALUE_OFF );
   }

   delay_t delayRefresh;
   delayInit( &delayRefresh, 5 );

   delay_t delayMostrarValores;
   delayInit( &delayMostrarValores, 100 );

   // ---------- REPETIR POR SIEMPRE --------------------------
   while( TRUE ) {

      if( delayRead(&delayRefresh) ){
         displayRefresh();
      }

      if( delayRead(&delayMostrarValores) ){
         displayMostrar( i );
         i++;
         if( i>=1000 ){
            i=0;
         }
         // i = (i+1)%1000;
      }

   }
   return 0;
}


void displayMostrarDigito( uint8_t val, uint8_t dig )
{
   uint8_t j = 0;     
   gpioWrite( digito[dig], DIGIT_ON );
   for( j=0; j<8; j++ ) {
      if( display7SegmentOut[val] & (1<<j) ) {
         gpioWrite( valor[j], PIN_VALUE_ON );
      } else {
         gpioWrite( valor[j], PIN_VALUE_OFF );
      }
   }
}


uint8_t digitosAMostrar[3] = { DISPLAY_OFF, DISPLAY_OFF, DISPLAY_OFF };

void displayRefresh( void )
{   
   static uint8_t digitoAMostrar = 0;
   
   uint8_t i = 0;
   for( i=0; i<3; i++ ) {
      gpioWrite( digito[i], DIGIT_OFF );
   }
   
   if(digitoAMostrar <= 2){
      displayMostrarDigito( digitosAMostrar[digitoAMostrar], digitoAMostrar );
      digitoAMostrar++;
   } else{
      digitoAMostrar=0;
   }
}

void displayMostrar( uint16_t val )
{   
   if( val <= 999 ){
      digitosAMostrar[2] = val/100;      // centena
      digitosAMostrar[1] = (val%100)/10; // decena
      digitosAMostrar[0] = val%10;       // unidad
   }
   if( val <= 99 ){
      digitosAMostrar[2] = DISPLAY_OFF;  // centena
   }
   if( val <= 9 ){
      digitosAMostrar[1] = DISPLAY_OFF;  // decena
   }
}




/*
#include "sapi.h"

// FUNCION PRINCIPAL, PUNTO DE ENTRADA AL PROGRAMA LUEGO DE ENCENDIDO O RESET.
int main( void )
{
   boardInit();
   
   uint32_t contador = 0;
   // ---------- REPETIR POR SIEMPRE --------------------------
   while( TRUE ) {
      if( contador > 5000 ){
         gpioToggle(LEDB);
         contador = 0;
      }
      delay(1);
      contador++;
      gpioWrite( LED1, !gpioRead(TEC1) );
   }
   return 0;
}
*/


/*
#include "sapi.h"

// FUNCION PRINCIPAL, PUNTO DE ENTRADA AL PROGRAMA LUEGO DE ENCENDIDO O RESET.
int main( void )
{
   boardInit();
   
   delay_t delayLed;
   delayInit( &delayLed, 5 );
   
   // ---------- REPETIR POR SIEMPRE --------------------------
   while( TRUE ) {
      if( delayRead(&delayLed) ){
         displayRefresh(LEDB);
      }
      gpioWrite( LED1, !gpioRead(TEC1) );
   }
   return 0;
}
*/



/*
delay_t refrescarDisplay;

delayInit( &refrescarDisplay, 5 );

delayRead( &refrescarDisplay );
*/

      
/*
      7 / 5 = cociente = 1
      7 % 5 = resto = 2
      
    7   | 5
   -5   -------
    2     1
*/      




/*
#include "sapi.h"

// FUNCION PRINCIPAL, PUNTO DE ENTRADA AL PROGRAMA LUEGO DE ENCENDIDO O RESET.
int main( void )
{
   boardInit();
   // ---------- REPETIR POR SIEMPRE --------------------------
   while( TRUE ) {
      gpioToggle(LEDB);
      delay(100);
   }
   return 0;
}
*/
