Fernandaxx/TallerDeProyectoI/ejemplos/sapi/uart/rx_interrupt/src/rx_interrupt.c

#include "sapi.h"

void onRx( void *noUsado )
{
   char c = uartRxRead( UART_USB );
   printf( "Recibimos <<%c>> por UART\r\n", c );
}

int main(void)
{
   /* Inicializar la placa */
   boardConfig();

   /* Inicializar la UART_USB junto con las interrupciones de Tx y Rx */
   uartConfig(UART_USB, 115200);     
   // Seteo un callback al evento de recepcion y habilito su interrupcion
   uartCallbackSet(UART_USB, UART_RECEIVE, onRx, NULL);
   // Habilito todas las interrupciones de UART_USB
   uartInterrupt(UART_USB, true);
   
   while(TRUE) {
      // Una tarea muy bloqueante para demostrar que la interrupcion funcina
      gpioToggle(LEDB);
      delay(1000);
   }
   return 0;
}
