Fernandaxx/TallerDeProyectoI/ejemplos/sapi/rtos_cooperative/seos_pont_2014/uart_clock/src/app.c

/*============================================================================
 * License: BSD-3-Clause
 * Copyright 2018, Eric Pernia <ericpernia@gmail.com>
 * All rights reserved.
 * Date: 2018/10/04
 *===========================================================================*/

// The maximum number of tasks required at any one time during the execution
// of the program. MUST BE ADJUSTED FOR EACH NEW PROJECT
#define SCHEDULER_MAX_TASKS   (2)

/*==================[inlcusiones]============================================*/

//#include "cooperative_os_scheduler_03_seos_Pont2014.h"   // <= own header (optional)
#include "sapi.h"        // <= sAPI header

#include "task_clock.h"
#include "task_uart.h"

#include "seos_pont_2014_isr.h"       // <= dispatcher and task management header
#include "seos_pont_2014_scheduler.h" // <= scheduler and system initialization header

/*==================[definiciones y macros]==================================*/

/*==================[definiciones de datos internos]=========================*/

/*==================[definiciones de datos externos]=========================*/

/*==================[declaraciones de funciones internas]====================*/

/*==================[declaraciones de funciones externas]====================*/

/*==================[funcion principal]======================================*/

// FUNCION PRINCIPAL, PUNTO DE ENTRADA AL PROGRAMA LUEGO DE ENCENDIDO O RESET.
int main( void ){

   // ---------- CONFIGURACIONES ------------------------------
   // Inicializar y configurar la plataforma
   boardConfig();
   
   taskClockInit( 19, 0, 0 ); // Inicializar tarea de Reloj
   taskUartInit( 115200 );    // Inicializar tarea de UART

   // FUNCION que inicializa el planificador de tareas
   schedulerInit();

   // Se agrega la tarea taskClock al planificador
   schedulerAddTask( taskClock, // funcion de tarea a agregar
                     0,         // parametro de la tarea
                     0,         // offset de ejecucion en ticks
                     1000       // periodicidad de ejecucion en ticks
                   );

   // Se agrega la tarea taskUart al planificador cada 5 ticks, offset 1 tick
   schedulerAddTask( taskUart, 0, 1, 5 );

   // FUNCION que inicializa la interrupcion que ejecuta el planificador de
   // tareas con tick cada 1ms.
   schedulerStart( 1 );

   // ---------- REPETIR POR SIEMPRE --------------------------
   while( TRUE )
   {
      // Se despachan (ejecutan) las tareas marcadas para su ejecucion.
      // Luego se pone el sistema en bajo consumo hasta que ocurra la
      // proxima interrupcion, en este caso la de Tick.
      // Al ocurrir la interrupcion de Tick se ejecutara el planificador
      // que revisa cuales son las tareas a marcar para su ejecucion.
      schedulerDispatchTasks();
   }

   // NO DEBE LLEGAR NUNCA AQUI, debido a que a este programa se ejecuta
   // directamenteno sobre un microcontroladore y no es llamado por ningun
   // Sistema Operativo, como en el caso de un programa para PC.
   return 0;
}

/*==================[definiciones de funciones internas]=====================*/

/*==================[definiciones de funciones externas]=====================*/

/*==================[fin del archivo]========================================*/
