Fernandaxx/TallerDeProyectoI/ejemplos/lpc_open/adc_fir_dac/src/bandpass.c

/*
 * bandpass.c
 *
 *  Created on: Sep 7, 2013
 *      Author: Pablo
 */

/*

FIR filter designed with
http://t-filter.appspot.com

sampling frequency: 22000 Hz

fixed point precision: 31 bits

* 0 Hz - 500 Hz
  gain = 0
  desired attenuation = -40 dB
  actual attenuation = -50.91 dB

* 900 Hz - 1100 Hz
  gain = 1
  desired ripple = 5 dB
  actual ripple = 1.17 dB

* 1500 Hz - 11000 Hz
  gain = 0
  desired attenuation = -40 dB
  actual attenuation = -50.91 dB

*/

#include "bandpass.h"

const int bandpass_taps[BANDPASS_TAP_NUM] = {
  2681055,
  722773,
  3686706,
  5787101,
  6259894,
  5680356,
  4738733,
  3478138,
  1456845,
  -1675962,
  -5829996,
  -10530915,
  -15177492,
  -19207769,
  -22108090,
  -23370437,
  -22520649,
  -19208189,
  -13310349,
  -5011033,
  5192443,
  16528278,
  28001030,
  38467176,
  46747764,
  51735584,
  52533848,
  48594373,
  39780807,
  26458574,
  9466308,
  -9904644,
  -30028281,
  -49075790,
  -65194643,
  -76696422,
  -82237127,
  -80974177,
  -72676123,
  -57776432,
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
};
