Fernandaxx/TallerDeProyectoI/ejemplos/lpc_open/adc_fir_dac/src/lowpass.c

/*
 * lowpass.c
 *
 *  Created on: Sep 4, 2013
 *      Author: Pablo
 */

#include "lowpass.h"

const int lowpass_taps[LOWPASS_TAP_NUM] = {
		-8858824,
		  6003323,
		  12563243,
		  22554988,
		  34445997,
		  46183080,
		  55268898,
		  59164851,
		  55788691,
		  44095689,
		  24536209,
		  -703795,
		  -27799499,
		  -51730180,
		  -67033220,
		  -68753208,
		  -53419173,
		  -19871629,
		  30257820,
		  92516531,
		  160137980,
		  224962013,
		  278706724,
		  314171785,
		  326566858,
		  314171785,
		  278706724,
		  224962013,
		  160137980,
		  92516531,
		  30257820,
		  -19871629,
		  -53419173,
		  -68753208,
		  -67033220,
		  -51730180,
		  -27799499,
		  -703795,
		  24536209,
		  44095689,
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
};
