Fernandaxx/TallerDeProyectoI/ejemplos/rkh/blinky_bm/app/inc/blinky.h

/**
 *  \file       bkliny.h
 *  \brief      Example application.
 */

/* -------------------------- Development history -------------------------- */
/*
 *  2016.03.17  LeFr  v1.0.00  Initial version
 */

/* -------------------------------- Authors -------------------------------- */
/*
 *  LeFr  Leandro Francucci  francuccilea@gmail.com
 */

/* --------------------------------- Notes --------------------------------- */
/* --------------------------------- Module -------------------------------- */
#ifndef __BLINKY_H__
#define __BLINKY_H__

/* ----------------------------- Include files ----------------------------- */
#include "rkh.h"

/* ---------------------- External C language linkage ---------------------- */
#ifdef __cplusplus
extern "C" {
#endif

/* --------------------------------- Macros -------------------------------- */
/* -------------------------------- Constants ------------------------------ */
/* ................................ Signals ................................ */
typedef enum Signals
{
    TIMEOUT,        /* timeout */
    TERMINATE,		/* press the key escape on the keyboard */
    BLINKY_NUM_EVENTS
} Signals;

/* ........................ Declares active object ......................... */
RKH_SMA_DCLR( blinky );

/* ------------------------------- Data types ------------------------------ */
/* -------------------------- External variables --------------------------- */
/* -------------------------- Function prototypes -------------------------- */
/* -------------------- External C language linkage end -------------------- */
#ifdef __cplusplus
}
#endif

/* ------------------------------ Module end ------------------------------- */
#endif

/* ------------------------------ End of file ------------------------------ */
