Fernandaxx/TallerDeProyectoI/ejemplos/rkh/shared_freertos/app/inc/client.h

/**
 *  \file       client.h
 *  \brief      Example application
 */

/* -------------------------- Development history -------------------------- */
/*
 *  2016.03.17  LeFr  v1.0.00  Initial version
 */

/* -------------------------------- Authors -------------------------------- */
/*
 *  LeFr  Leandro Francucci  lf@vortexmakes.com
 */

/* --------------------------------- Notes --------------------------------- */
/* --------------------------------- Module -------------------------------- */
#ifndef __CLIENT_H__
#define __CLIENT_H__

/* ----------------------------- Include files ----------------------------- */
#include "rkh.h"
#include "shared.h"

/* ---------------------- External C language linkage ---------------------- */
#ifdef __cplusplus
extern "C" {
#endif

/* --------------------------------- Macros -------------------------------- */
#define CLI(clino_)     RKH_ARRAY_SMA(clis, clino_)
#define CLI0            CLI(0)
#define CLI1            CLI(1)
#define CLI2            CLI(2)
#define CLI3            CLI(3)
#define CLI_STK_SIZE    (2048 / sizeof(RKH_THREAD_STK_TYPE))

/* -------------------------------- Constants ------------------------------ */
/* ................................ Signals ................................ */
/* ........................ Declares active object ......................... */
enum
{
    CLI_PRIO_0 = 1, CLI_PRIO_1, CLI_PRIO_2, CLI_PRIO_3,
    MAX_CLI_PRIO,
    NUM_CLIENTS = MAX_CLI_PRIO - 1,
};

RKH_ARRAY_SMA_DCLR( clis, NUM_CLIENTS );

/* ------------------------------- Data types ------------------------------ */
/* -------------------------- External variables --------------------------- */
/* -------------------------- Function prototypes -------------------------- */
/* -------------------- External C language linkage end -------------------- */
#ifdef __cplusplus
}
#endif

/* ------------------------------ Module end ------------------------------- */
#endif

/* ------------------------------ End of file ------------------------------ */
