Fernandaxx/TallerDeProyectoI/(commit log)

2026-09-03 Agrego borrador de informe inicial en Typst
2026-09-24 firmware v3
    [CIAA-Z3R0 bom_v0.2.xls, lpc4337.cfg, lpc4337_new.cfg, lpc4337_old.cfg]
2026-09-29 acomodé estructura
    [CIAA-Z3R0 bom_v0.2.xls, lpc4337.cfg, lpc4337_new.cfg, lpc4337_old.cfg]
2026-09-29 kicad borrador
    [Tocadiscos_RFID.kicad_pcb, Tocadiscos_RFID.kicad_sch]
2026-09-29 Algunos pines
    [Tocadiscos_RFID.kicad_sch]
2026-09-29 pines del motor(que seguro hay que cambiar)
    [Tocadiscos_RFID.kicad_sch]
2026-09-30 Esquematico del poncho
    [JUKEBOX.kicad_pcb, JUKEBOX.kicad_sch]
2026-10-01 Motor (principal), Neopixels (secundario)
2026-10-02 Actualizacion: neopixel + buffer 74AHCT125
    [JUKEBOX.kicad_sch]
2026-10-02 Actualizacion de esquematico sobre correciones de Jose y redaccion de informe de avance.
    [JUKEBOX.kicad_sch]
2026-10-03 Actualizacion: Se agrego la seccion de diseño de software.
2026-10-05 intento de pantalla que no anda
2026-10-05 Correcciones para que coincida con TP1.
2026-10-05 makefile que compila cualquier carpeta dentro de src
2026-10-18 Agrego u8g2 para la oled. Acomodo pantallas. Principio de MEF (provisional)
2026-10-21 lector rfid, motor y neopixel
2026-11-02 servicio de efectos
2026-11-02 biblioteca de discos
2026-11-04 PCB del poncho y seccion de hardware del Avance 2
2026-11-05 Informe-Drivers y servicios
