Fernandaxx/TallerDeProyectoI/(notices)

Notices in the files:
ejemplos/rkh/blinky_bm/bsp/src/bsp.c:
RKH is free software: you can redistribute it and/or modify it under the
terms of the GNU General Public License as published by the Free Software
ejemplos/sapi/rtos_cooperative/seos_pont_2014/microwave/src/microwave.c:
This program is free software; you can redistribute it and/or modify
it under the terms of the GNU Lesser General Public License as published by
the Free Software Foundation; either version 2 of the License, or
(at your option) any later version.
